Pacificzhong/humanoid_robot/others/Pictures/Untitled.JPG

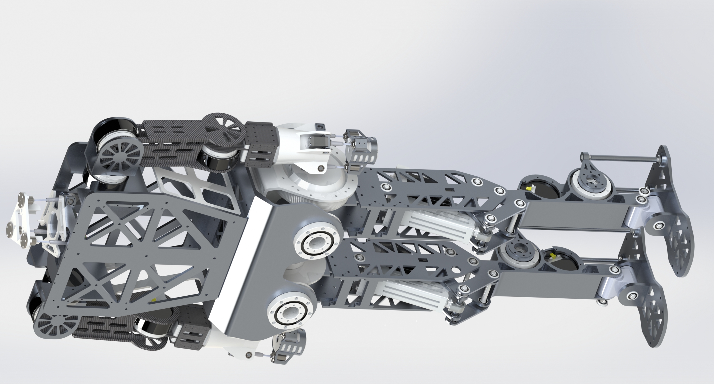
others/Pictures/Untitled.JPG
