Pacificzhong/humanoid_robot/others/Pictures/膝关节.JPG

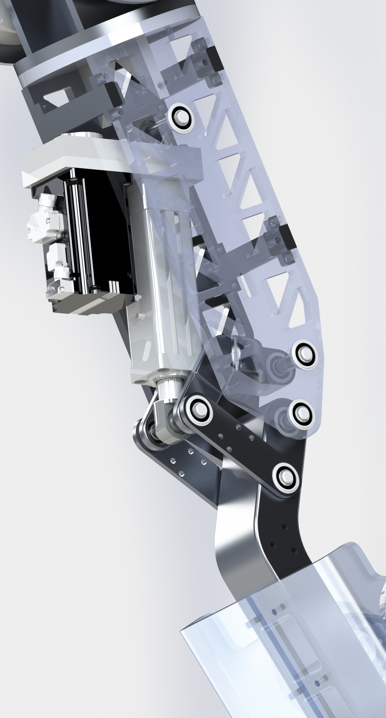
others/Pictures/膝关节.JPG
