Pacificzhong/humanoid_robot/others/Presentation/仲24.4.23人形机器人关键技术.pptx

直线电机驱动人形机器人—结构

- 面向工业制造场景对人形机器人需求，研发具有高稳定性的人形机器人结构，要求机器人具有高负载、高稳态、高效率。

- 核心零部件：行星滚轴丝杠直线电机

人形机器人本体

手臂结构

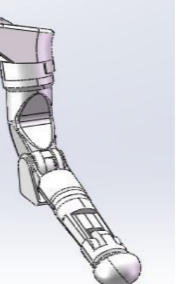
[picture p37: figure]
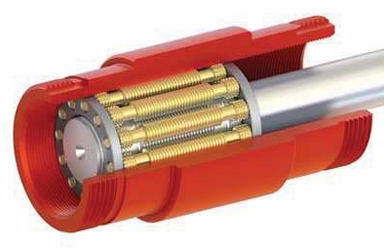
[picture p38: figure]

行星丝杠执行器

1.8kg自重→8000N
推力自重比：>400

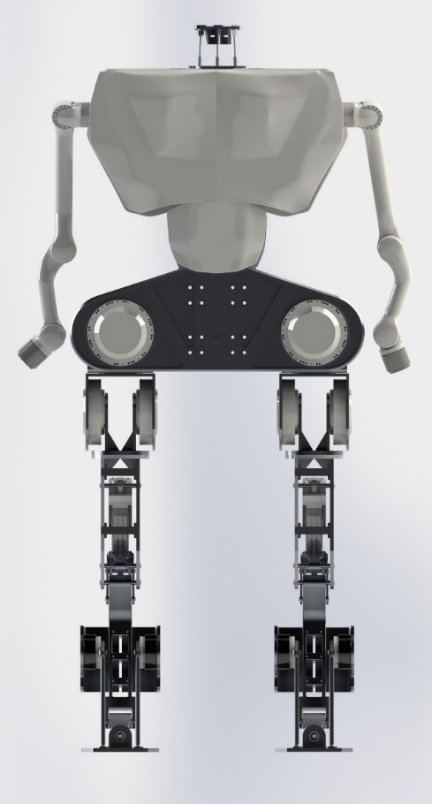
[picture p39: figure]

手腕并联结构

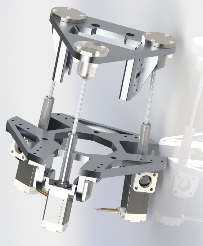
[picture p40: figure]

双足结构

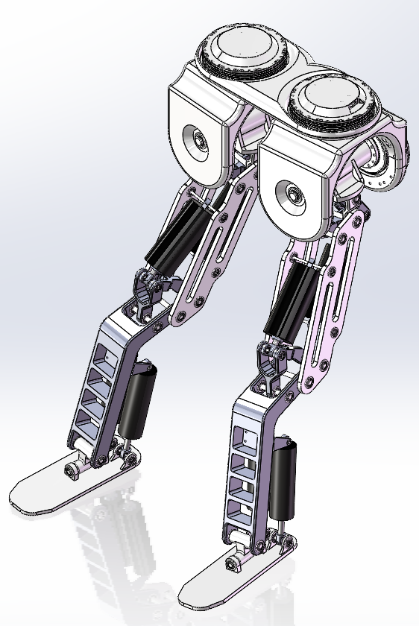
[picture p41: figure]
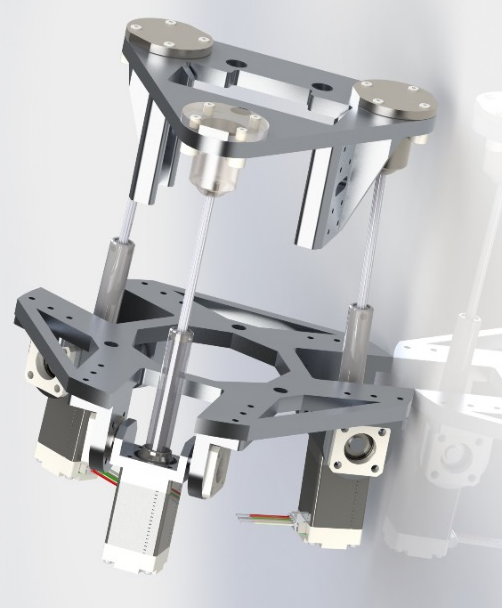
[picture p42: figure]

高推力→站得稳

3PRS结构→灵巧手腕

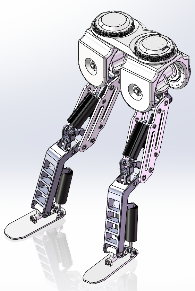
[picture p43: figure]

1

## Slide 2

直线电机驱动人形机器人—结构

- 面向工业制造场景对人形机器人需求，研发具有高稳定性的人形机器人结构，要求机器人具有高负载、高稳态、高效率。

人形机器人本体

手臂结构

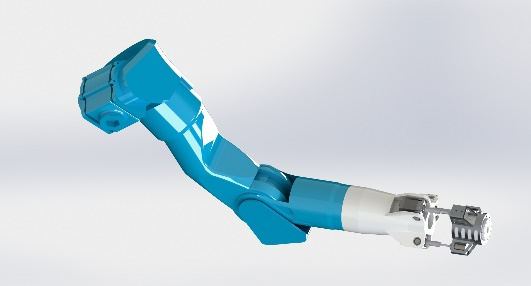
[picture p44: figure]

双足结构

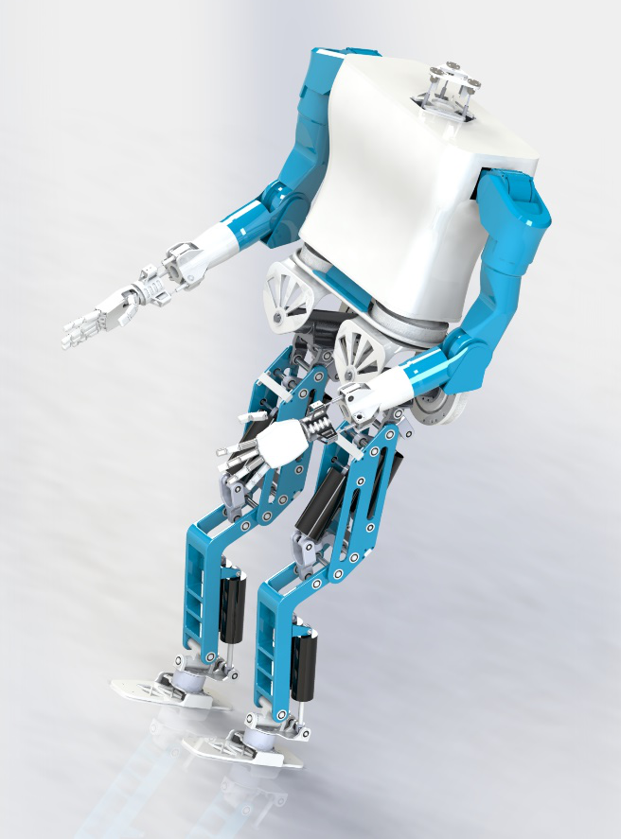
[picture p45: figure]
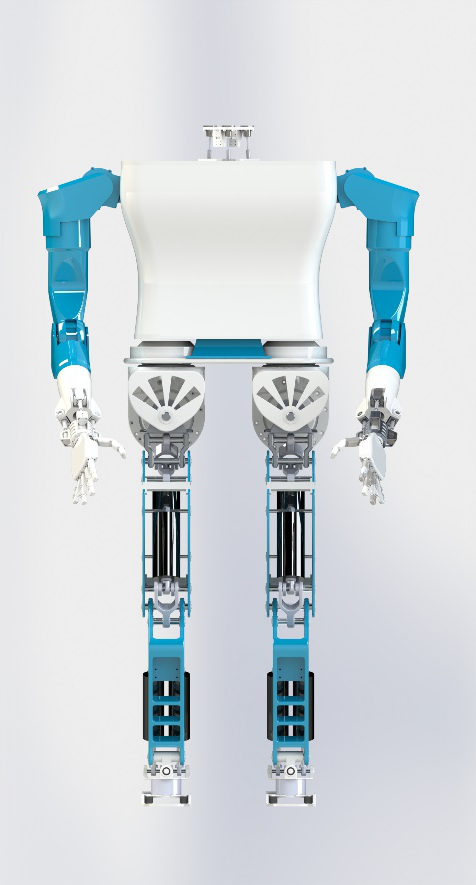
[picture p46: figure]
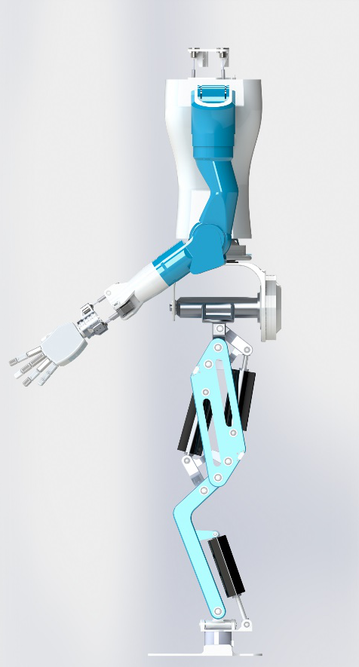
[picture p47: figure]
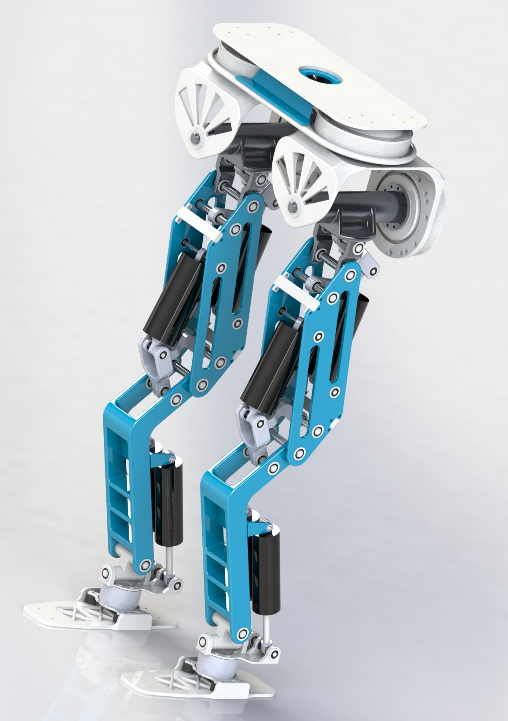
[picture p48: figure]

手腕并联结构

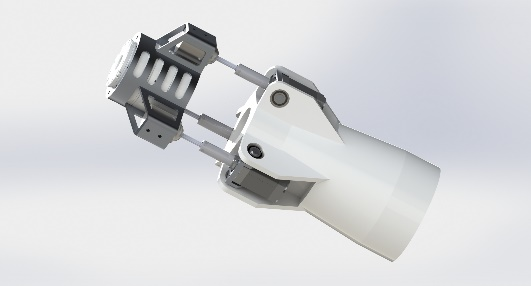
[picture p49: figure]

2

## Slide 3

直线电机驱动人形机器人—结构

- 面向工业制造场景对人形机器人需求，研发具有高稳定性的人形机器人结构，要求机器人具有高负载、高稳态、高效率。

- 核心零部件：行星滚轴丝杠直线电机

1.8kg自重→8000N
推力自重比：>400

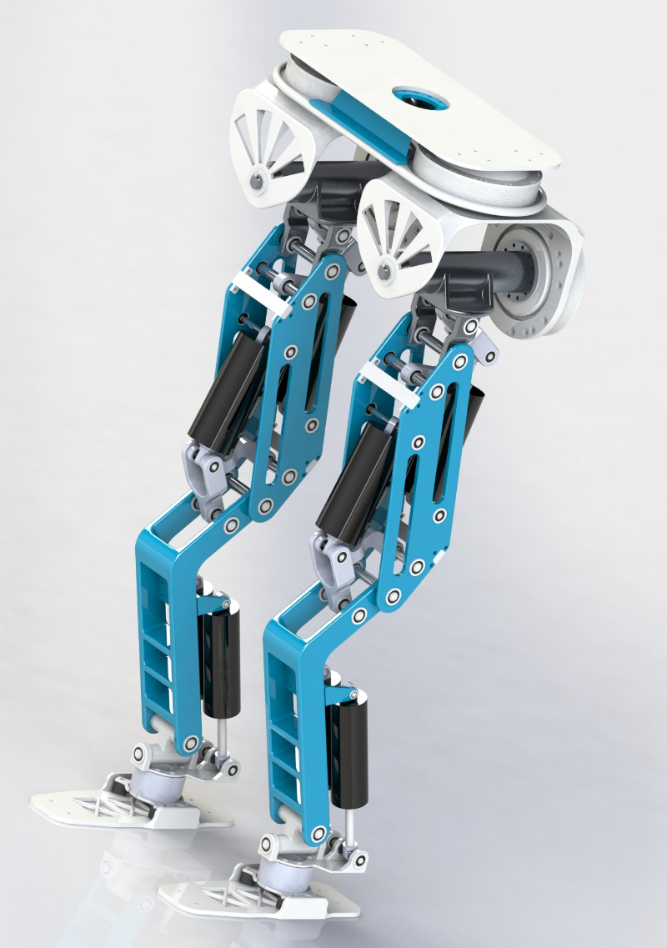
[picture p50: figure]

行星丝杠执行器

高推力→站得稳

3

## Slide 4

直线电机驱动人形机器人—感知

- 面向工业制造场景对人形机器人需求，搭配多维感知体系，助力人形机器人走得稳、抓得稳、导航准

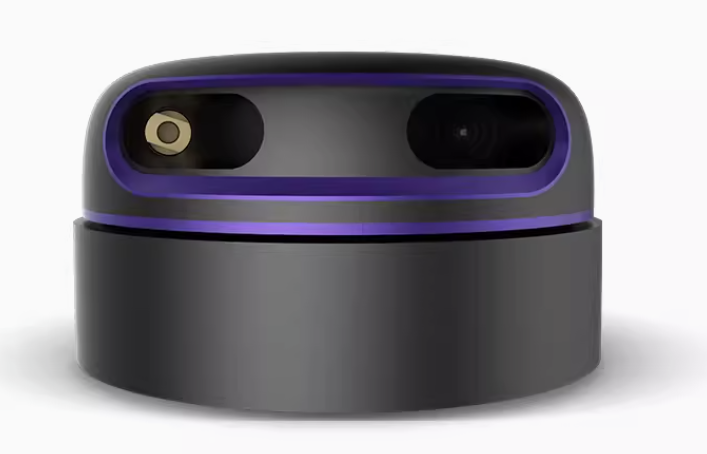
[picture p51: figure]

激光雷达、双目相机（还未完成联调）

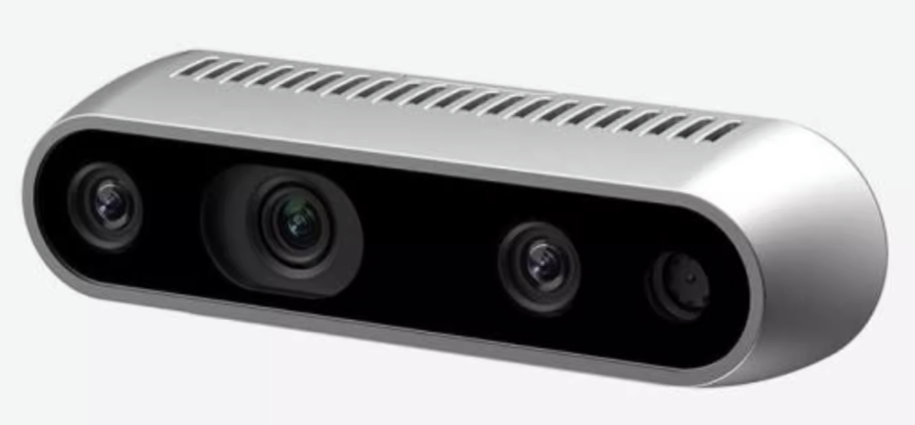
[picture p52: figure]
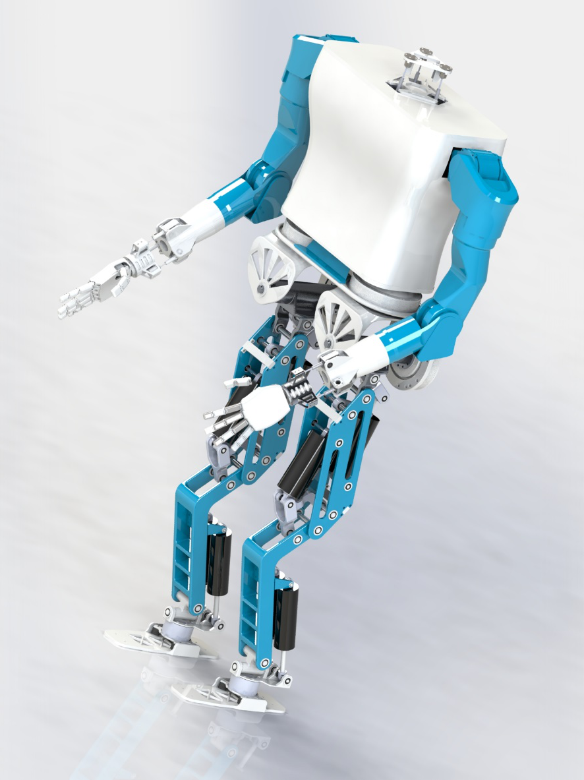
[picture p53: figure]

中央IMU

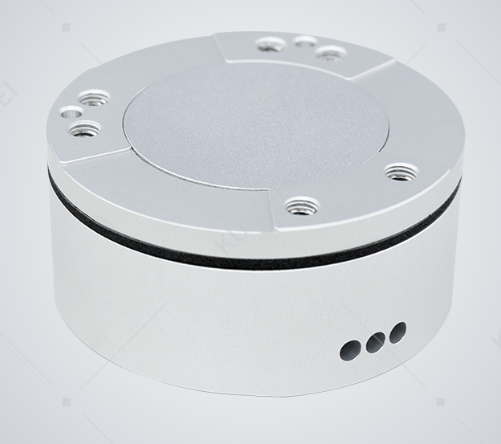
[picture p54: figure]

足底六维力传感器

4
