Pacificzhong/humanoid_robot/others/Pictures/4-六维力传感器.JPG

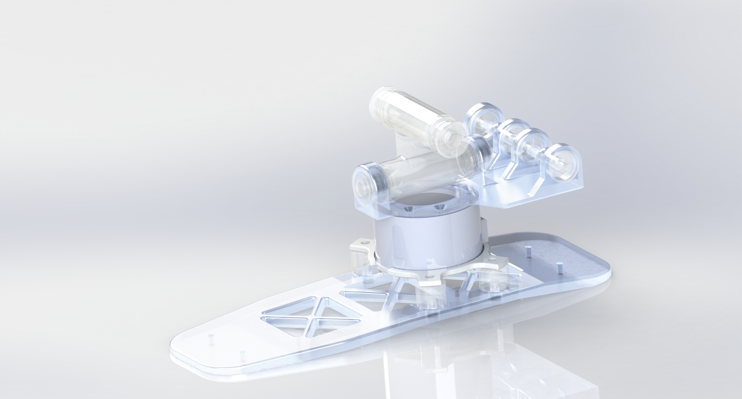
others/Pictures/4-六维力传感器.JPG
