Pacificzhong/humanoid_robot/others/Pictures/4-减震柱.JPG

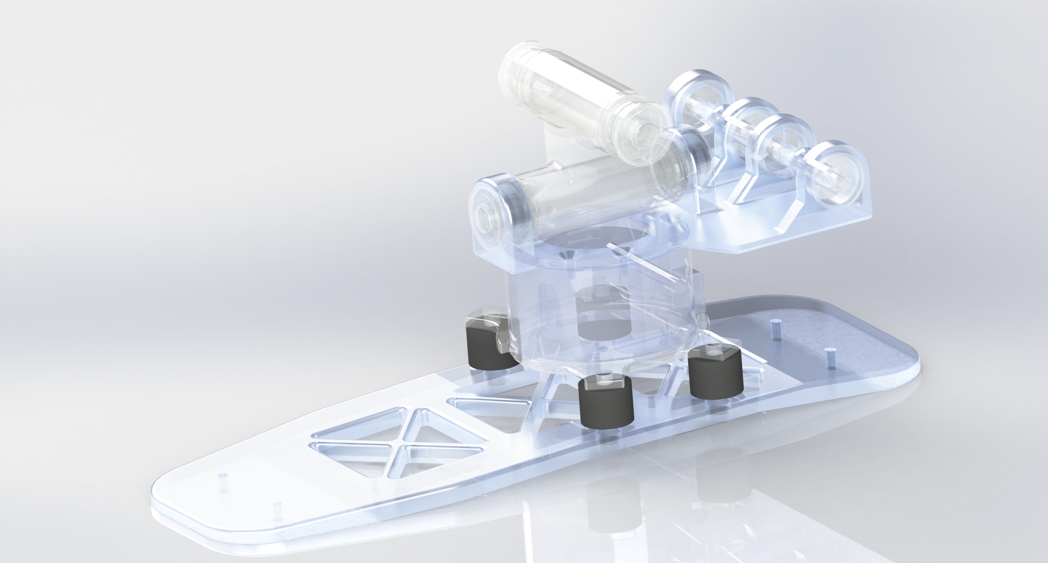
others/Pictures/4-减震柱.JPG
