Pacificzhong/humanoid_robot/others/Pictures/4-脚板.JPG

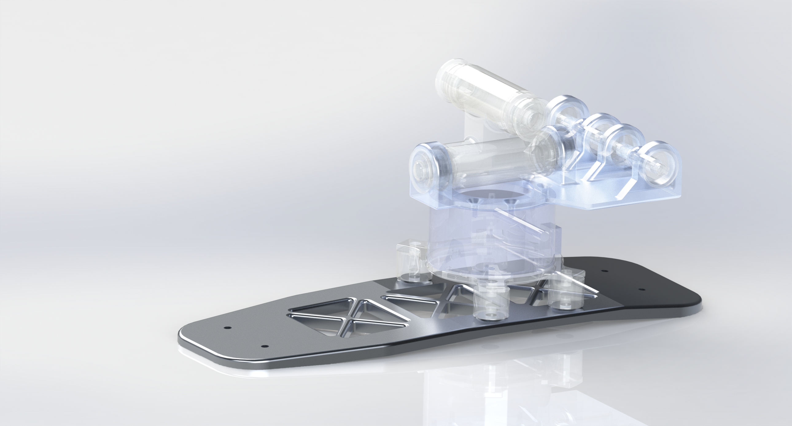
others/Pictures/4-脚板.JPG
