Pacificzhong/humanoid_robot/others/Pictures/4-踝.JPG

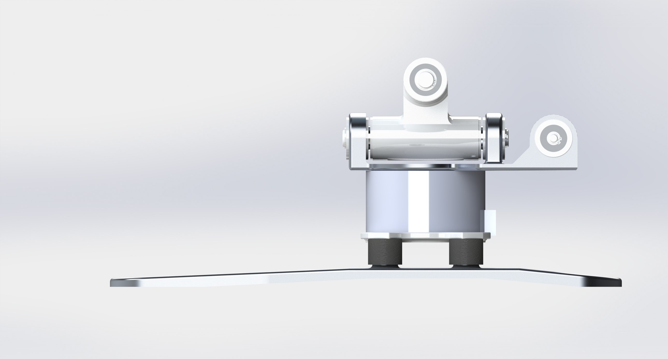
others/Pictures/4-踝.JPG
