Pacificzhong/humanoid_robot/others/Pictures/4-踝关节.JPG

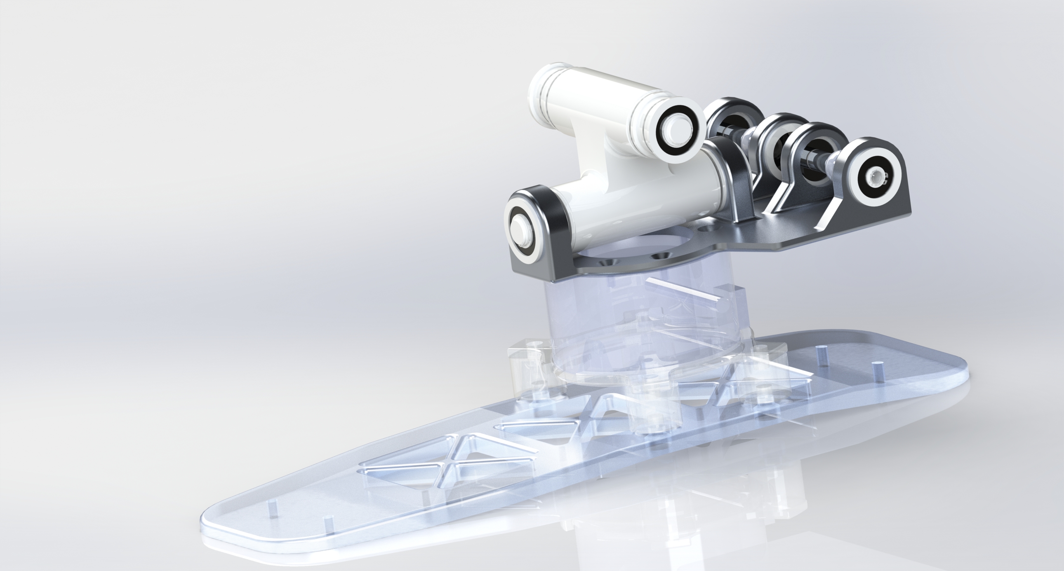
others/Pictures/4-踝关节.JPG
