Pacificzhong/humanoid_robot/others/Pictures/45°踢腿.JPG

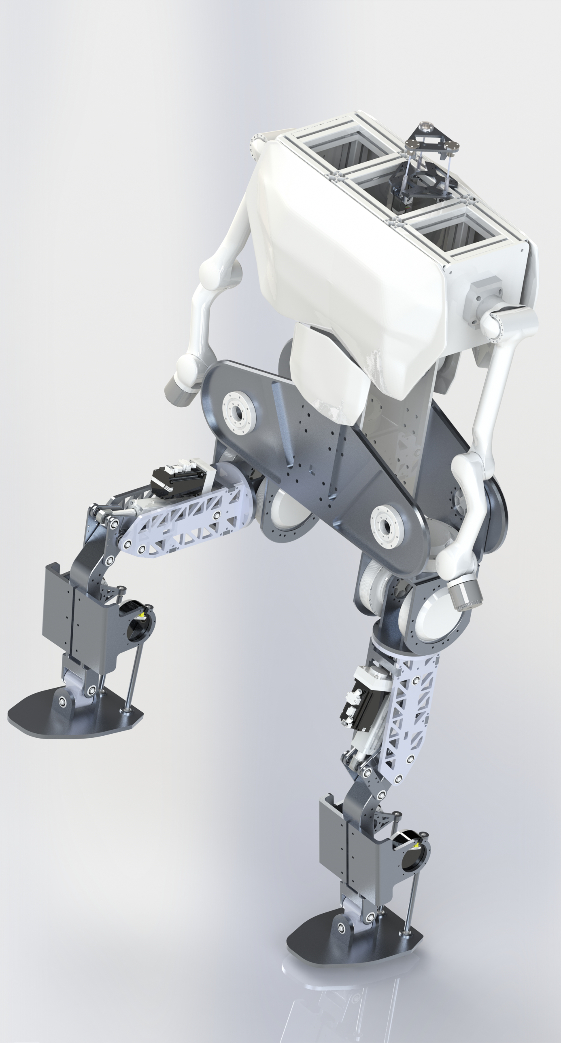
others/Pictures/45°踢腿.JPG
