Pacificzhong/humanoid_robot/others/Pictures/三代机大腿.JPG

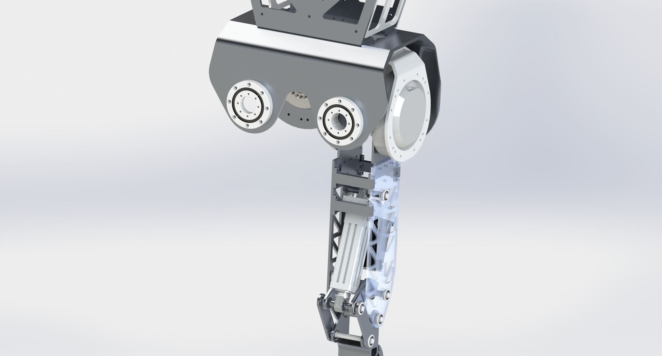
others/Pictures/三代机大腿.JPG
