Pacificzhong/humanoid_robot/others/Pictures/三代机脚踝.JPG

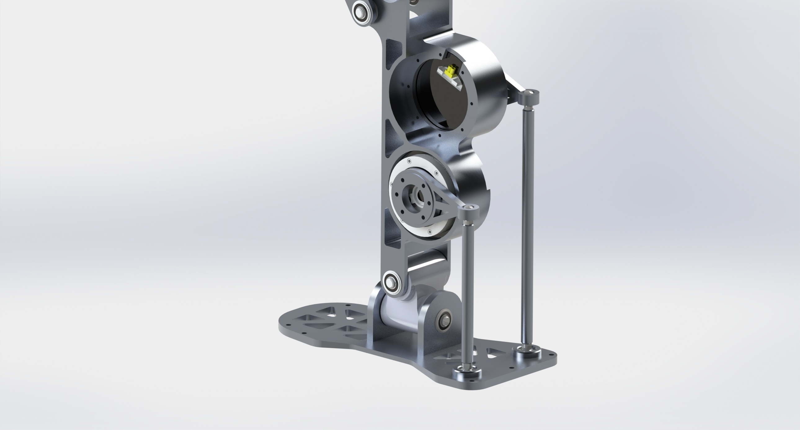
others/Pictures/三代机脚踝.JPG
