Pacificzhong/humanoid_robot/others/Pictures/三代机膝关节.JPG

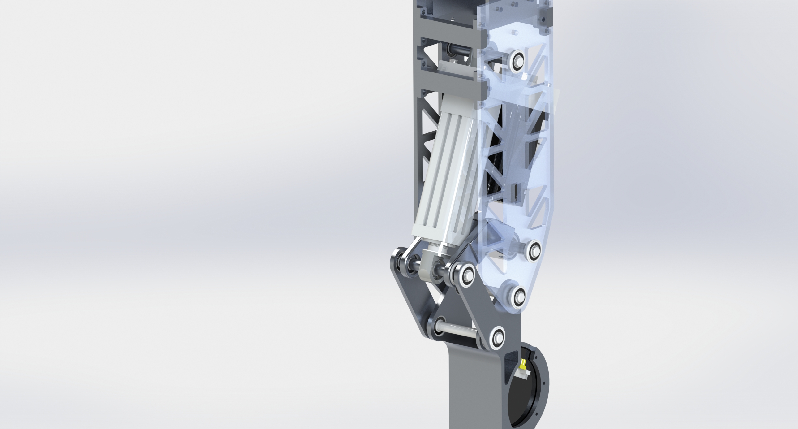
others/Pictures/三代机膝关节.JPG
