Pacificzhong/humanoid_robot/others/Pictures/三代机膝关节正视图-B.JPG

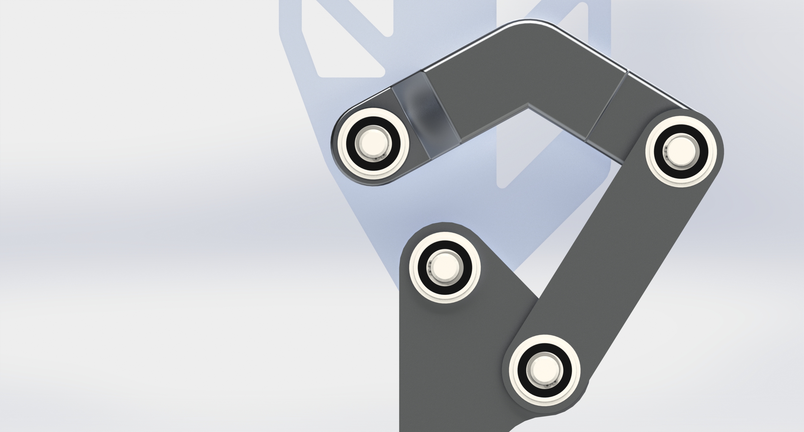
others/Pictures/三代机膝关节正视图-B.JPG
