Pacificzhong/humanoid_robot/others/Pictures/三自由度脖子.JPG

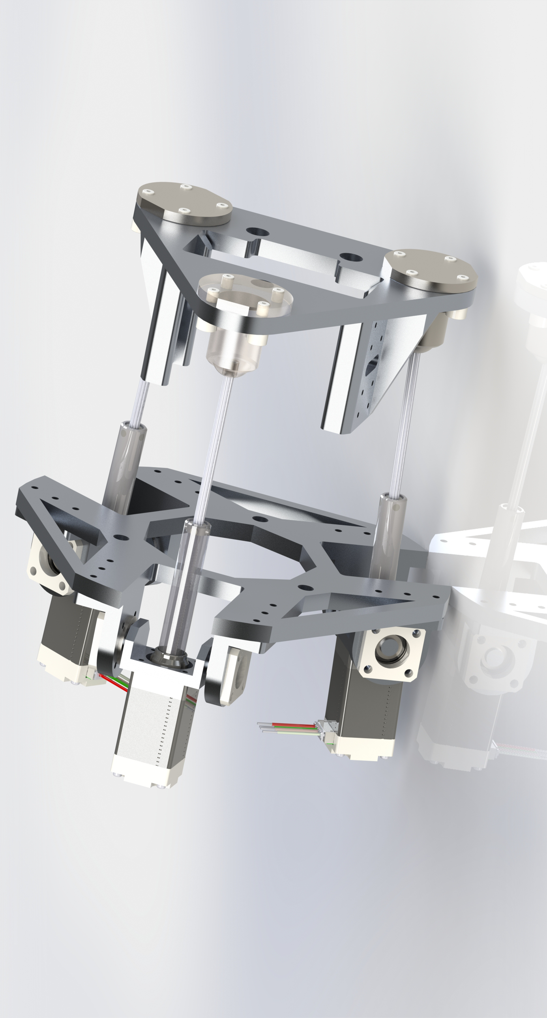
others/Pictures/三自由度脖子.JPG
