Pacificzhong/humanoid_robot/others/Pictures/下肢.JPG

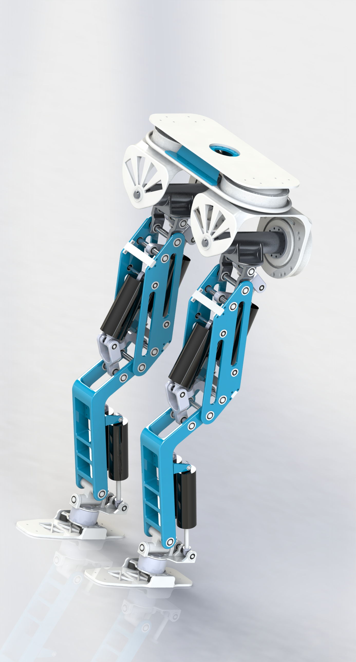
others/Pictures/下肢.JPG
