Pacificzhong/humanoid_robot/others/Pictures/二代机脚踝.JPG

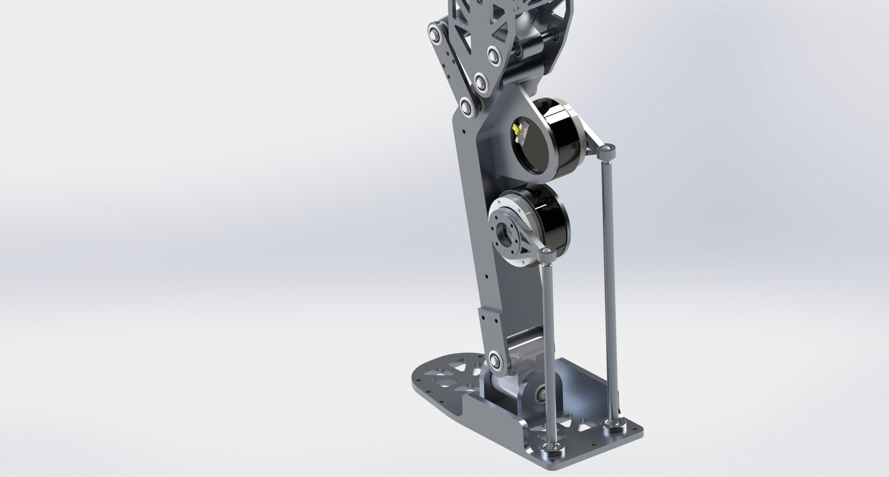
others/Pictures/二代机脚踝.JPG
