Pacificzhong/humanoid_robot/others/Pictures/侧视图.JPG

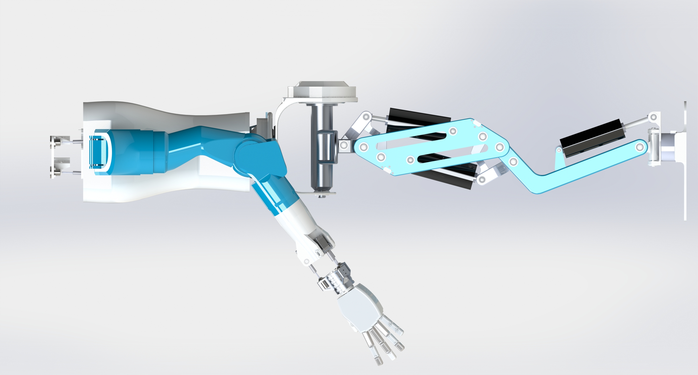
others/Pictures/侧视图.JPG
