Pacificzhong/humanoid_robot/others/Pictures/四代机大腿.JPG

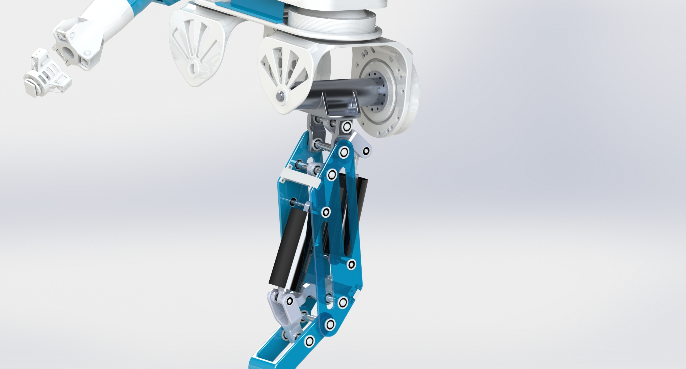
others/Pictures/四代机大腿.JPG
