Pacificzhong/humanoid_robot/others/Pictures/手腕.JPG

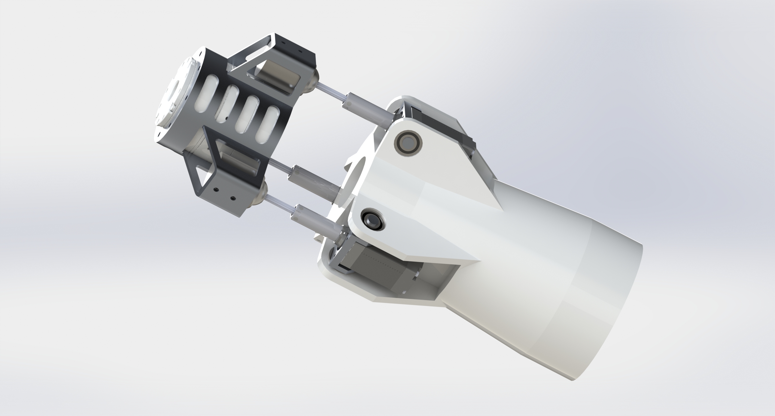
others/Pictures/手腕.JPG
