Pacificzhong/humanoid_robot/others/Pictures/手臂.JPG

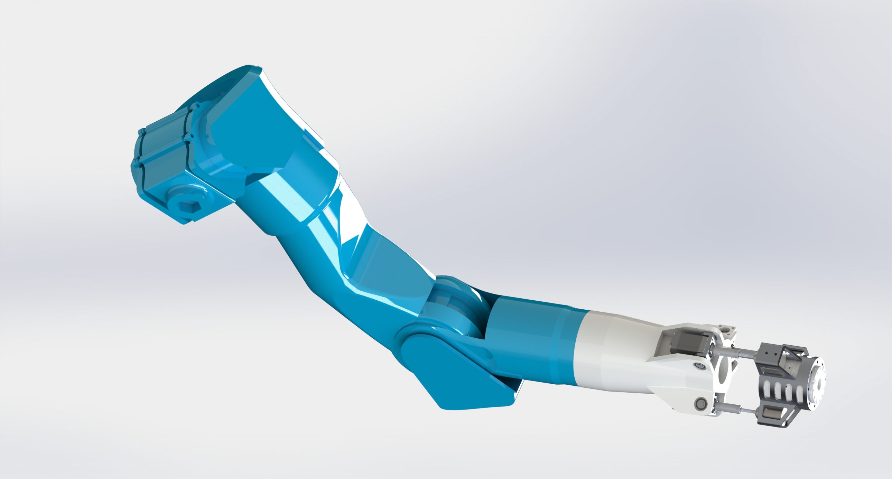
others/Pictures/手臂.JPG
