Pacificzhong/humanoid_robot/others/Pictures/正视图.JPG

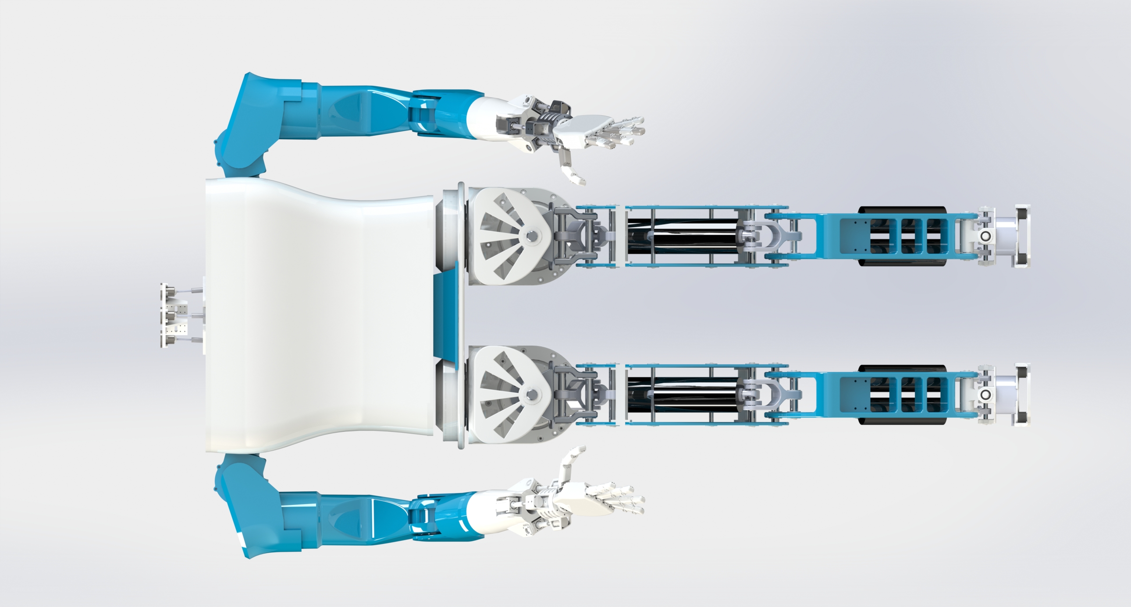
others/Pictures/正视图.JPG
