Pacificzhong/humanoid_robot/others/Pictures/立正侧面.JPG

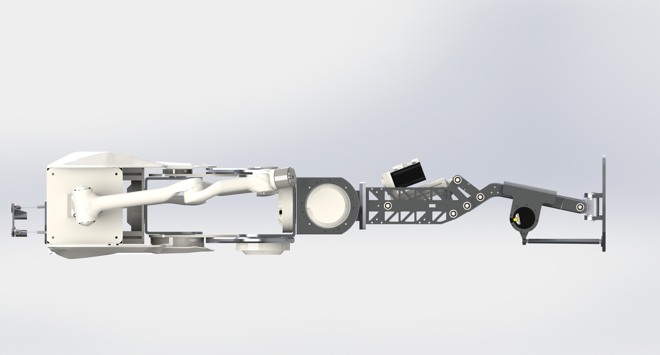
others/Pictures/立正侧面.JPG
