Pacificzhong/humanoid_robot/others/Pictures/立正后面.JPG

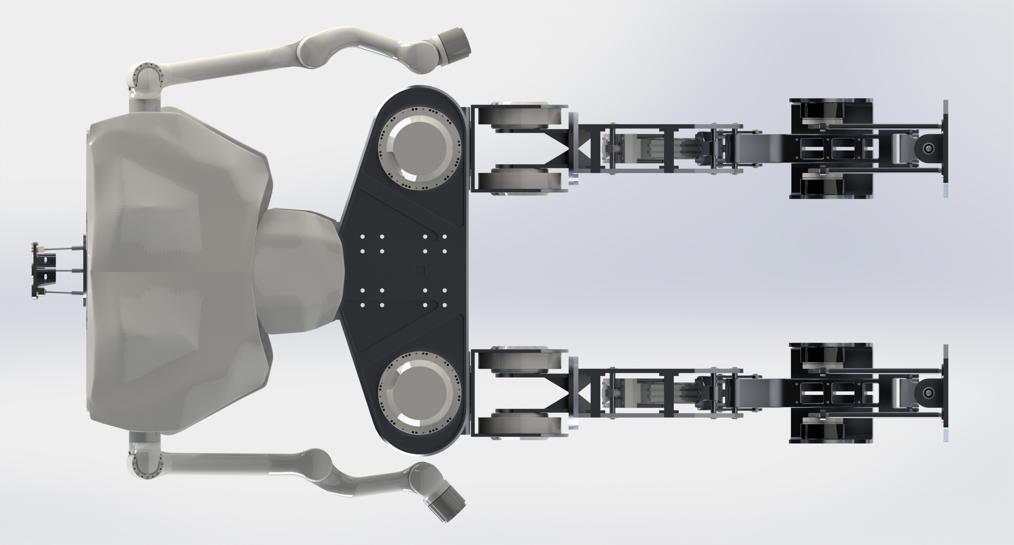
others/Pictures/立正后面.JPG
