Pacificzhong/humanoid_robot/others/Pictures/立正正面.JPG

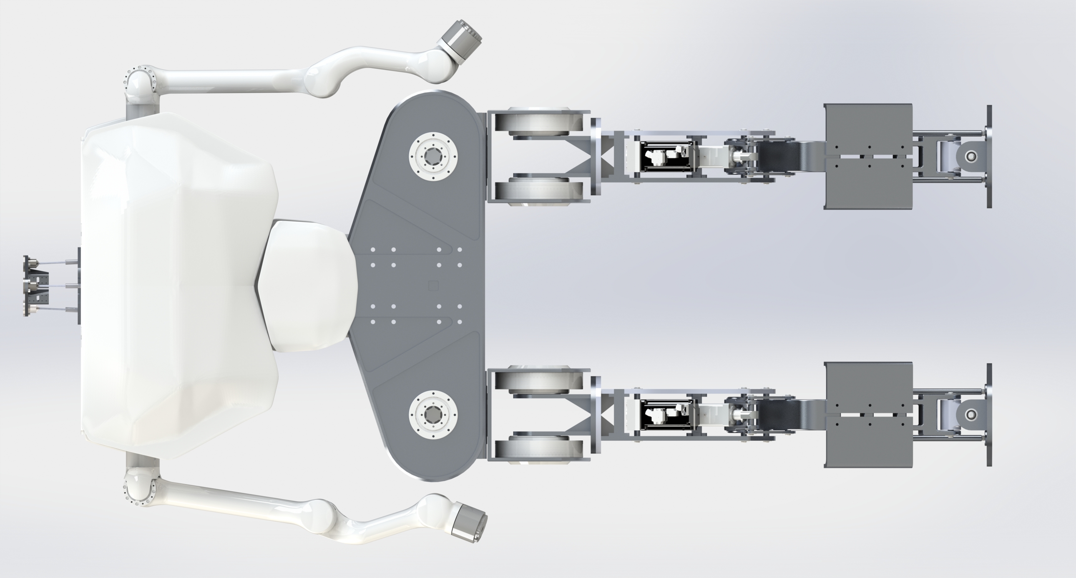
others/Pictures/立正正面.JPG
