Pacificzhong/humanoid_robot/component/人形BOM_1.5代（V2.10）.xlsx

序号 | 名称 | 型号 | 数量 | 购买渠道 | 用途描述 | 备注
非标件
 | 上肢正面骨架 |  | 2 |  |  | 所有直径为x.5的孔为通孔，直径为整数的孔为螺纹孔 手腕关节为3D打印件，胳膊为碳板，这两个零件后期独立加工
 | 脖子Y型安装版-铝合金 |  | 1
 | 打磨系统法兰改2.0 |  | 1 |  | 脖子
 | 云台 |  | 1 |  | 脖子
 | 回转座 |  | 3 |  | 脖子
 | 上臂R1连接板 |  | 2
 | 上臂R2连接板 |  | 2
 | 电缸座 |  | 6
 | 手腕电机座 |  | 2
 | 髋关节侧摆连接板 |  | 1
 | 髋关节前摆连接板 |  | 2
 | 髋关节前摆连接板-B |  | 2
 | 腿髋转接架侧板V2 |  | 2
 | 腿髋转接架侧板V2-B |  | 2
 | 大腿主干_适用于220-80推杆 |  | 4
 | 大腿主干_适用于191-80推杆 |  | 4 |  | 适用于滚柱丝杠
 | 大腿侧板连接V2 |  | 6
 | 膝盖上连杆_107.5V2 |  | 2
 | 膝关节下连杆_90 |  | 4
 | 小腿主干-电机嵌入式 |  | 1
 | 镜像小腿主干-电机嵌入式 |  | 1
 | 小腿电机摇杆A1 |  | 4
 | 踝关节连杆-短 |  | 2
 | 踝关节连杆-长 |  | 2
 | 脚踝十字连接 |  | 2
 | 球铰脚底板 |  | 2
 | 大腿_电机轴 | 其实是同一种轴 | 2
 | 上连杆大腿轴 |  | 2
 | 大腿小腿轴 |  | 2
 | 上下连杆轴 |  | 2
 | 下连杆小腿轴 |  | 2
 | 上踝关节轴 |  | 2
 | 踝关节轴 |  | 2
 | 轴套V2 | d10L34.75大腿板与电机 | 4
 | 轴套 | d10L25.75大腿上连杆 | 4
 | 轴套 | d10L4大小腿 | 8
 | 轴套V2 | d10L22上连杆与推杆 | 4
 | 轴套V2 | d10L6.75上下连杆 | 4
 | 轴套V2 | d10L1.75踝关节 | 4
 | 轴套 | d10L4.75踝关节 | 4
标准件
 | 轴用挡圈 | GB894-10 | 若干
 | 轴用挡圈 | GB894-5 | 若干
 | 孔用挡圈 | GB893-18 | 若干
 | NSK轴承 | 6900NR | 36
 | 回转支撑 | GL_XRU3515UUCC0P5 | 4
 | 关节轴承 | SQD6 | 4
 | M8梯形螺母与配套螺栓 | 螺栓长度以能够顺利装配为准 | 若干
 | M5杯头螺栓与防松螺母 |  | 若干
 | M5杯头螺栓 | M5*18+1~2个垫圈 | 若干 |  | B1输出轴
 | M4杯头螺栓 | M4*20+1~2个垫圈 | 若干 |  | A1输出轴
 | M3杯头螺栓与防松螺母 | M3*14+1~2个垫圈 | 若干 |  | A1主体
