Pacificzhong/humanoid_robot/component/一代机螺栓.xlsx

用途 | 数量 | 直径 | 长度 | 购买数量 | 总价格
小腿电机安装板与小腿 | 12 | M5 | 50 | 50 | 21.5
小腿电机安装板与小腿电机 | 32 | M3 | 12 | 100 | 16
小腿电机-摇杆 | 24 | M4 | 18 | 100（M4*16） | 20
大腿板-大腿连接板 | 36 | M5 | 15 | 100(M5*16) | 20
大腿主干上板-腿髋转接架底座 | 8 | M5 | 20 | 50 | 15.5
大腿主干上板-大腿板 | 8 | M5 | 15 | 上面有
大腿主干上板-腿髋转接架连接板 | 4 | M5 | 70 | 20 | 17.5
腿髋转接架底座-腿髋转接架侧板 | 8 | M5 | 15 | 上面有
腿髋转接架连接板-腿髋转接架侧板 | 4 | M5 | 11 | 100(M5*10) | 18.5
B1电机输出轴连接 | 12*8=96 | M5 | 16 | 100(M5*16） | 20
B1电机安装 | 16*4=64 | M5 | 40 | 100 | 39
B1电机安装 | 16*4=64 | M5 | 45 | 100 | 41
B2电机安装 | 16*4=64 | M5螺母
旋转支撑内环 | 16 | M4 | 35 | 50 | 18.5
旋转支撑外环 | 16 | M4 | 20 | 50 | 15.5
上肢安装 | 16 | M8 | 20 | 20 | 15.5
上肢安装 | 16 | M8螺母
胳膊安装 | 8 | M6 | 16 | 50 | 16.5
胳膊安装 | 8 | M6螺母
