Pacificzhong/humanoid_robot/component/人形BOM_V2.4.xlsx

序号 | 名称 | 型号 | 数量 | 购买渠道 | 用途描述 | 备注
非标件 |  |  |  |  |  | 本表格于3月7日更新，相对V2.11版本，所有新增或修改项目将标注，未标注的为老版本
 | 髋一级连接板 | 非标 | 1 |  |  | 更新
 | 髋一级连接板-B | 非标 | 1
 | 髋二级连接板 | 非标 | 2 |  |  | 更新
 | 髋三级连接板 | 非标 | 2
 | 轴套 | 非标-d5L40.5大腿板与电机 | 4
 | 轴套 | 非标-d10L30大腿上连杆 | 4
 | 轴套 | 非标-d5L5上下连杆 | 4
 | 轴套 | 非标-d5L15.5上连杆与推杆 | 4
 | 轴套 | 非标-d10L15大小腿 | 4
 | 轴套 | 非标-d10L1小腿下连杆 | 4
 | 轴套 | 非标-d10L6踝关节 | 8
 | 腿髋转接架侧板 | 非标 | 4
 | 腿髋转接架连接板V2 | 非标 | 4
 | 腿髋转接架底座v2 | 非标 | 2
 | 大腿主干_上板V2 | 非标 | 2
 | 大腿主干_右侧板V2 | 非标 | 2 |  |  | 更新
 | 大腿主干_左侧板V2 | 非标 | 2 |  |  | 更新
 | 大腿侧板连接V2 | 非标 | 6
 | 大腿主干_连接块 | 非标 | 4
 | 大腿电机轴 | 非标 | 2
 | 膝盖上连杆 | 非标 | 2 |  |  | 更新
 | 膝盖下连杆 | 非标 | 2 |  |  | 更新
 | 上连杆大腿轴 | 非标 | 2
 | 上下连杆轴 | 非标 | 2
 | 大腿小腿轴 | 非标 | 2
 | 下连杆小腿轴 | 非标 | 2
 | 小腿主干 | 非标 | 2
 | 脚踝十字连接 | 非标 | 2
 | 踝关节轴 | 非标 | 4
 | 球铰脚底板 | 非标 | 2
 | 小腿左侧电机安装版A1 | 非标 | 2
 | 小腿右侧电机安装版A1 | 非标 | 2
 | 小腿电机摇杆A1 | 非标 | 4 |  |  | 卡簧槽能否加工
 | 踝关节连杆 | 非标 | 4 |  |  | 攻螺纹孔，能把球铰杆完全旋进就可以
 | 横梁滑块链接块 | 非标 | 2
 | 踝关节直立固定棒 | 非标 | 2
 | 踝关节直立固定棒_盖 | 非标 | 4
 | Z1机械臂安装版 | 非标 | 2 |  |  | 更新
 | 腰部旋转电机连接板 | 非标 | 1 |  |  | 更新
 | 腰部侧摆旋转支撑连接板 | 非标 | 1 |  |  | 更新
 | 腰部侧摆电机连接板 | 非标 | 1 |  |  | 更新
 | 上肢底板 | 非标 | 1 |  |  | 更新
标准件
 | 轴用挡圈 | GB894-10 | 若干
 | 轴用挡圈 | GB894-5 | 若干
 | 孔用挡圈 | GB893-18 | 若干
 | NSK轴承 | 635 | 12 |  |  | 不需要了直线电机固定端*4；上下连杆连接*8
 | NSK轴承 | 6900NR | 34 |  |  | 大腿板*12；上连杆*8；下连杆*8；小腿上端*8；小腿下端*4；脚踝十字连接*8；脚底板*4；
 | 回转支撑 | GL_XRU3515UUCC0P5 | 3
 | 关节轴承 | SQD6 | 4
 | 型材 | 6060 | 见2.11（原）图纸
 | 角码 | 6060 | 8
 | 型材 | 4040 | 见图纸 |  |  | 更新
 | M8梯形螺母与配套螺栓 | 螺栓长度以能够顺利装配为准 | 若干 |  |  | 连接：横梁滑块连接块；髋关节一级连接板；髋关节一级连接板_B；
 | M5杯头螺栓与防松螺母 |  | 若干
 | M5杯头螺栓 | M5*18+1~2个垫圈 | 若干 |  | B1输出轴 | 模型存在误差，安装电机时，注意不要损伤电机
 | M4杯头螺栓 | M4*20+1~2个垫圈 | 若干 |  | A1输出轴 | 模型存在误差，安装电机时，注意不要损伤电机
 | M3杯头螺栓与防松螺母 | M3*14+1~2个垫圈 | 若干 |  | A1主体 | 模型存在误差，安装电机时，注意不要损伤电机
