Pacificzhong/humanoid_robot/component/进口丝杠执行器报价.xlsx

道臣（天津）自动化设备有限公司
DOSON (Tianjin) Automation Equipment Co., Ltd.
收件方/To： | 华中科技大学 |  | 发件方/Form： | 道臣（天津）自动化设备有限公司
收件人/ATTN： |  |  | 发件人/Sender： | 王秋实
电话/Tel： |  |  | 电话/Tel： | 18611115759
传真/Fax： |  |  | 传真/Fax： | 010-65467868
邮箱/E-mail： |  |  | 邮箱/E-mail： | 18611115759@163.com
手机/Mobile： |  |  | 手机/Mobile： | 18611115759
报价时间：2024-1-22 报价编号：DS20240122WQS01
文件主题Subject： www.gsa-rollvis.com
报价单Quotation
产品名称 | 品牌 | 规格型号 |  | 精度 | 数量 | 单价 含税 (CNY元) | 合计 含税 (CNY元)
行星滚柱丝杠一体电动缸（反转类） | jwmc | SEA801-188 |  | G5 | 1 | 21480 | 21480
 | jwmc | SEA801-189 |  | G5 | 1 | 19000 | 19000
 | 优仕特 | 10.5*2 |  | G5 | 2 | 12000 | 24000
 | jwmc | SEA801-188 |  | G5 | 5 | 19200
 | jwmc | SEA801-189 |  | G5 | 5 | 17800
 | 优仕特 | 10.5*2 |  | G5 | 10 | 8000
 |  | 交货期：12周++运输和通关2周，合计14周
 |  |  |  |  |  |  | 货期12-14周
 |  | 台湾制造 原装进口
 |  |  |  |  |  | 总计： | 64480
备注：1，质保期：12个月
2，付款方式：30%预付，60%发货前付清,10%验收。
3，包括运费，税费，等一切费用。
