Pacificzhong/humanoid_robot/3D_models/Proto/装配.SLDASM

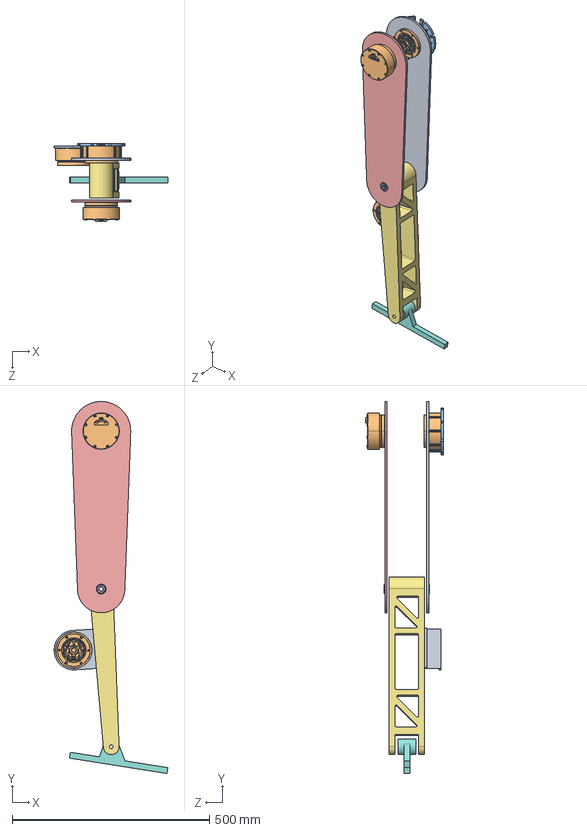
[picture p113: CAD file, 2024-03-29]
3D_models/Proto/装配.SLDASM
288.1 x 942.0 x 198.0 mm
大腿外侧板
A1电机 x 3
A1电机盖板
铜柱M3-31 x 7
大腿内侧板
轴承_NSK6900NR x 2
小腿主干
脚
小腿A1电机安装
