Pacificzhong/humanoid_robot/3D_models/V3.0.8_4.24/脚踝.SLDASM

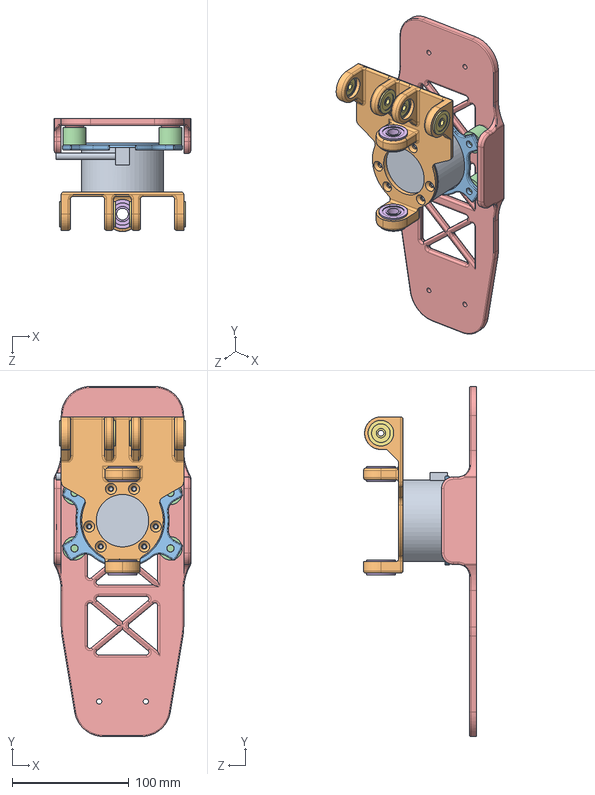
[picture p114: CAD file, 2024-05-09]
3D_models/V3.0.8_4.24/脚踝.SLDASM
117.0 x 300.0 x 97.0 mm
六轴力_力矩传感器
脚踝上支承板
脚踝中支承板
橡胶减震柱2015DE06 x 4
脚掌
法兰轴承10_22_6 x 4
法兰轴承5-19-6 x 4
