Pacificzhong/humanoid_robot/3D_models/V3.0.8_4.24/脚踝推杆.SLDASM

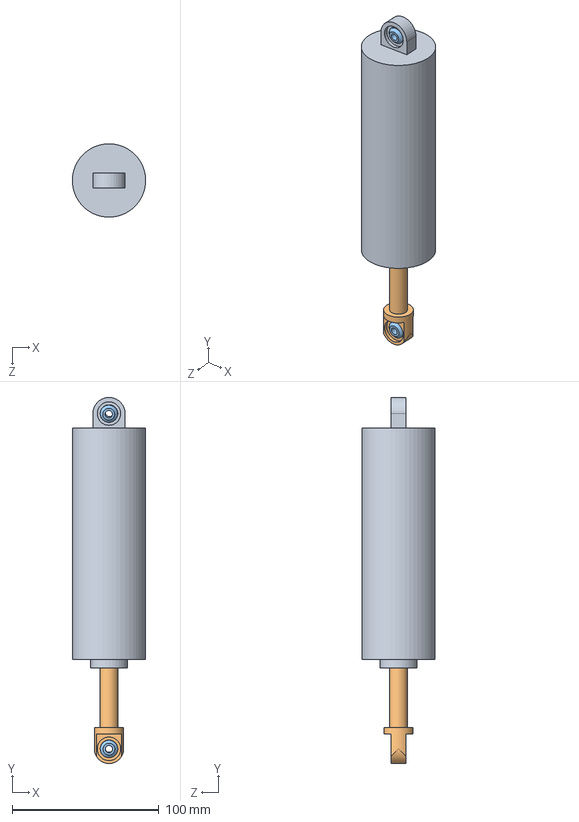
[picture p115: CAD file, 2024-05-09]
3D_models/V3.0.8_4.24/脚踝推杆.SLDASM
50.0 x 249.4 x 50.0 mm
脚踝推杆本体
脚踝推杆伸缩杆
脚踝推杆球头 x 2
