Pacificzhong/humanoid_robot/vreplearning/装配体1.SLDASM

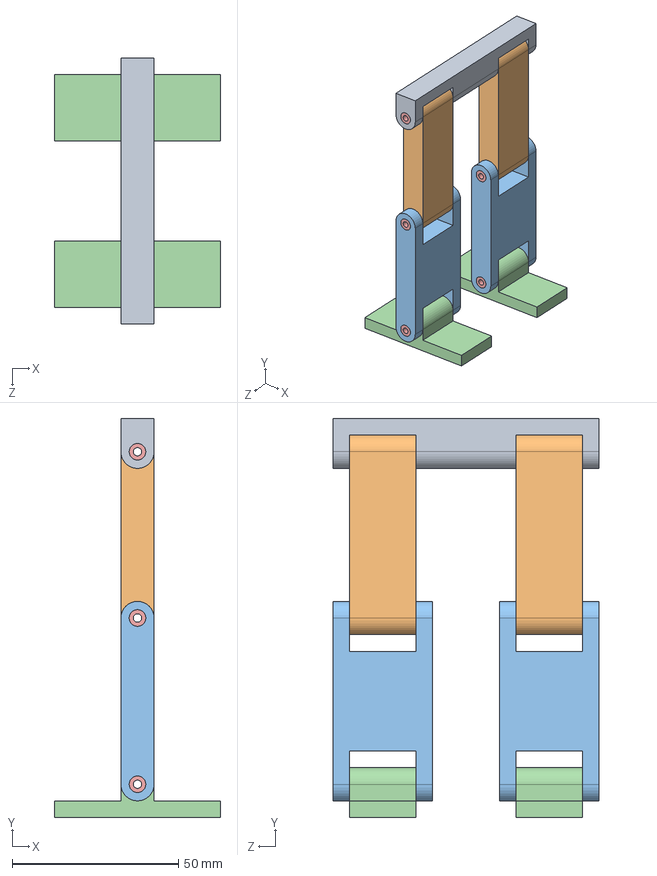
[picture p116: CAD file, 2024-04-14]
vreplearning/装配体1.SLDASM
50.0 x 120.0 x 80.0 mm
髋
大腿 x 2
小腿 x 2
feet x 2
轴承 x 24
