Pacificzhong/humanoid_robot/3D_models/V3.0.8_4.24/膝髋推杆.SLDASM

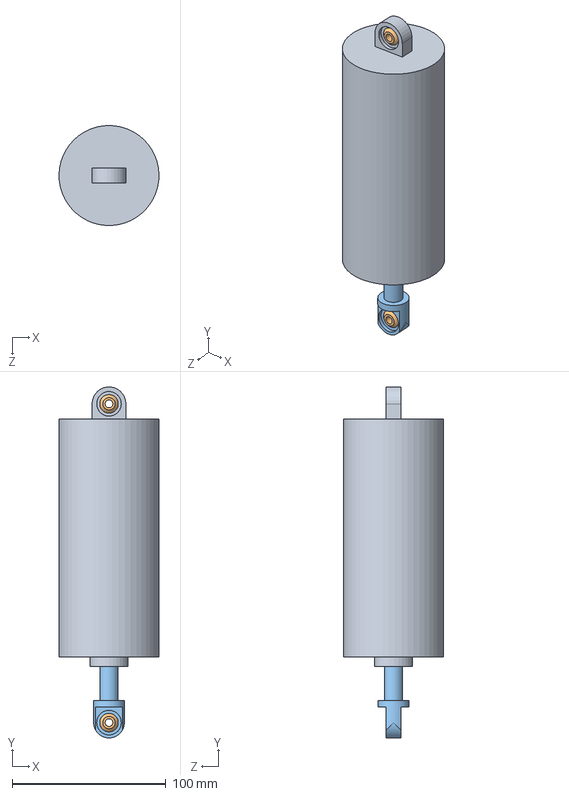
[picture p117: CAD file, 2024-05-09]
3D_models/V3.0.8_4.24/膝髋推杆.SLDASM
65.0 x 228.1 x 65.0 mm
膝髋推杆本体
脚踝推杆球头 x 2
脚踝推杆伸缩杆
