Pacificzhong/humanoid_robot/3D_models/V2.8_24.4.29-carbon/B1电机模型.SLDPRT

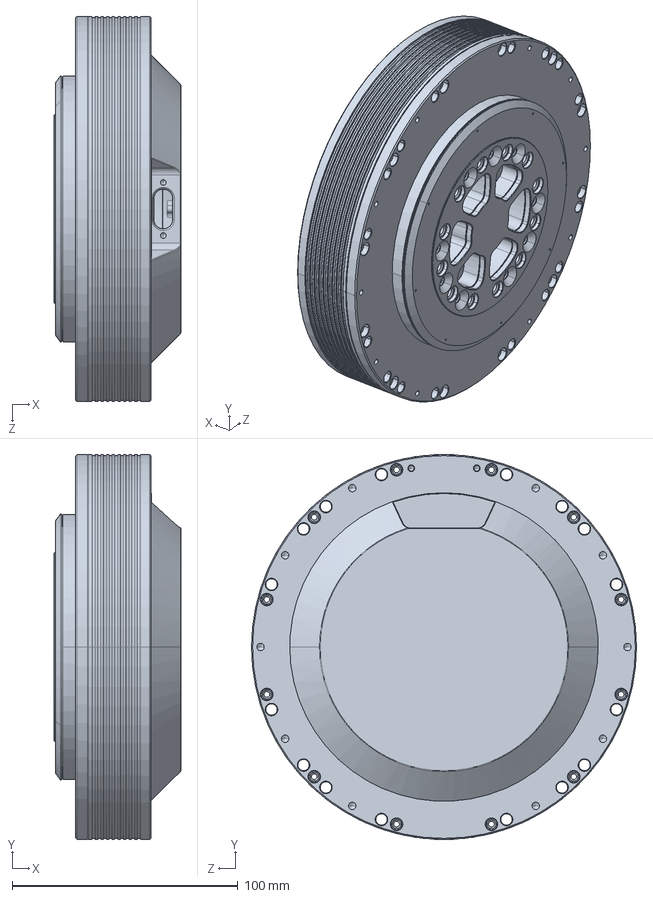
[picture p118: CAD file, 2024-04-30]
3D_models/V2.8_24.4.29-carbon/B1电机模型.SLDPRT
56.1 x 170.5 x 170.5 mm
