Pacificzhong/humanoid_robot/3D_models/V2.8_24.4.29-carbon/crus/小腿主干_外12.SLDPRT

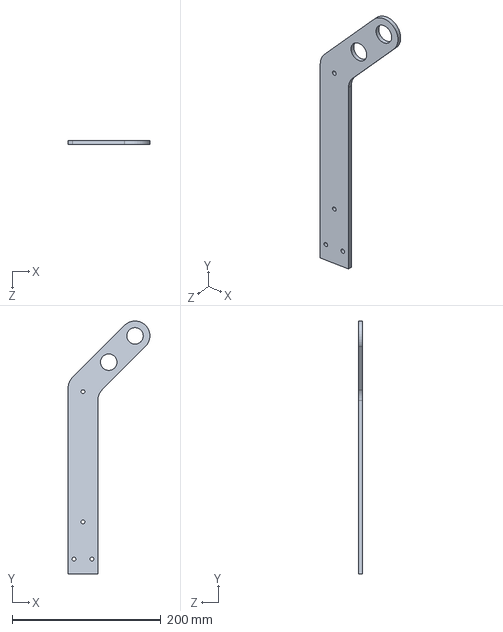
[picture p119: CAD file, 2024-04-29]
3D_models/V2.8_24.4.29-carbon/crus/小腿主干_外12.SLDPRT
110.0 x 340.0 x 5.00 mm
