Pacificzhong/humanoid_robot/3D_models/V2.8_24.4.29-carbon/Shell/人形机器人stl/胸.STL

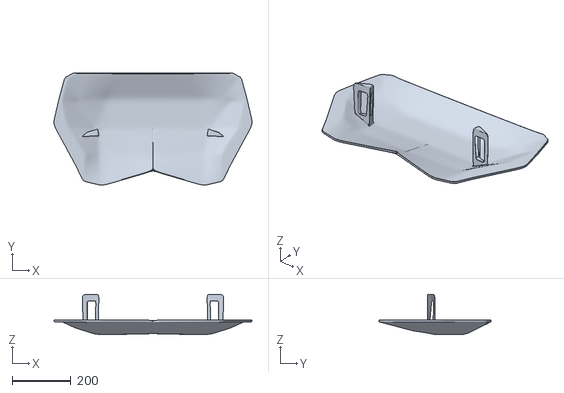
[picture p120: CAD file, 2024-04-14]
3D_models/V2.8_24.4.29-carbon/Shell/人形机器人stl/胸.STL
673.6 x 381.6 x 136.5
