Pacificzhong/humanoid_robot/component/参考执行器与第一版人形机器人模型/A-81189rev.A SEA801-189v2踝关节腕关节线性执行器.STEP

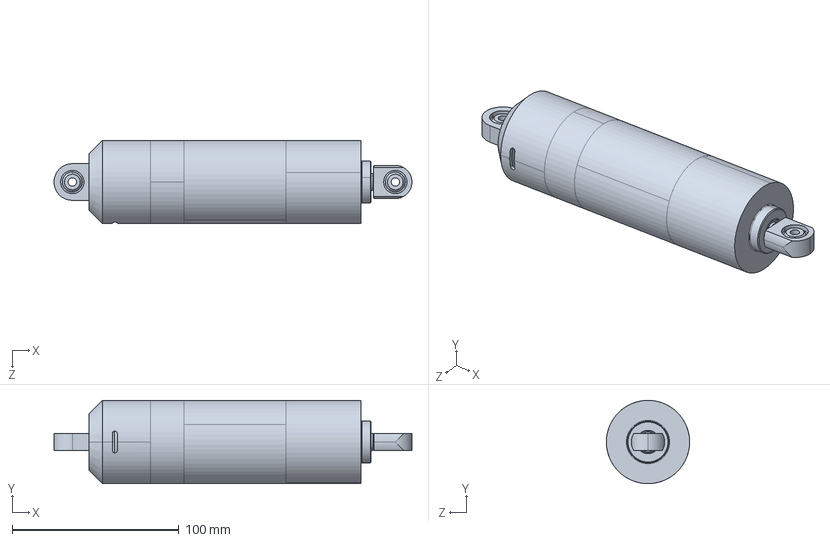
[picture p121: CAD file, 2024-05-05]
component/参考执行器与第一版人形机器人模型/A-81189rev.A SEA801-189v2踝关节腕关节线性执行器.STEP
214.9 x 50.0 x 50.0 mm
