Pacificzhong/humanoid_robot/vreplearning/大腿.SLDPRT

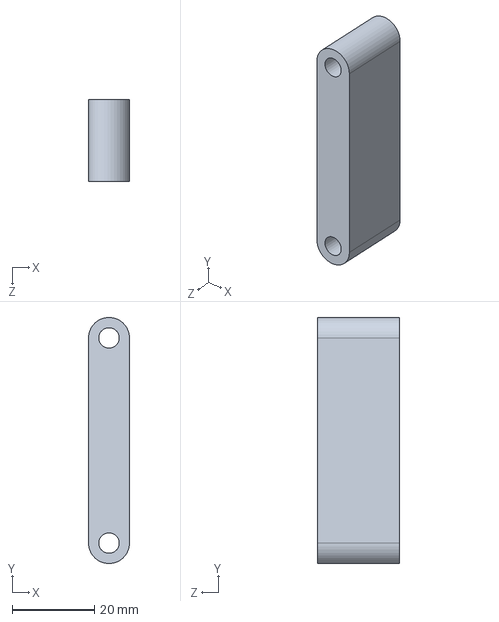
[picture p122: CAD file, 2024-04-14]
vreplearning/大腿.SLDPRT
10.0 x 60.0 x 20.0 mm
