Pacificzhong/humanoid_robot/3D_models/Proto/脚.SLDPRT

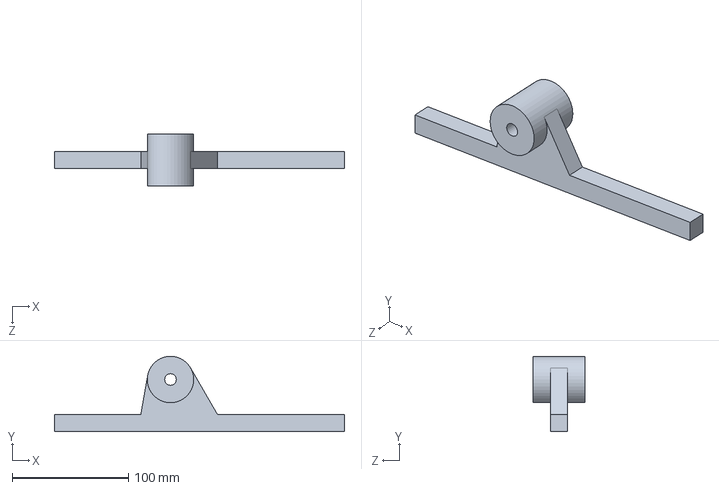
[picture p123: CAD file, 2024-03-29]
3D_models/Proto/脚.SLDPRT
250.0 x 65.0 x 45.0 mm
