Pacificzhong/humanoid_robot/3D_models/V2.8_24.4.29-carbon/Shell/人形机器人stl/腹.STL

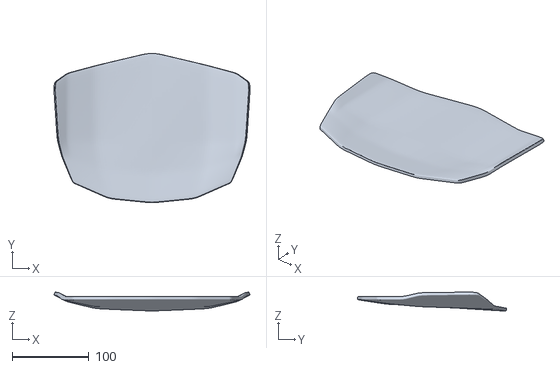
[picture p124: CAD file, 2024-04-14]
3D_models/V2.8_24.4.29-carbon/Shell/人形机器人stl/腹.STL
255.0 x 194.1 x 24.4
