Pacificzhong/humanoid_robot/3D_models/V2.8_24.4.29-carbon/髋一级连接板_B.SLDPRT

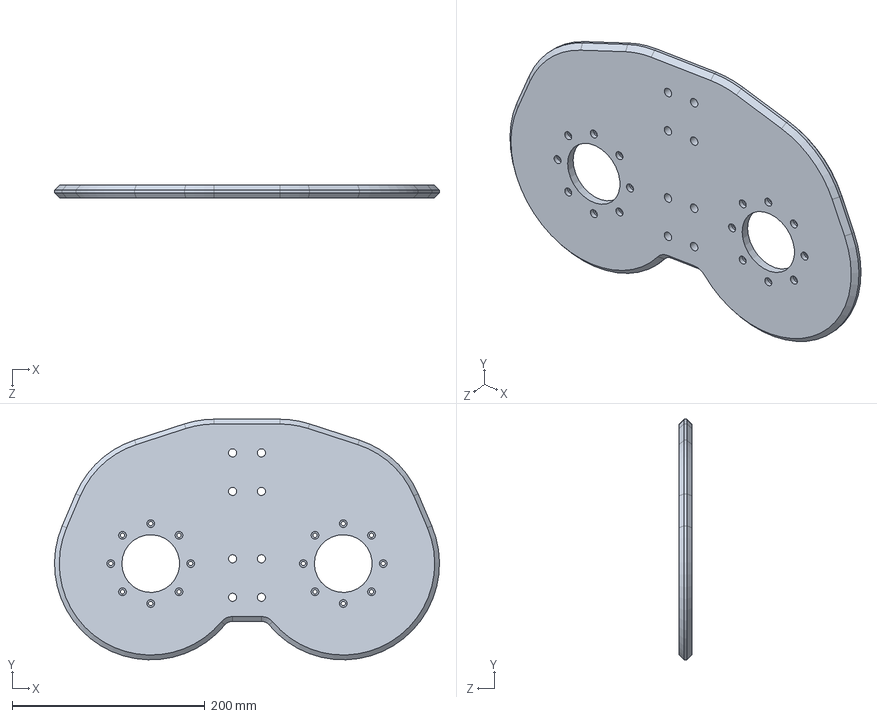
[picture p125: CAD file, 2024-04-30]
3D_models/V2.8_24.4.29-carbon/髋一级连接板_B.SLDPRT
400.0 x 250.0 x 13.0 mm
