Pacificzhong/humanoid_robot/component/参考执行器与第一版人形机器人模型/A-79822rev.I SEA801-188v2膝关节髋关节线性执行器.STEP

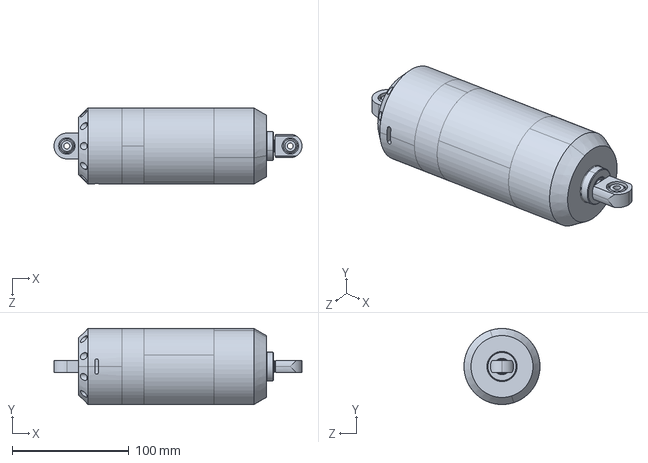
[picture p126: CAD file, 2024-05-05]
component/参考执行器与第一版人形机器人模型/A-79822rev.I SEA801-188v2膝关节髋关节线性执行器.STEP
212.0 x 65.0 x 65.0 mm
