Pacificzhong/humanoid_robot/3D_models/Proto/大腿外侧板.SLDPRT

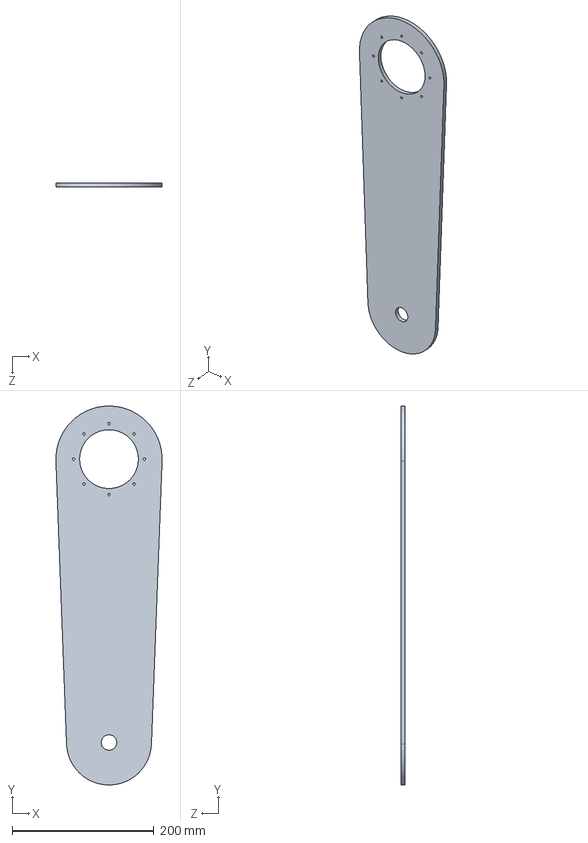
[picture p127: CAD file, 2024-03-29]
3D_models/Proto/大腿外侧板.SLDPRT
149.9 x 535.0 x 6.00 mm
