Pacificzhong/humanoid_robot/3D_models/V2.8_24.4.29-carbon/Shell/人形机器人stl/背（下半部）.STL

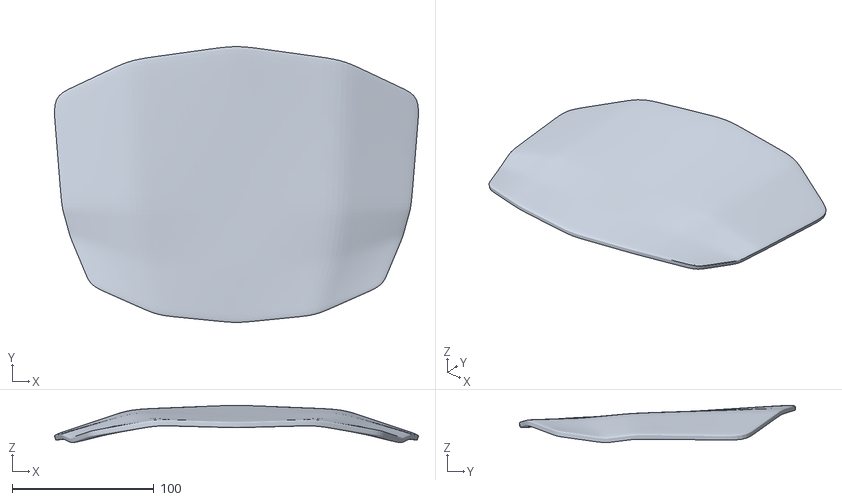
[picture p128: CAD file, 2024-04-14]
3D_models/V2.8_24.4.29-carbon/Shell/人形机器人stl/背（下半部）.STL
257.1 x 194.8 x 26.3
