Pacificzhong/humanoid_robot/3D_models/V2.8_24.4.29-carbon/髋一级连接板.SLDPRT

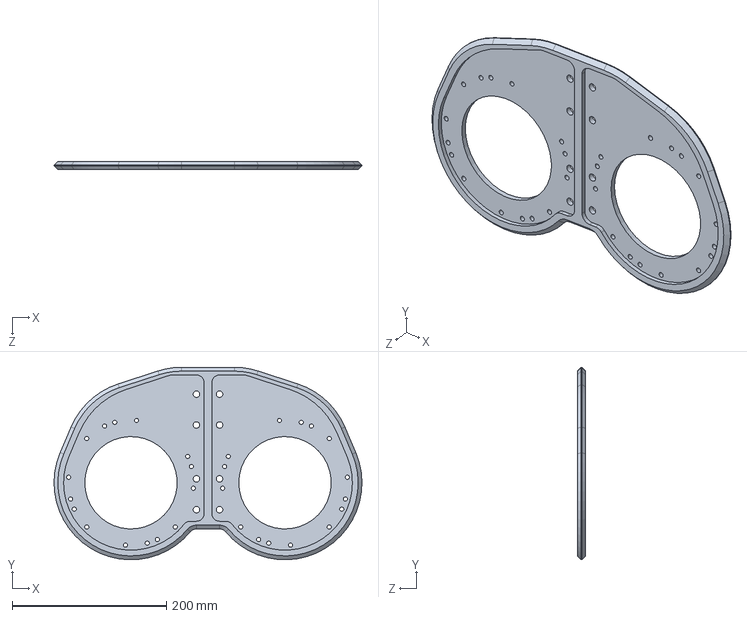
[picture p129: CAD file, 2024-04-30]
3D_models/V2.8_24.4.29-carbon/髋一级连接板.SLDPRT
400.0 x 250.0 x 11.0 mm
