Pacificzhong/humanoid_robot/vreplearning/轴承.SLDPRT

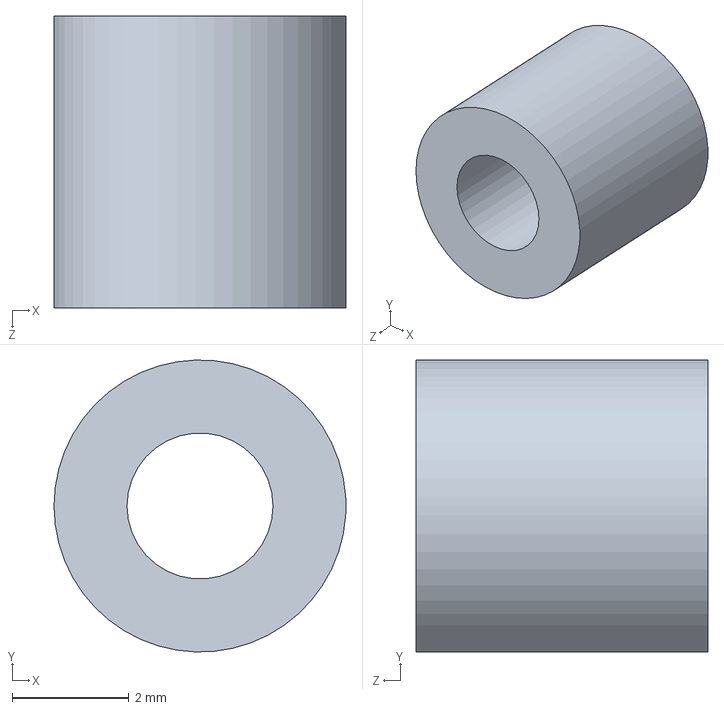
[picture p130: CAD file, 2024-04-14]
vreplearning/轴承.SLDPRT
5.00 x 5.00 x 5.00 mm
