Pacificzhong/humanoid_robot/3D_models/V2.8_24.4.29-carbon/大腿主干.SLDPRT

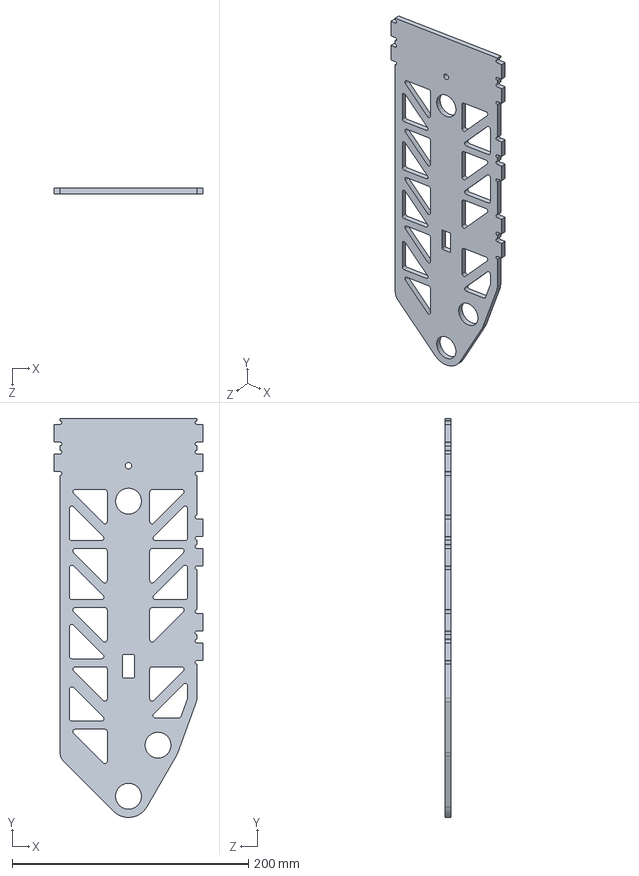
[picture p131: CAD file, 2024-04-29]
3D_models/V2.8_24.4.29-carbon/大腿主干.SLDPRT
126.0 x 338.0 x 5.00 mm
