Pacificzhong/humanoid_robot/3D_models/V3.0.8_4.24/脚掌.SLDPRT

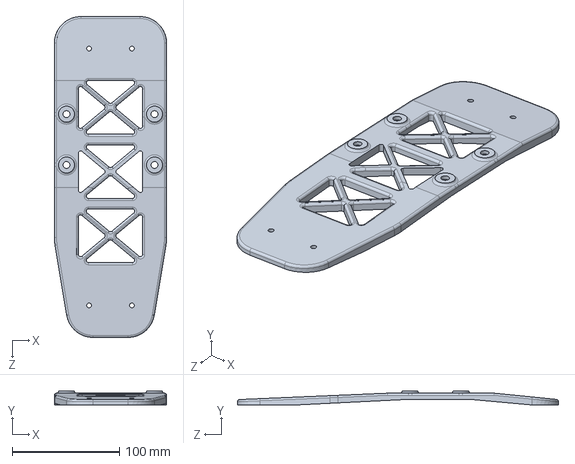
[picture p132: CAD file, 2024-05-09]
3D_models/V3.0.8_4.24/脚掌.SLDPRT
105.0 x 13.0 x 300.0 mm
