Pacificzhong/humanoid_robot/vreplearning/髋.SLDPRT

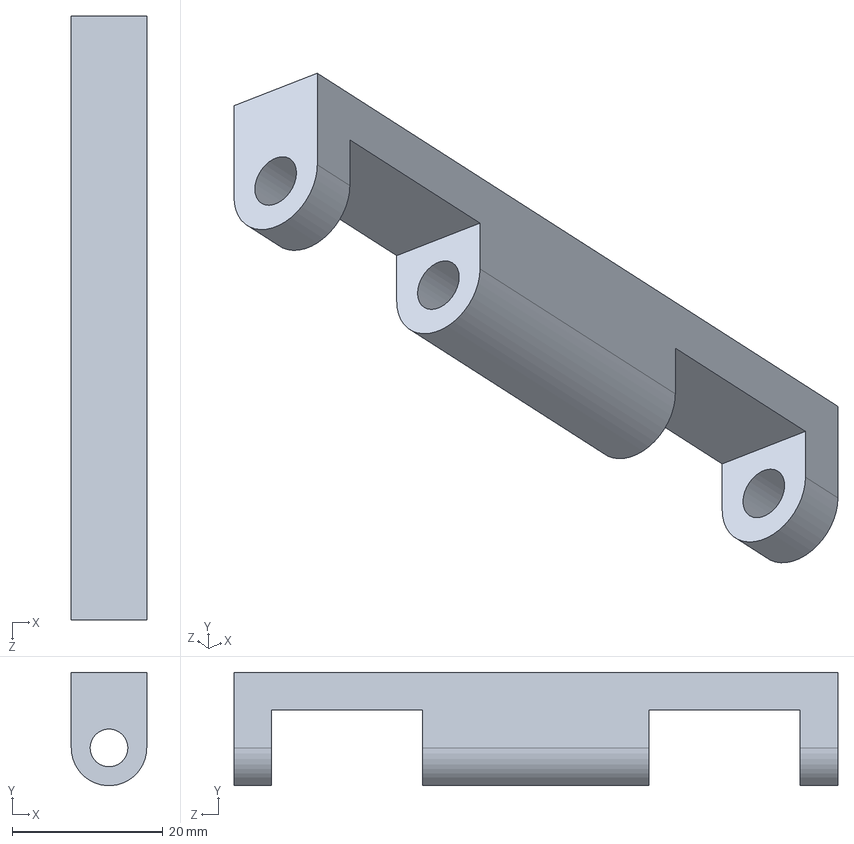
[picture p133: CAD file, 2024-04-14]
vreplearning/髋.SLDPRT
10.0 x 15.0 x 80.0 mm
