Pacificzhong/humanoid_robot/3D_models/4040型材-2.0厚.SLDPRT

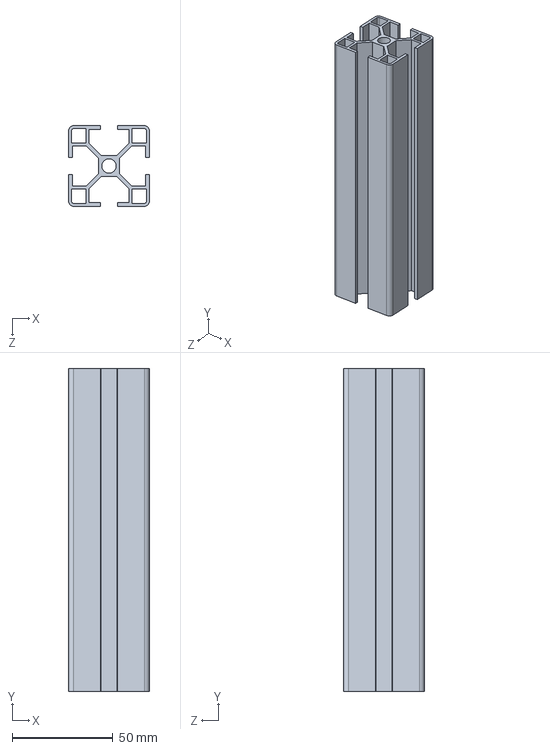
[picture p134: CAD file, 2024-03-07]
3D_models/4040型材-2.0厚.SLDPRT
40.0 x 160.0 x 40.0 mm
