Pacificzhong/humanoid_robot/3D_models/Proto/A1电机.SLDPRT

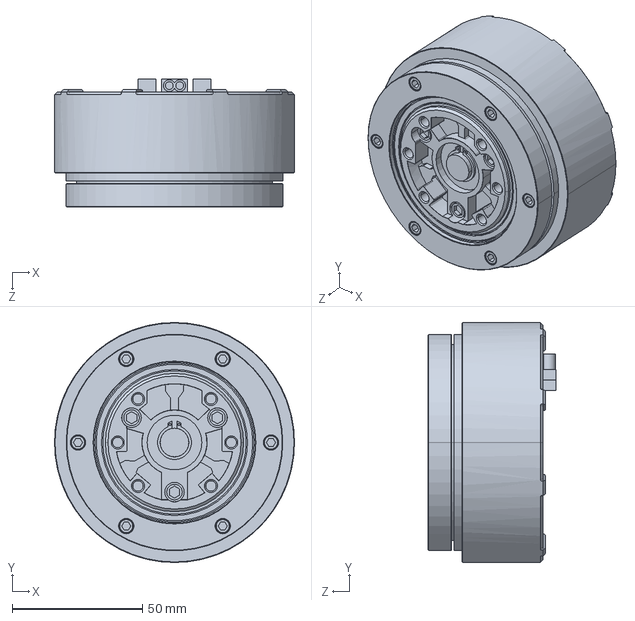
[picture p135: CAD file, 2024-03-29]
3D_models/Proto/A1电机.SLDPRT
92.0 x 92.0 x 49.0 mm
