Pacificzhong/humanoid_robot/3D_models/V2.8_24.4.29-carbon/crus/小腿主干_外1.SLDPRT

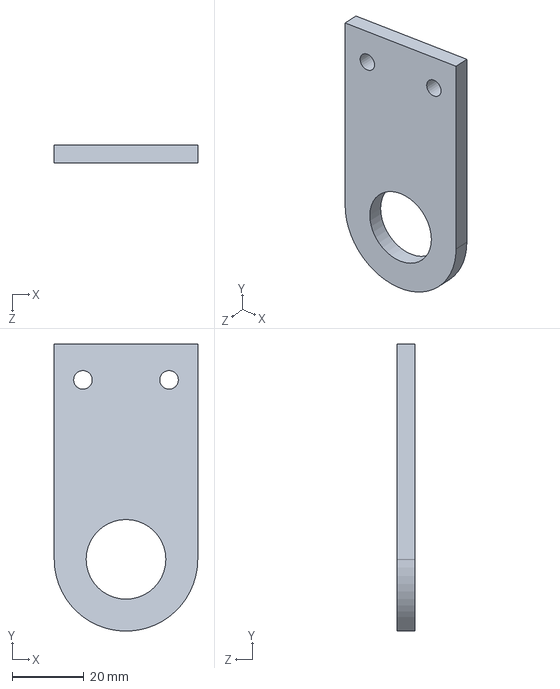
[picture p136: CAD file, 2024-04-29]
3D_models/V2.8_24.4.29-carbon/crus/小腿主干_外1.SLDPRT
40.0 x 80.0 x 5.00 mm
