Pacificzhong/humanoid_robot/3D_models/V2.8_24.4.29-carbon/腿髋转接架侧板V2.SLDPRT

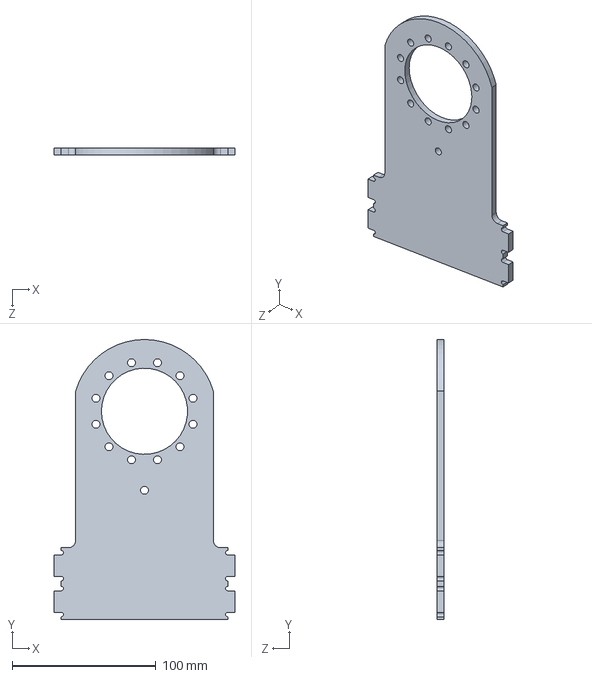
[picture p137: CAD file, 2024-04-29]
3D_models/V2.8_24.4.29-carbon/腿髋转接架侧板V2.SLDPRT
126.0 x 195.1 x 5.00 mm
