Pacificzhong/humanoid_robot/vreplearning/feet.SLDPRT

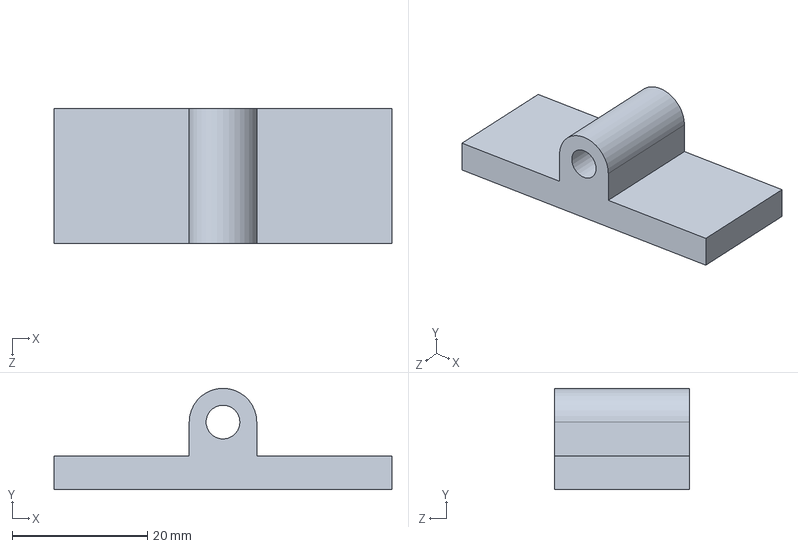
[picture p138: CAD file, 2024-04-14]
vreplearning/feet.SLDPRT
50.0 x 15.0 x 20.0 mm
