Pacificzhong/humanoid_robot/3D_models/6060角码.SLDPRT

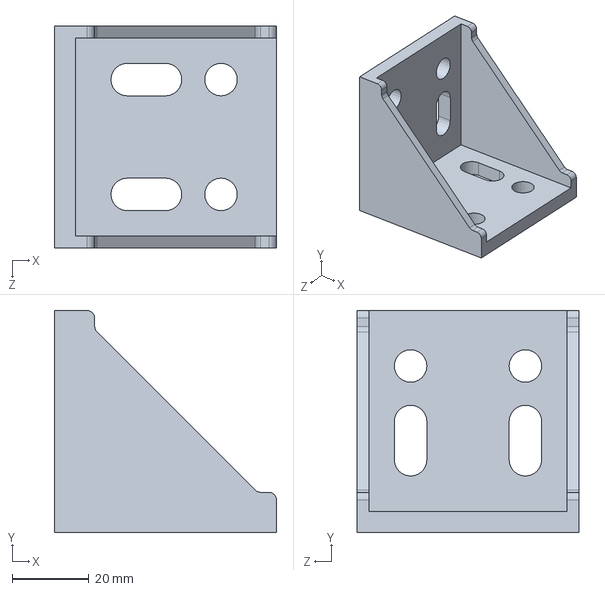
[picture p139: CAD file, 2024-03-06]
3D_models/6060角码.SLDPRT
58.0 x 58.0 x 58.0 mm
