Pacificzhong/humanoid_robot/3D_models/Proto/小腿主干.SLDPRT

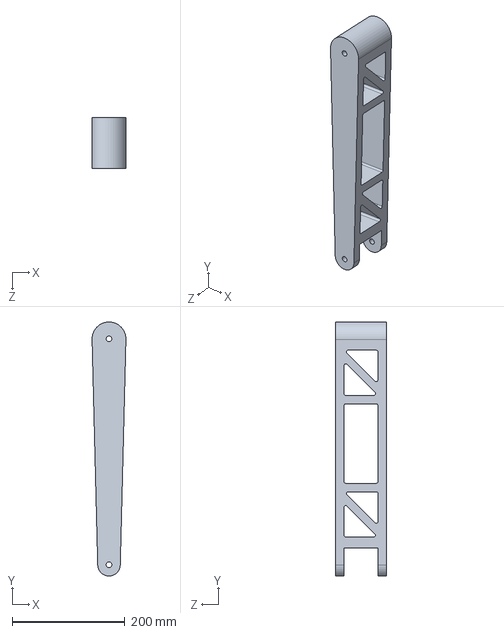
[picture p140: CAD file, 2024-03-29]
3D_models/Proto/小腿主干.SLDPRT
60.0 x 449.8 x 90.0 mm
