Pacificzhong/humanoid_robot/3D_models/V2.8_24.4.29-carbon/球铰脚底板.SLDPRT

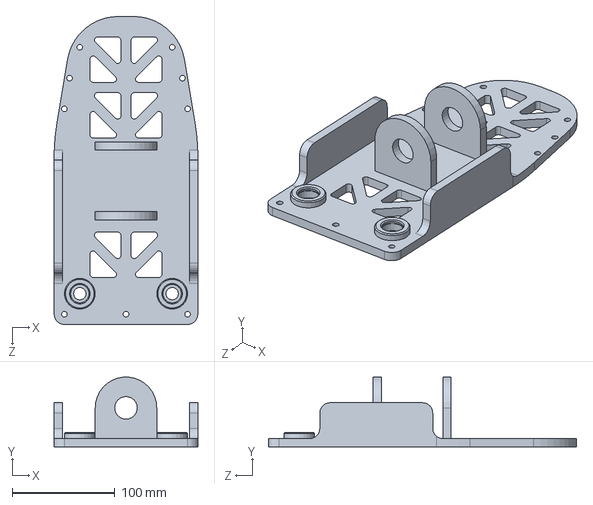
[picture p141: CAD file, 2024-04-29]
3D_models/V2.8_24.4.29-carbon/球铰脚底板.SLDPRT
140.0 x 67.9 x 300.0 mm
