Pacificzhong/humanoid_robot/vreplearning/小腿.SLDPRT

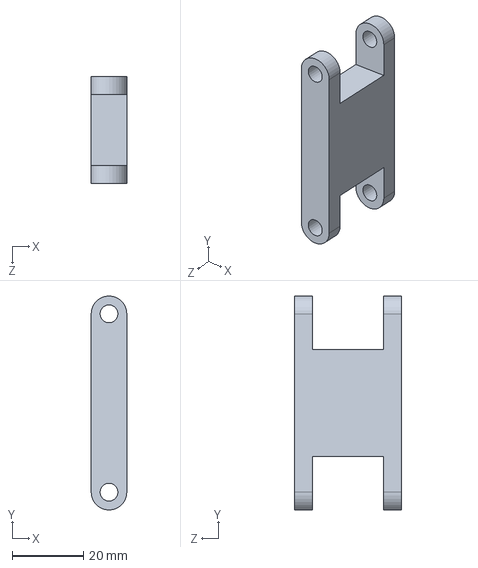
[picture p142: CAD file, 2024-04-14]
vreplearning/小腿.SLDPRT
10.0 x 60.0 x 30.0 mm
