Pacificzhong/humanoid_robot/3D_models/6060型材-1.3厚.SLDPRT

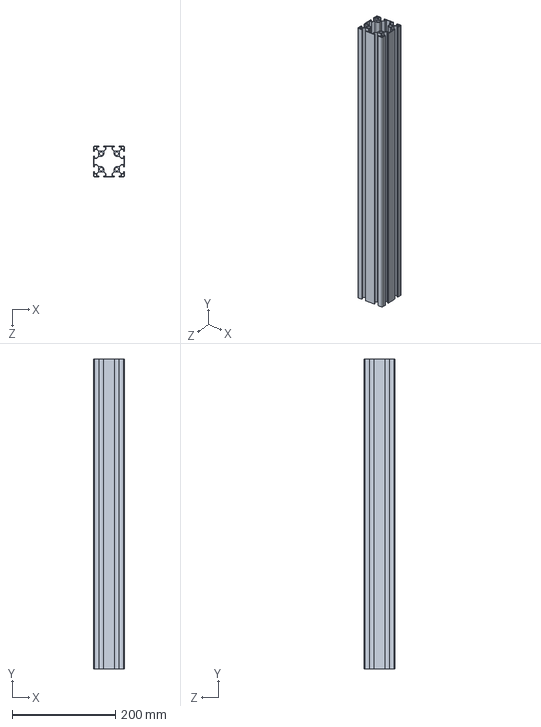
[picture p143: CAD file, 2024-03-06]
3D_models/6060型材-1.3厚.SLDPRT
60.0 x 600.0 x 60.0 mm
