Pacificzhong/humanoid_robot/3D_models/Proto/小腿A1电机安装.SLDPRT

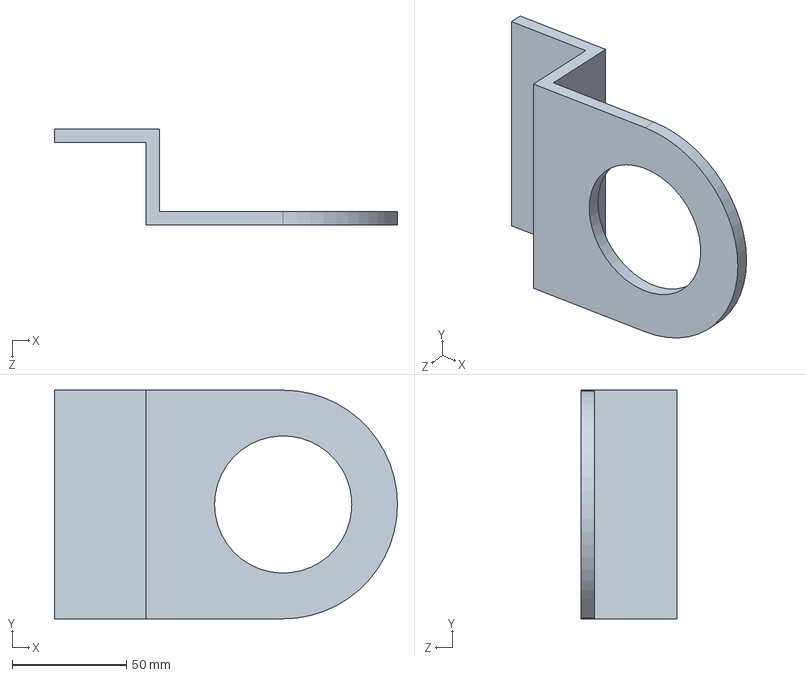
[picture p144: CAD file, 2024-03-29]
3D_models/Proto/小腿A1电机安装.SLDPRT
150.0 x 100.0 x 42.0 mm
