Pacificzhong/humanoid_robot/3D_models/V2.8_24.4.29-carbon/轴套.SLDPRT

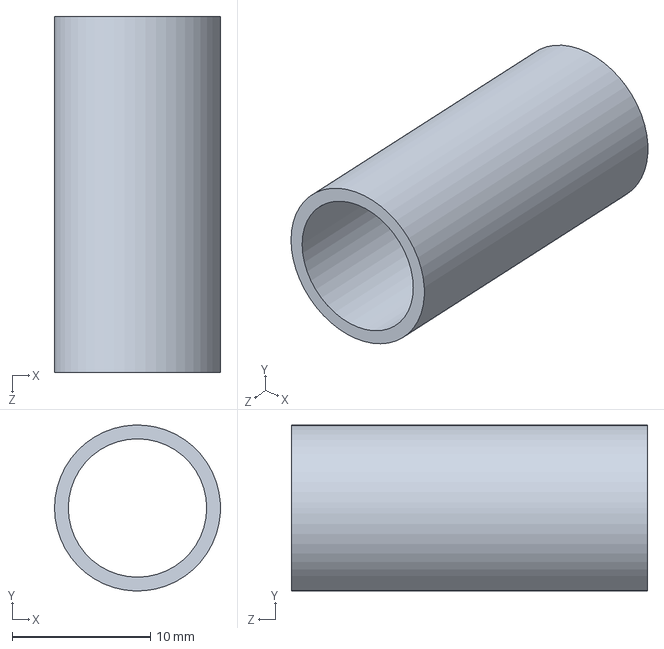
[picture p145: CAD file, 2024-04-29]
3D_models/V2.8_24.4.29-carbon/轴套.SLDPRT
12.0 x 12.0 x 25.8 mm
