Pacificzhong/humanoid_robot/3D_models/GS8080D型材.SLDPRT

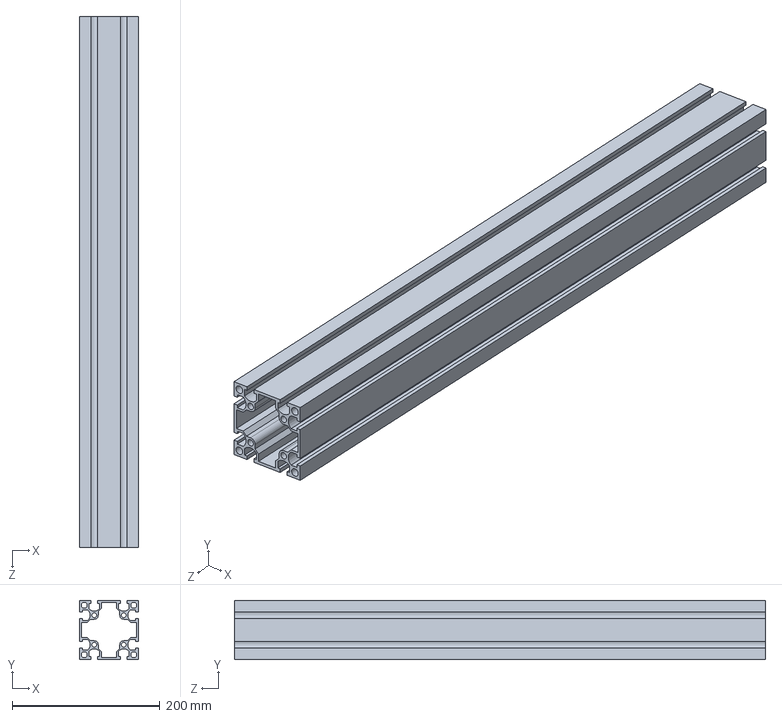
[picture p146: CAD file, 2024-02-28]
3D_models/GS8080D型材.SLDPRT
80.0 x 80.0 x 720.0 mm
