Pacificzhong/humanoid_robot/3D_models/Proto/A1电机盖板.SLDPRT

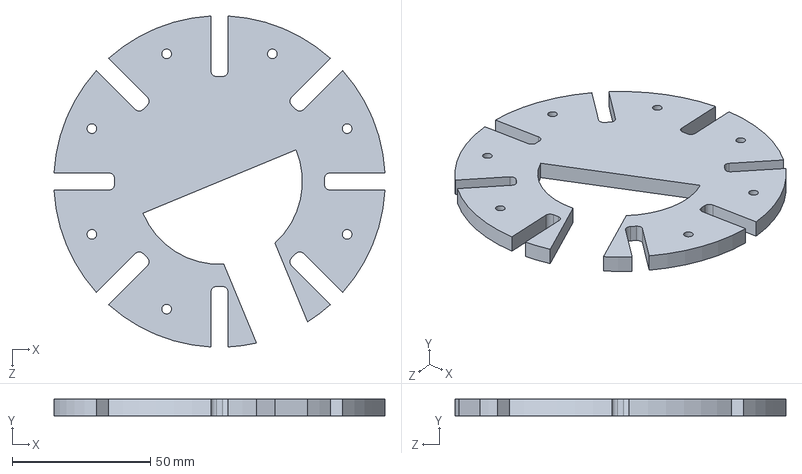
[picture p147: CAD file, 2024-03-27]
3D_models/Proto/A1电机盖板.SLDPRT
119.8 x 6.00 x 119.8 mm
