Pacificzhong/humanoid_robot/3D_models/V2.8_24.4.29-carbon/crus/小腿主干_外7-6-上支架.SLDPRT

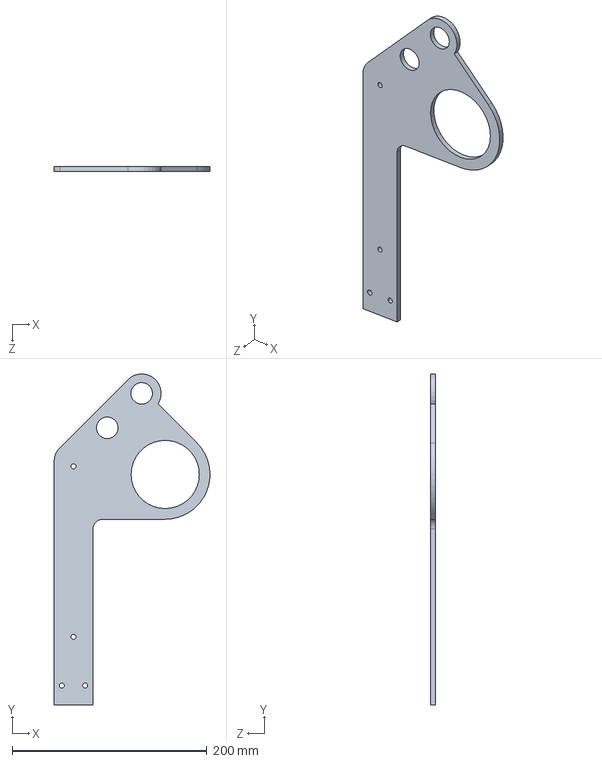
[picture p148: CAD file, 2024-04-29]
3D_models/V2.8_24.4.29-carbon/crus/小腿主干_外7-6-上支架.SLDPRT
160.1 x 339.9 x 5.00 mm
