Pacificzhong/humanoid_robot/3D_models/V2.8_24.4.29-carbon/膝关节下连杆_90.SLDPRT

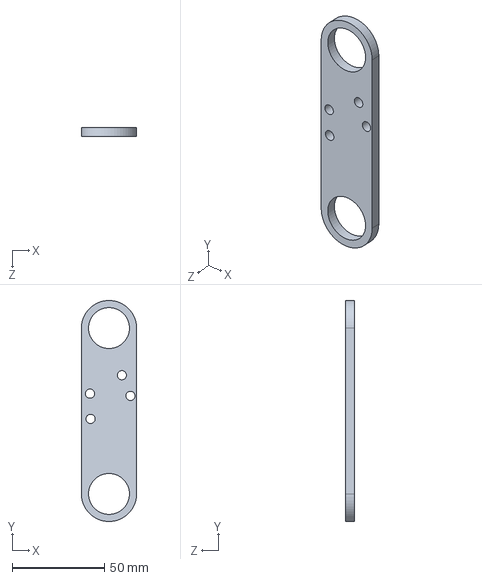
[picture p149: CAD file, 2024-04-29]
3D_models/V2.8_24.4.29-carbon/膝关节下连杆_90.SLDPRT
30.0 x 119.9 x 5.00 mm
