Pacificzhong/humanoid_robot/3D_models/Proto/铜柱M3-31.SLDPRT

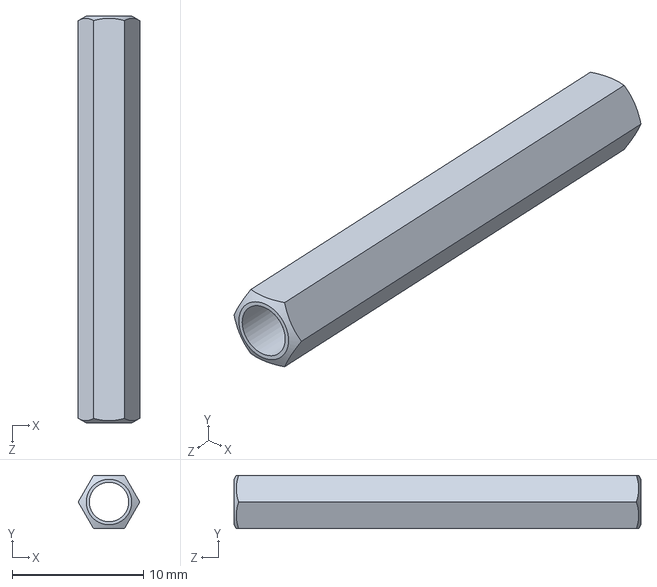
[picture p150: CAD file, 2024-03-27]
3D_models/Proto/铜柱M3-31.SLDPRT
4.70 x 4.07 x 31.0 mm
