Pacificzhong/humanoid_robot/3D_models/V2.8_24.4.29-carbon/crus/小腿主干_外8-9-下支架.SLDPRT

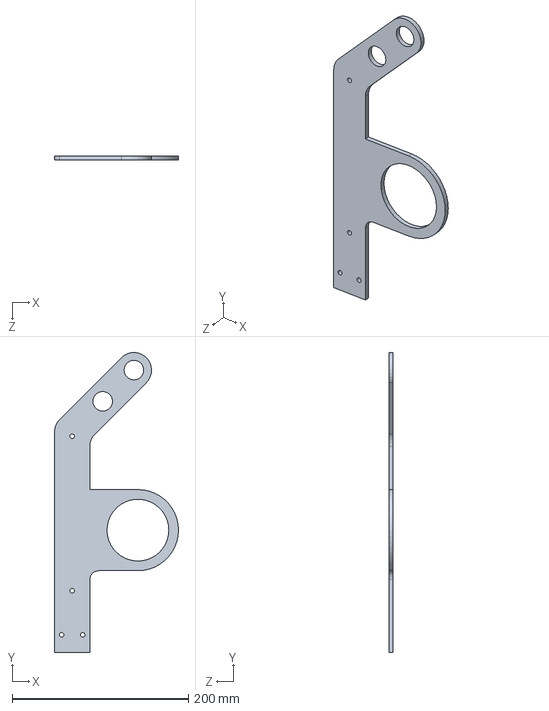
[picture p151: CAD file, 2024-04-29]
3D_models/V2.8_24.4.29-carbon/crus/小腿主干_外8-9-下支架.SLDPRT
140.5 x 340.0 x 5.00 mm
