Pacificzhong/humanoid_robot/3D_models/V2.8_24.4.29-carbon/小腿主干.SLDPRT

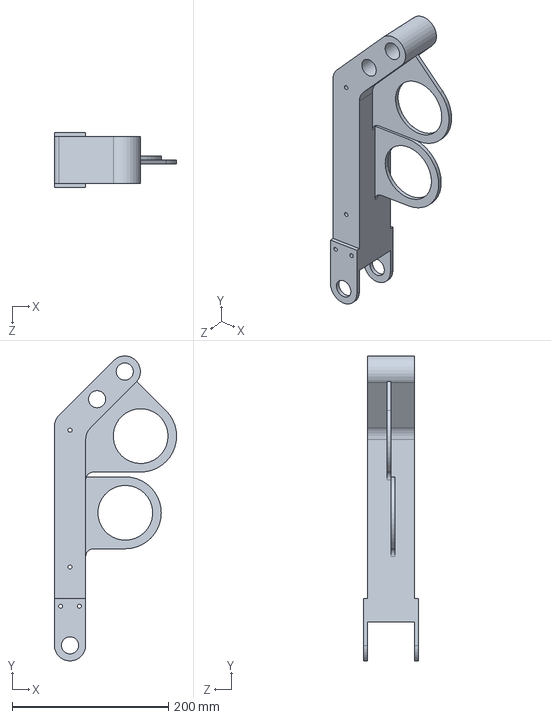
[picture p152: CAD file, 2024-04-29]
3D_models/V2.8_24.4.29-carbon/小腿主干.SLDPRT
156.3 x 389.9 x 70.0 mm
