Pacificzhong/humanoid_robot/3D_models/踝关节腕关节线性执行器A-81138 SEA801-189.STEP

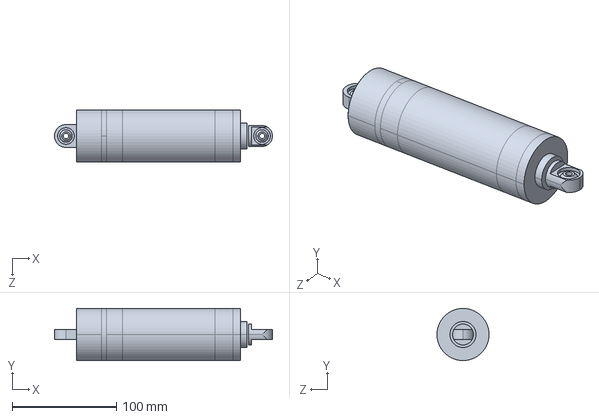
[picture p154: CAD file, 2024-01-18]
3D_models/踝关节腕关节线性执行器A-81138 SEA801-189.STEP
209.0 x 50.0 x 50.0 mm
