Pacificzhong/humanoid_robot/3D_models/V2.8_24.4.29-carbon/大腿榫卯-单板.SLDPRT

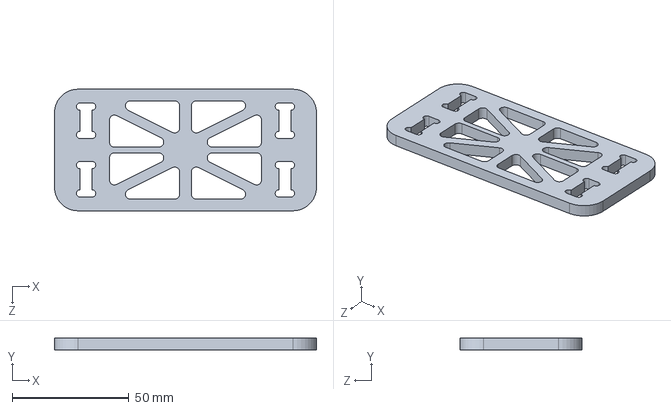
[picture p155: CAD file, 2024-04-29]
3D_models/V2.8_24.4.29-carbon/大腿榫卯-单板.SLDPRT
112.0 x 5.00 x 52.0 mm
