Pacificzhong/humanoid_robot/3D_models/膝关节髋关节线性执行器A-79822 SEA801-188.STEP

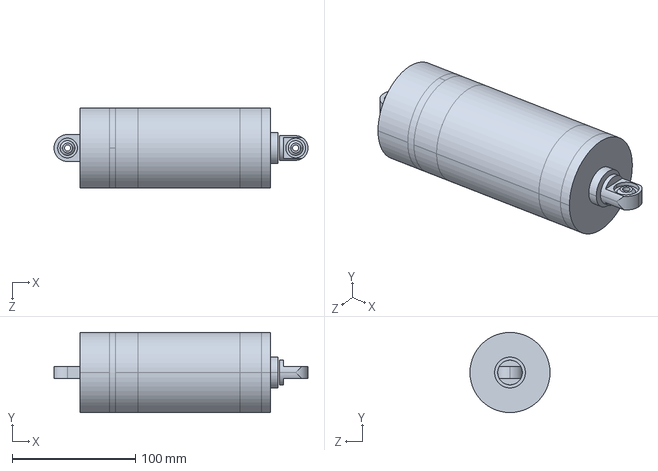
[picture p156: CAD file, 2024-01-18]
3D_models/膝关节髋关节线性执行器A-79822 SEA801-188.STEP
206.0 x 65.0 x 65.0 mm
