Pacificzhong/humanoid_robot/3D_models/V2.8_24.4.29-carbon/踝关节连杆-长.SLDPRT

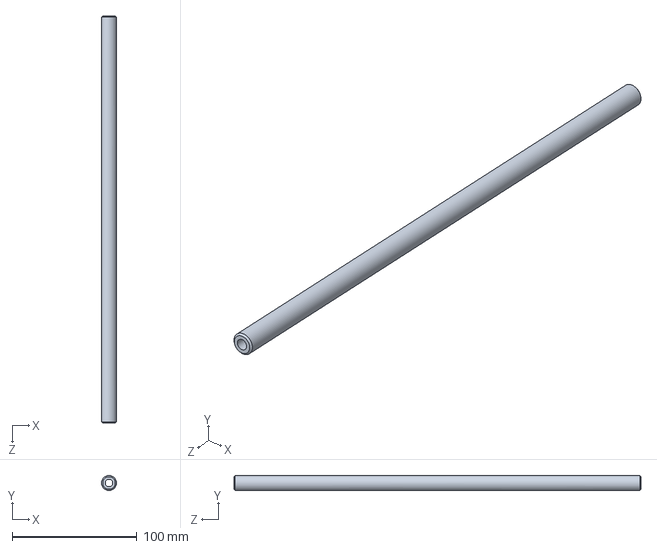
[picture p157: CAD file, 2024-04-29]
3D_models/V2.8_24.4.29-carbon/踝关节连杆-长.SLDPRT
12.0 x 12.0 x 326.0 mm
