Pacificzhong/humanoid_robot/3D_models/V2.8_24.4.29-carbon/大腿主干_右侧板V2.SLDPRT

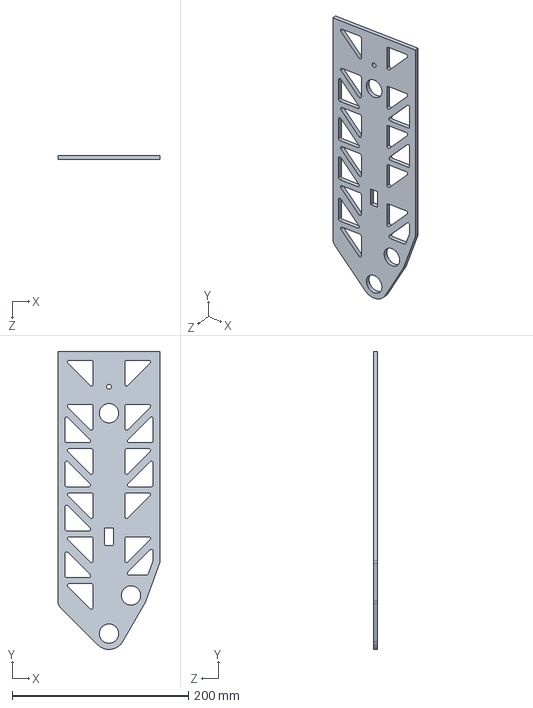
[picture p158: CAD file, 2024-04-29]
3D_models/V2.8_24.4.29-carbon/大腿主干_右侧板V2.SLDPRT
116.0 x 338.0 x 5.00 mm
