Pacificzhong/humanoid_robot/3D_models/V2.8_24.4.29-carbon/小腿电机摇杆A1.SLDPRT

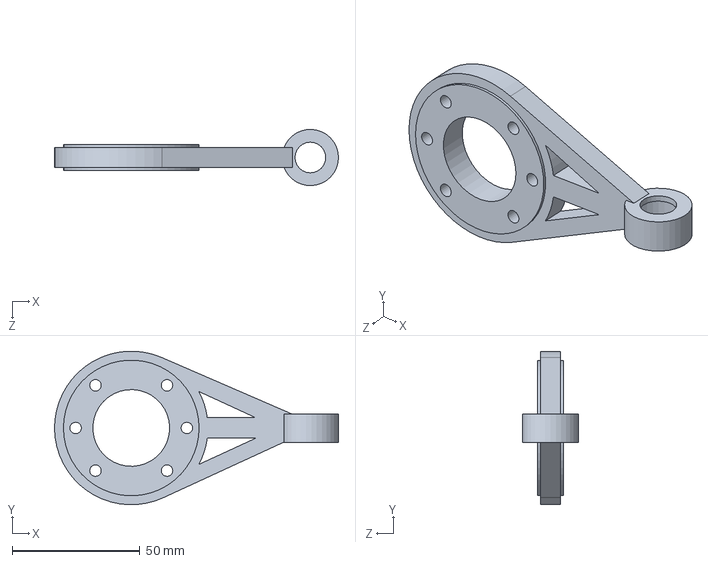
[picture p159: CAD file, 2024-04-29]
3D_models/V2.8_24.4.29-carbon/小腿电机摇杆A1.SLDPRT
111.0 x 59.9 x 22.0 mm
