Pacificzhong/humanoid_robot/3D_models/V2.8_24.4.29-carbon/矮版上肢前板.SLDPRT

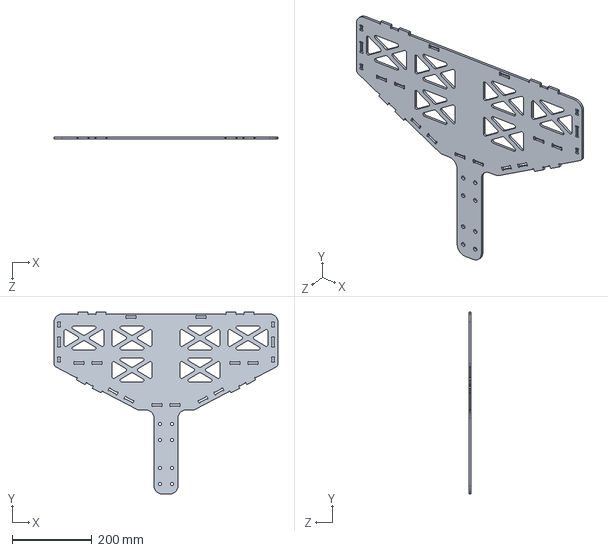
[picture p160: CAD file, 2024-04-20]
3D_models/V2.8_24.4.29-carbon/矮版上肢前板.SLDPRT
560.0 x 455.0 x 5.00 mm
