Pacificzhong/humanoid_robot/3D_models/V2.8_24.4.29-carbon/Z1机械臂安装板.SLDPRT

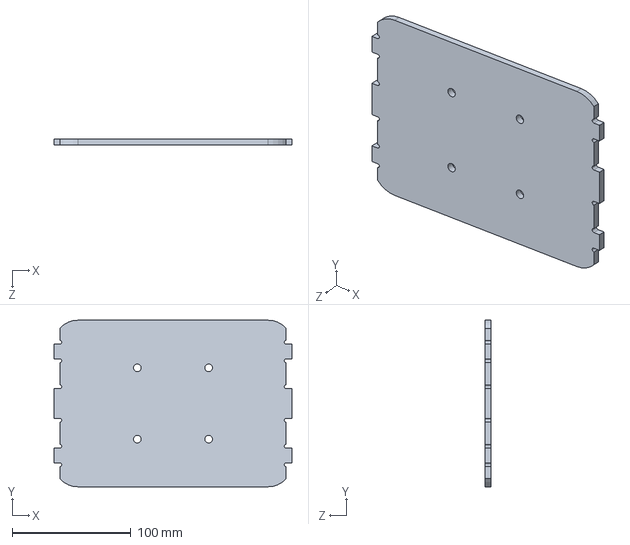
[picture p161: CAD file, 2024-04-20]
3D_models/V2.8_24.4.29-carbon/Z1机械臂安装板.SLDPRT
200.0 x 140.0 x 5.00 mm
