Pacificzhong/humanoid_robot/3D_models/V2.8_24.4.29-carbon/上肢连接板A.SLDPRT

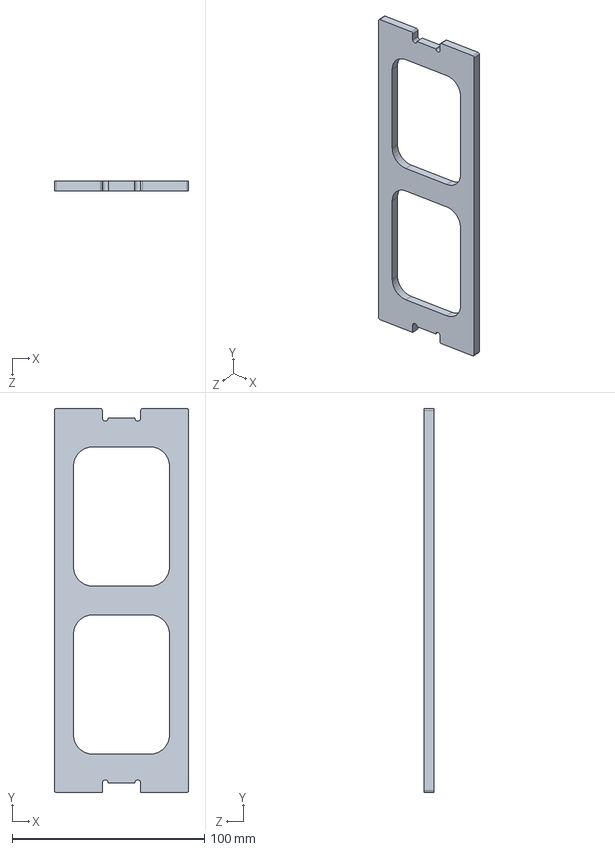
[picture p162: CAD file, 2024-04-20]
3D_models/V2.8_24.4.29-carbon/上肢连接板A.SLDPRT
70.0 x 200.0 x 5.00 mm
