Pacificzhong/humanoid_robot/3D_models/V2.8_24.4.29-carbon/脖子Y型安装板.SLDPRT

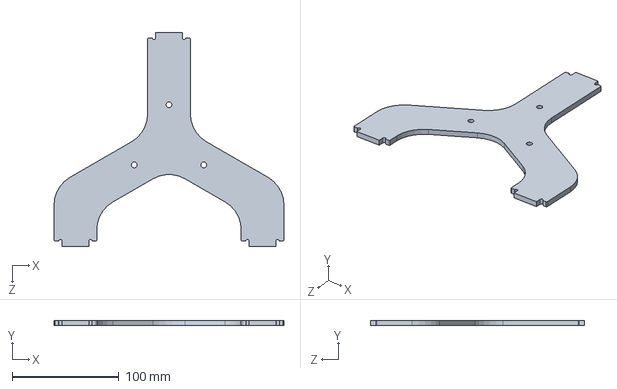
[picture p163: CAD file, 2024-04-20]
3D_models/V2.8_24.4.29-carbon/脖子Y型安装板.SLDPRT
215.0 x 5.00 x 200.0 mm
