Pacificzhong/humanoid_robot/3D_models/V2.8_24.4.29-carbon/上肢连接板C.SLDPRT

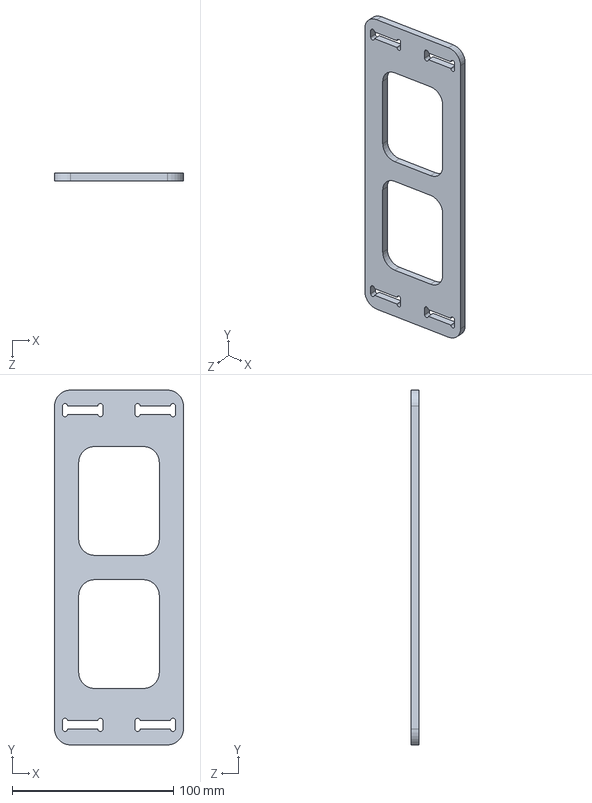
[picture p164: CAD file, 2024-04-20]
3D_models/V2.8_24.4.29-carbon/上肢连接板C.SLDPRT
80.0 x 220.0 x 5.00 mm
