Pacificzhong/humanoid_robot/3D_models/V2.8_24.4.29-carbon/上肢连接板B.SLDPRT

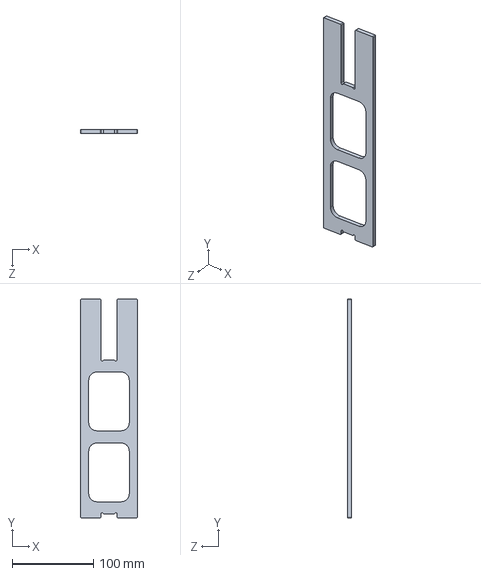
[picture p165: CAD file, 2024-04-19]
3D_models/V2.8_24.4.29-carbon/上肢连接板B.SLDPRT
70.0 x 270.0 x 5.00 mm
