Pacificzhong/humanoid_robot/3D_models/V2.8_24.4.29-carbon/镜向小腿左侧电机安装板A1.SLDPRT

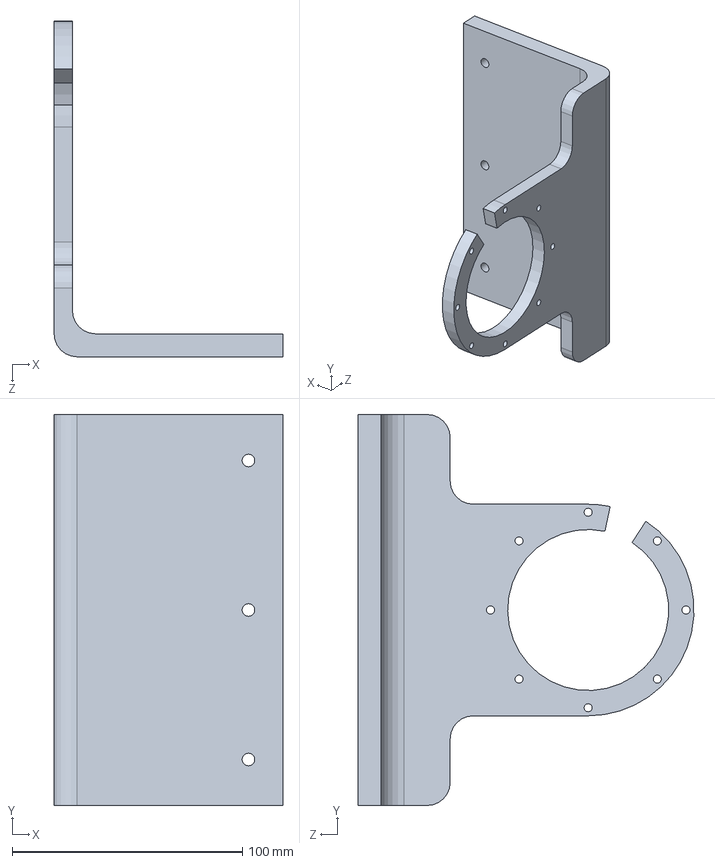
[picture p166: CAD file, 2024-04-14]
3D_models/V2.8_24.4.29-carbon/镜向小腿左侧电机安装板A1.SLDPRT
99.5 x 170.0 x 145.9 mm
