Pacificzhong/humanoid_robot/3D_models/V2.8_24.4.29-carbon/腰部侧摆电机连接板.SLDPRT

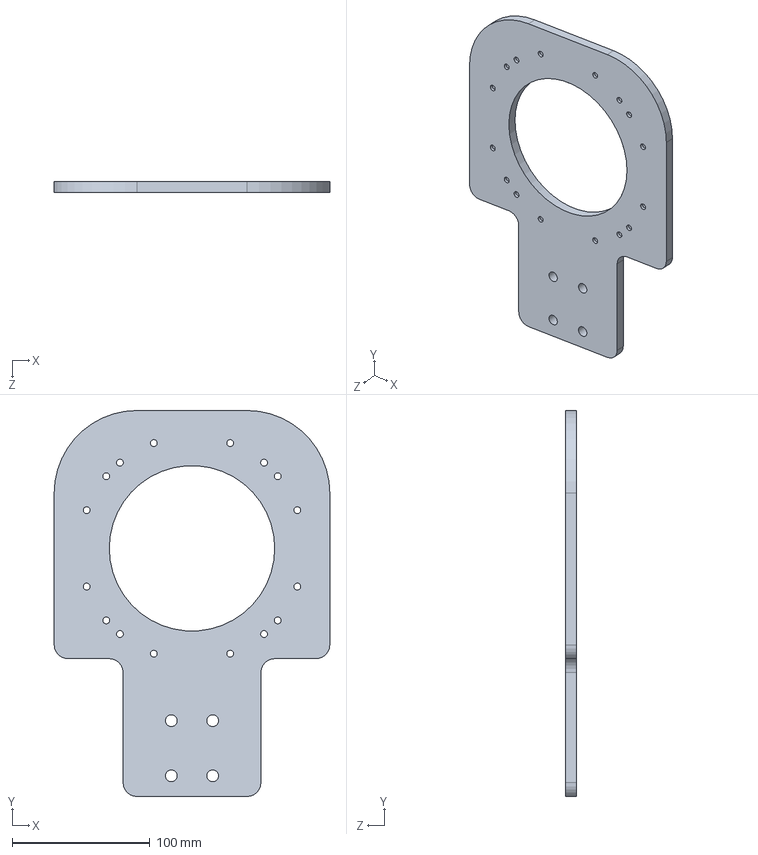
[picture p167: CAD file, 2024-04-14]
3D_models/V2.8_24.4.29-carbon/腰部侧摆电机连接板.SLDPRT
200.0 x 280.0 x 8.00 mm
