Pacificzhong/humanoid_robot/3D_models/V2.8_24.4.29-carbon/髋二级连接板_旋转.SLDPRT

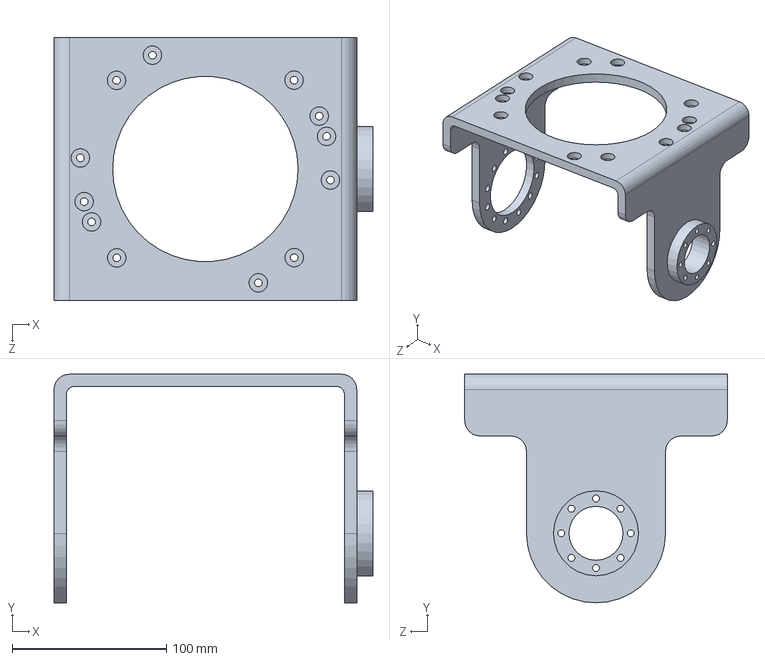
[picture p168: CAD file, 2024-04-14]
3D_models/V2.8_24.4.29-carbon/髋二级连接板_旋转.SLDPRT
206.5 x 148.0 x 170.0 mm
