Pacificzhong/humanoid_robot/3D_models/V2.8_24.4.29-carbon/腰部侧摆旋转支撑连接板.SLDPRT

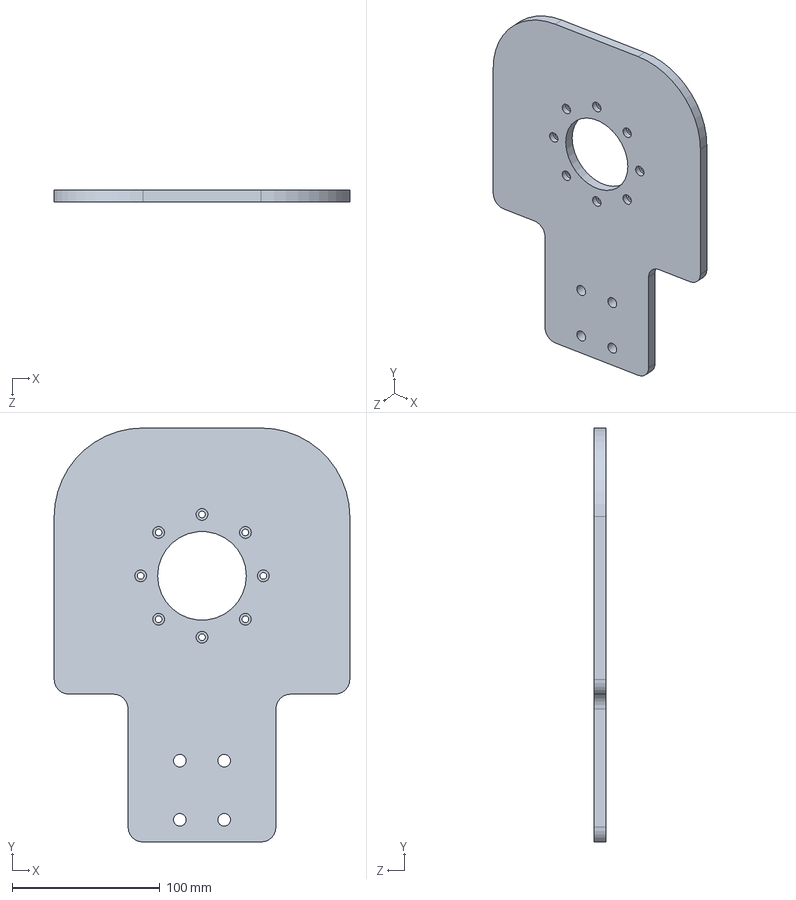
[picture p169: CAD file, 2024-04-14]
3D_models/V2.8_24.4.29-carbon/腰部侧摆旋转支撑连接板.SLDPRT
200.0 x 280.0 x 8.00 mm
