Pacificzhong/humanoid_robot/3D_models/V2.8_24.4.29-carbon/Z1-底座.SLDPRT

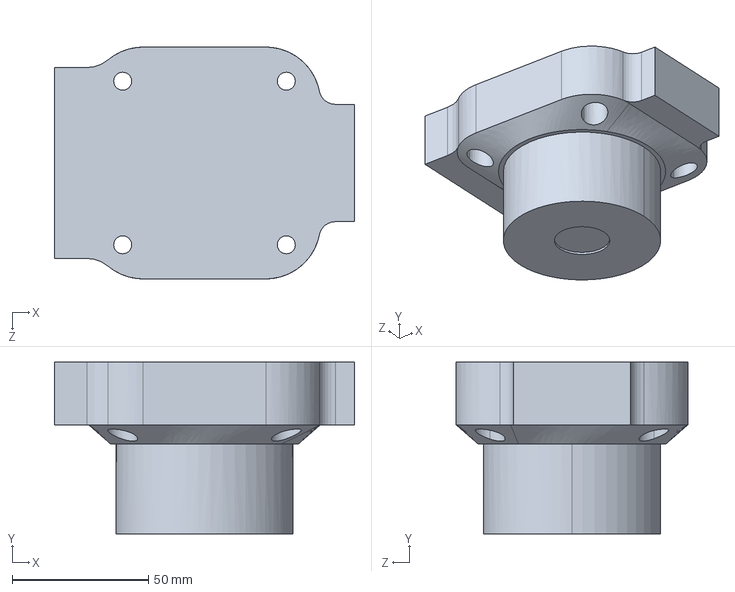
[picture p170: CAD file, 2024-03-24]
3D_models/V2.8_24.4.29-carbon/Z1-底座.SLDPRT
110.0 x 63.0 x 85.0 mm
