Pacificzhong/humanoid_robot/3D_models/V2.8_24.4.29-carbon/Z1-末端.SLDPRT

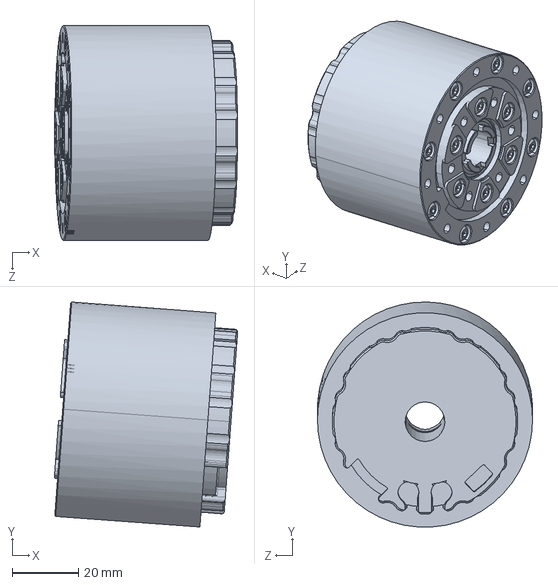
[picture p171: CAD file, 2024-03-24]
3D_models/V2.8_24.4.29-carbon/Z1-末端.SLDPRT
55.5 x 68.0 x 65.0 mm
