Pacificzhong/humanoid_robot/3D_models/V2.8_24.4.29-carbon/上肢底板.SLDPRT

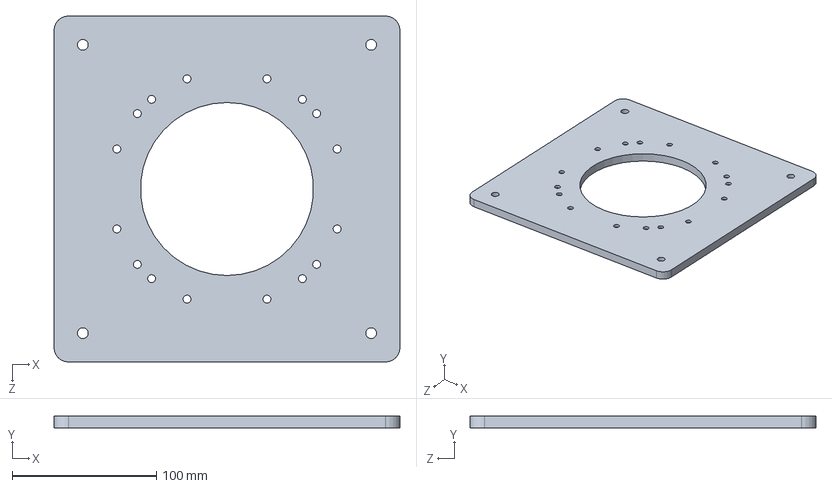
[picture p172: CAD file, 2024-03-07]
3D_models/V2.8_24.4.29-carbon/上肢底板.SLDPRT
240.0 x 8.00 x 240.0 mm
