Pacificzhong/humanoid_robot/3D_models/V2.8_24.4.29-carbon/腰部旋转电机连接板.SLDPRT

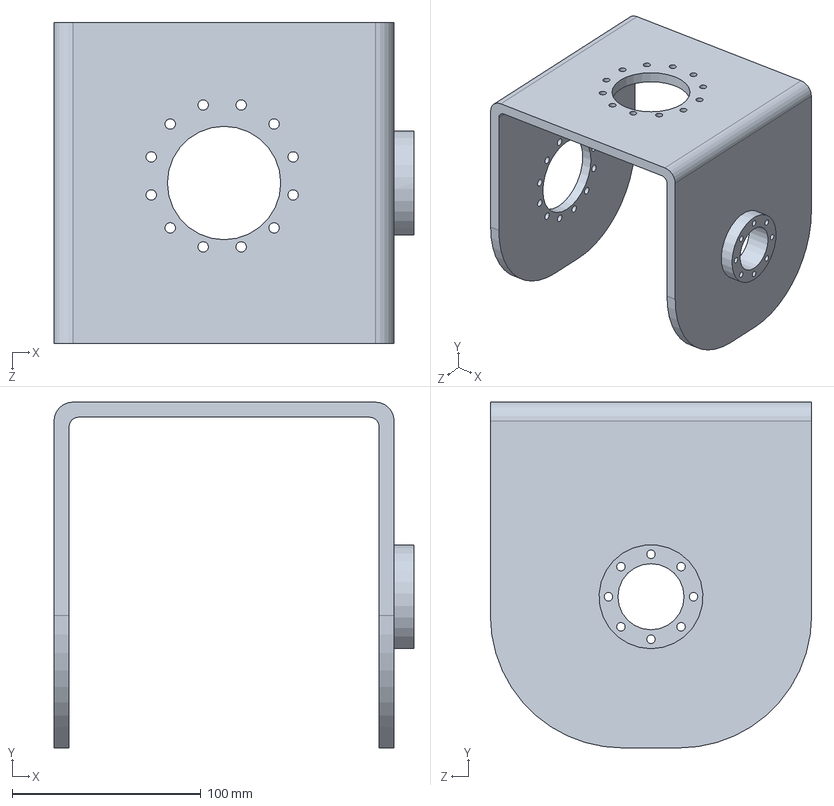
[picture p173: CAD file, 2024-03-07]
3D_models/V2.8_24.4.29-carbon/腰部旋转电机连接板.SLDPRT
190.5 x 183.0 x 170.0 mm
