Pacificzhong/humanoid_robot/3D_models/V2.8_24.4.29-carbon/踝关节执行器A-81934rev.B.SLDPRT

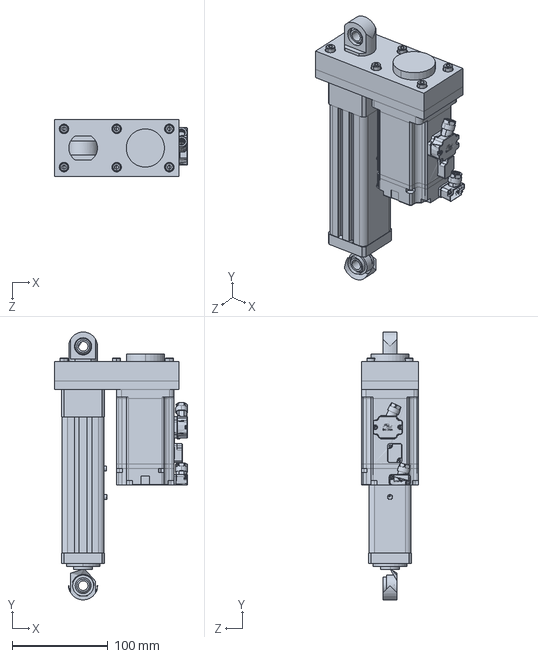
[picture p174: CAD file, 2024-03-07]
3D_models/V2.8_24.4.29-carbon/踝关节执行器A-81934rev.B.SLDPRT
139.1 x 280.0 x 60.0 mm
