Pacificzhong/humanoid_robot/3D_models/V2.8_24.4.29-carbon/型材-HGH35HA滑块连接.SLDPRT

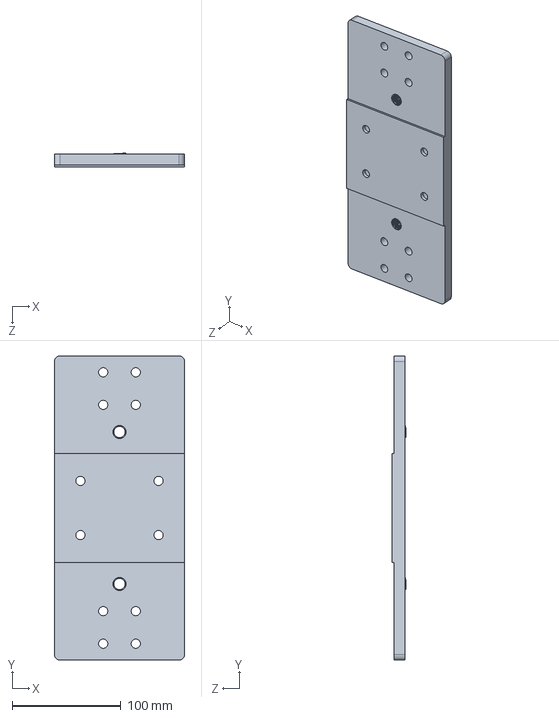
[picture p175: CAD file, 2024-03-06]
3D_models/V2.8_24.4.29-carbon/型材-HGH35HA滑块连接.SLDPRT
120.0 x 280.0 x 13.3 mm
