Pacificzhong/humanoid_robot/3D_models/V2.8_24.4.29-carbon/外框架侧板.SLDPRT

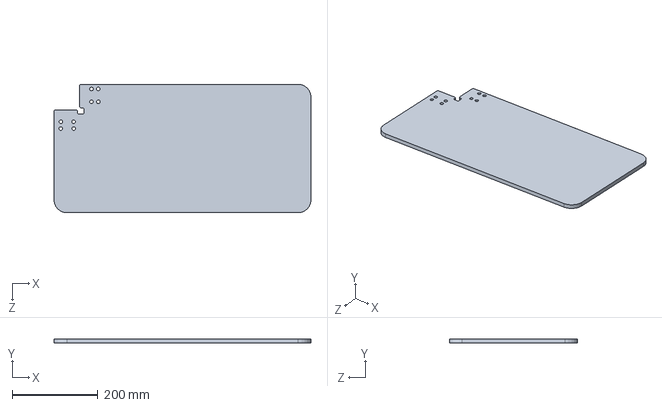
[picture p176: CAD file, 2024-03-06]
3D_models/V2.8_24.4.29-carbon/外框架侧板.SLDPRT
600.0 x 10.0 x 300.0 mm
