Pacificzhong/humanoid_robot/3D_models/V2.8_24.4.29-carbon/线轨HGH35HA.SLDPRT

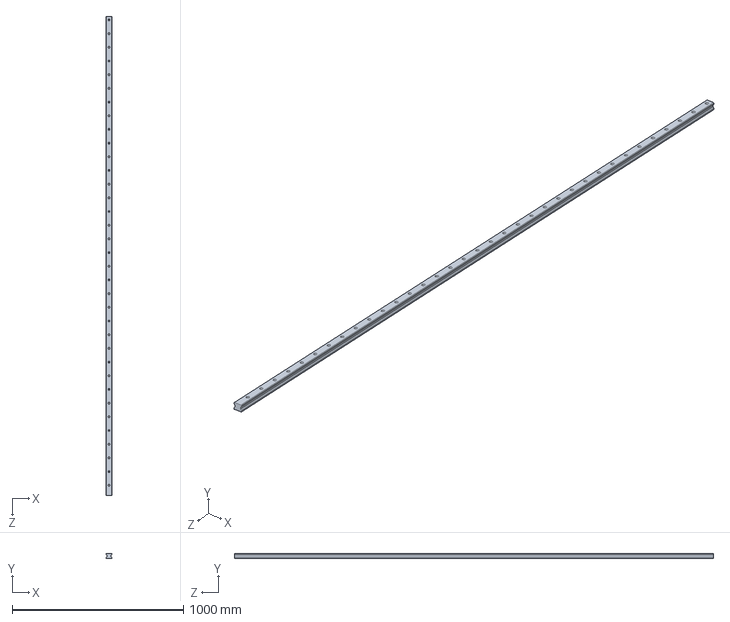
[picture p177: CAD file, 2024-03-06]
3D_models/V2.8_24.4.29-carbon/线轨HGH35HA.SLDPRT
34.0 x 29.0 x 2800.0 mm
