Pacificzhong/humanoid_robot/3D_models/V2.8_24.4.29-carbon/腿髋转接架底座V2.SLDPRT

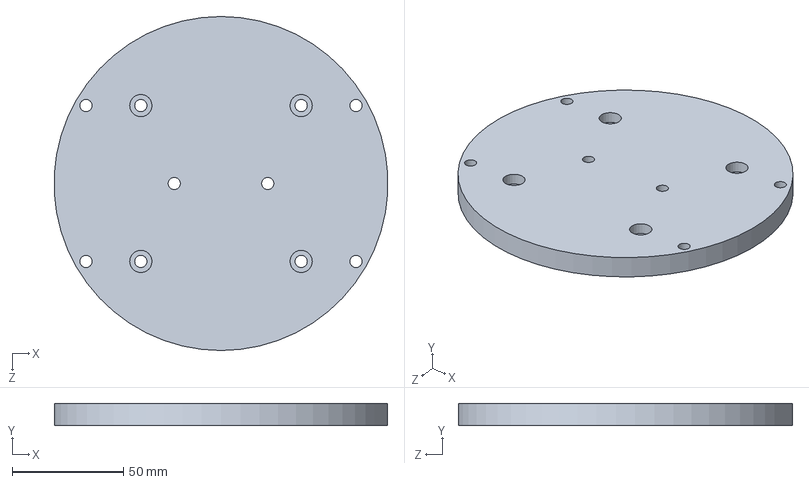
[picture p178: CAD file, 2024-03-04]
3D_models/V2.8_24.4.29-carbon/腿髋转接架底座V2.SLDPRT
149.7 x 10.0 x 150.0 mm
