Pacificzhong/humanoid_robot/3D_models/V2.8_24.4.29-carbon/膝关节直立固定棒.SLDPRT

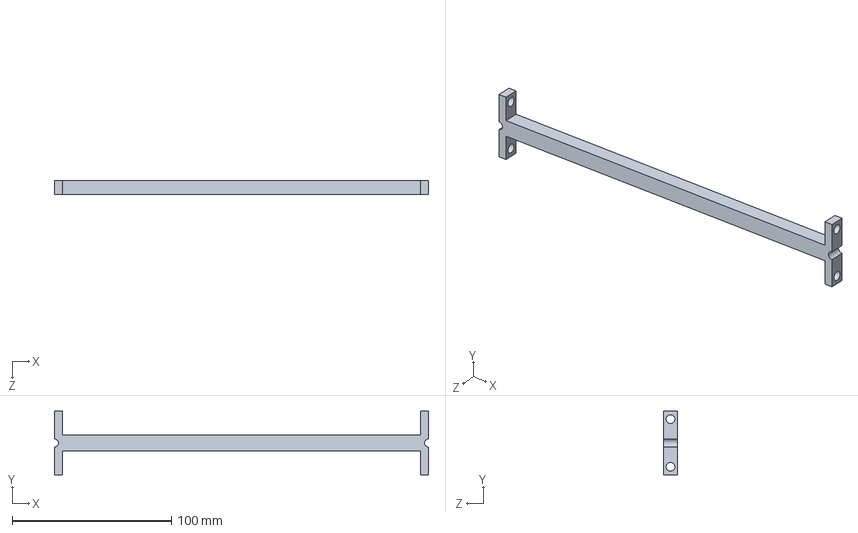
[picture p179: CAD file, 2024-03-04]
3D_models/V2.8_24.4.29-carbon/膝关节直立固定棒.SLDPRT
235.0 x 40.0 x 9.00 mm
