Pacificzhong/humanoid_robot/3D_models/V2.8_24.4.29-carbon/Z1-4号连杆.SLDPRT

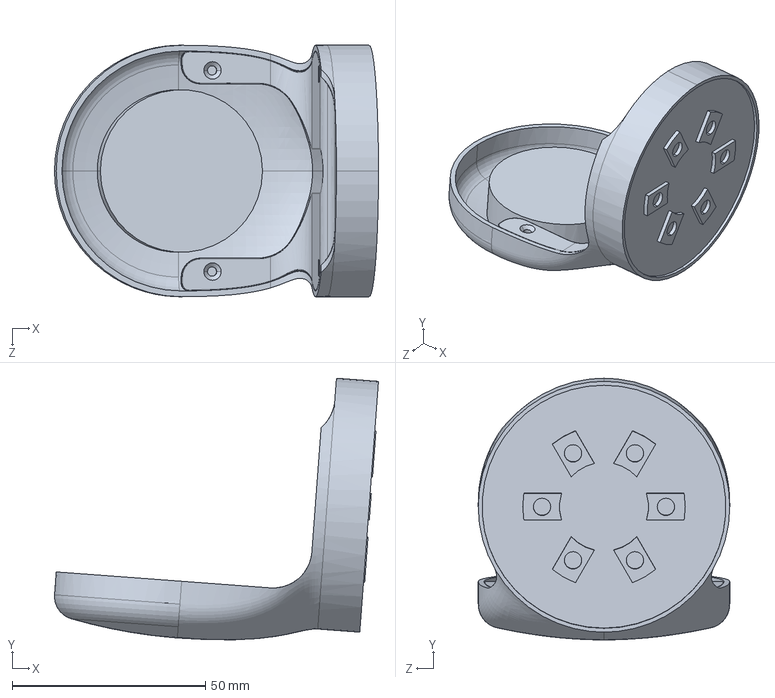
[picture p180: CAD file, 2024-03-04]
3D_models/V2.8_24.4.29-carbon/Z1-4号连杆.SLDPRT
83.7 x 67.6 x 65.0 mm
