Pacificzhong/humanoid_robot/3D_models/V2.8_24.4.29-carbon/膝关节直立固定棒_盖.SLDPRT

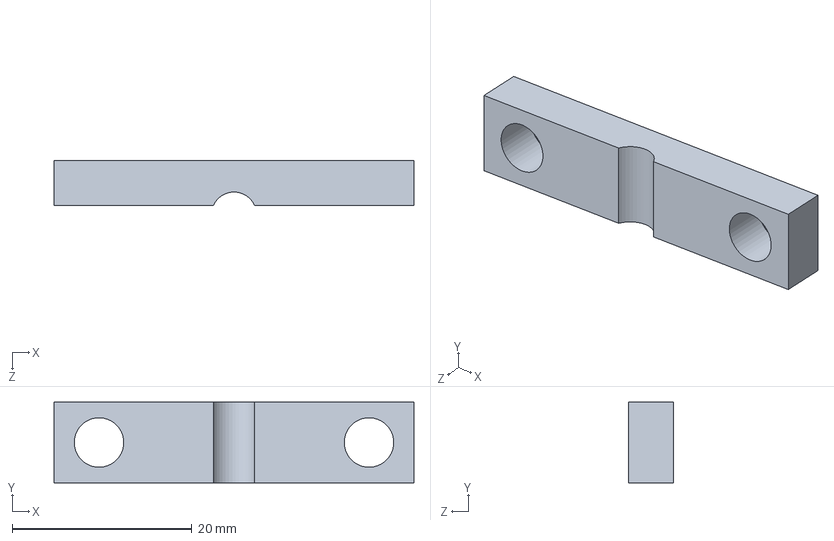
[picture p181: CAD file, 2024-03-04]
3D_models/V2.8_24.4.29-carbon/膝关节直立固定棒_盖.SLDPRT
40.0 x 9.00 x 5.00 mm
