Pacificzhong/humanoid_robot/3D_models/V2.8_24.4.29-carbon/腿髋转接架连接板V2.SLDPRT

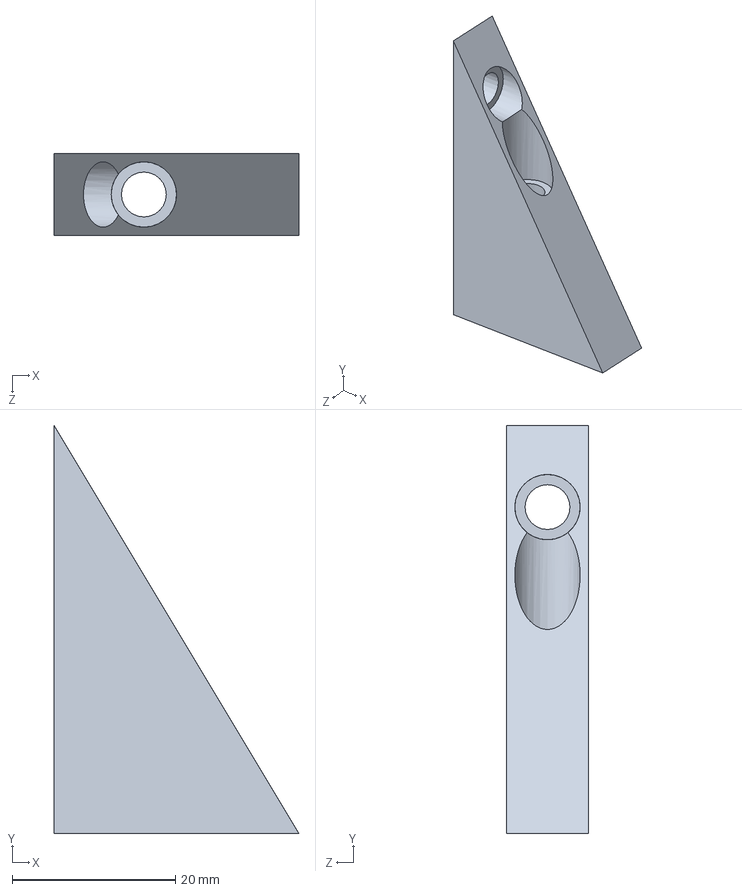
[picture p182: CAD file, 2024-03-04]
3D_models/V2.8_24.4.29-carbon/腿髋转接架连接板V2.SLDPRT
30.0 x 50.0 x 10.0 mm
