Pacificzhong/humanoid_robot/3D_models/V2.8_24.4.29-carbon/大腿侧板连接V2.SLDPRT

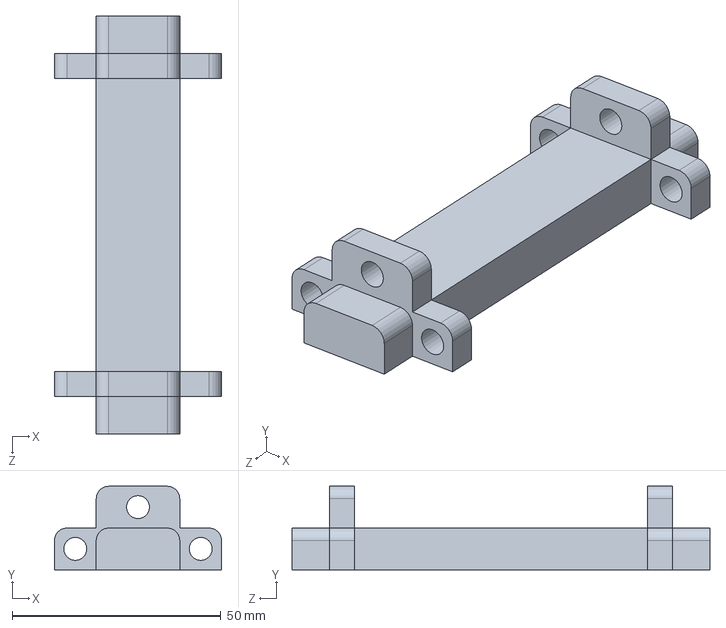
[picture p183: CAD file, 2024-03-04]
3D_models/V2.8_24.4.29-carbon/大腿侧板连接V2.SLDPRT
40.0 x 20.0 x 100.0 mm
