Pacificzhong/humanoid_robot/3D_models/V2.8_24.4.29-carbon/Z1-转台.SLDPRT

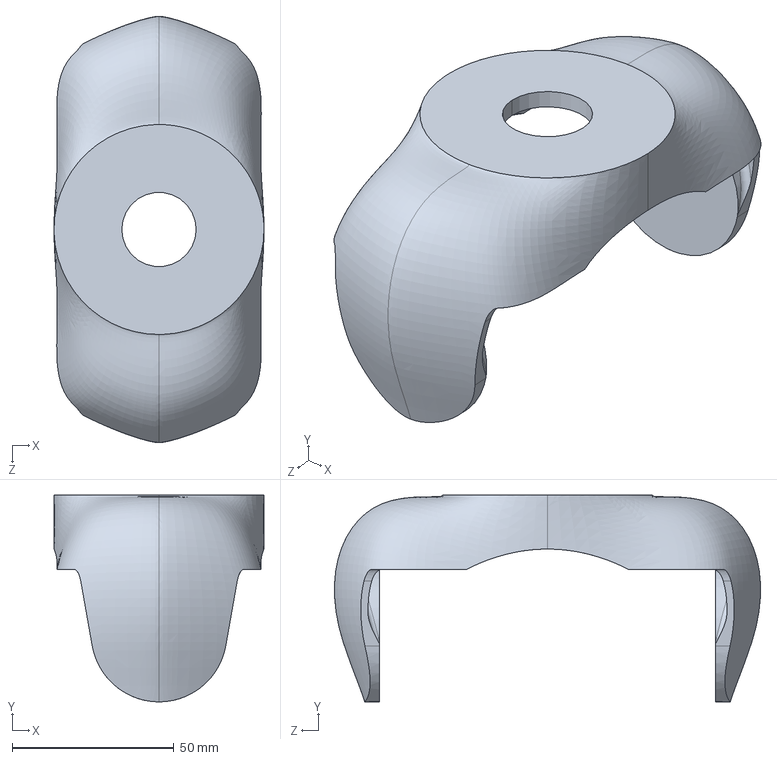
[picture p184: CAD file, 2024-03-03]
3D_models/V2.8_24.4.29-carbon/Z1-转台.SLDPRT
65.0 x 64.0 x 131.9 mm
