Pacificzhong/humanoid_robot/3D_models/V2.8_24.4.29-carbon/Z1-底座+转台.SLDPRT

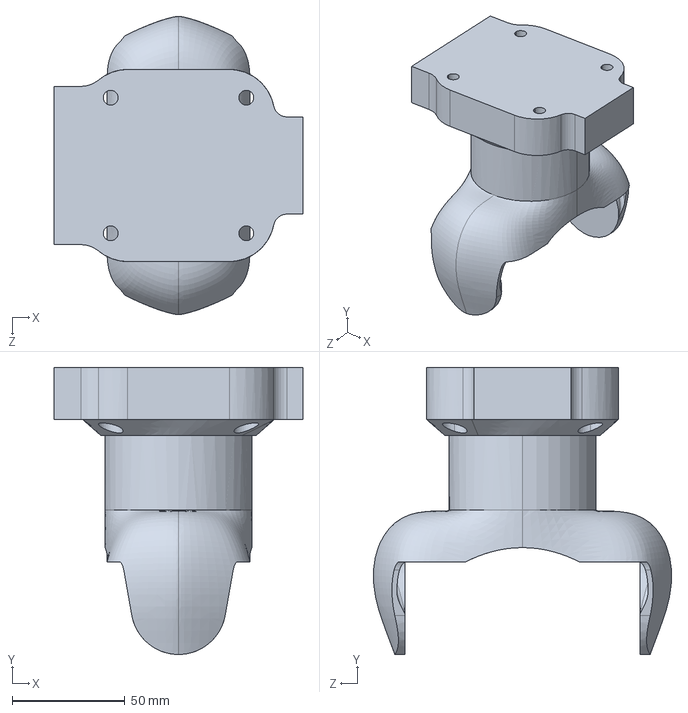
[picture p185: CAD file, 2024-03-01]
3D_models/V2.8_24.4.29-carbon/Z1-底座+转台.SLDPRT
110.0 x 127.0 x 131.9 mm
