Pacificzhong/humanoid_robot/3D_models/V2.8_24.4.29-carbon/线轨HGH30HA.SLDPRT

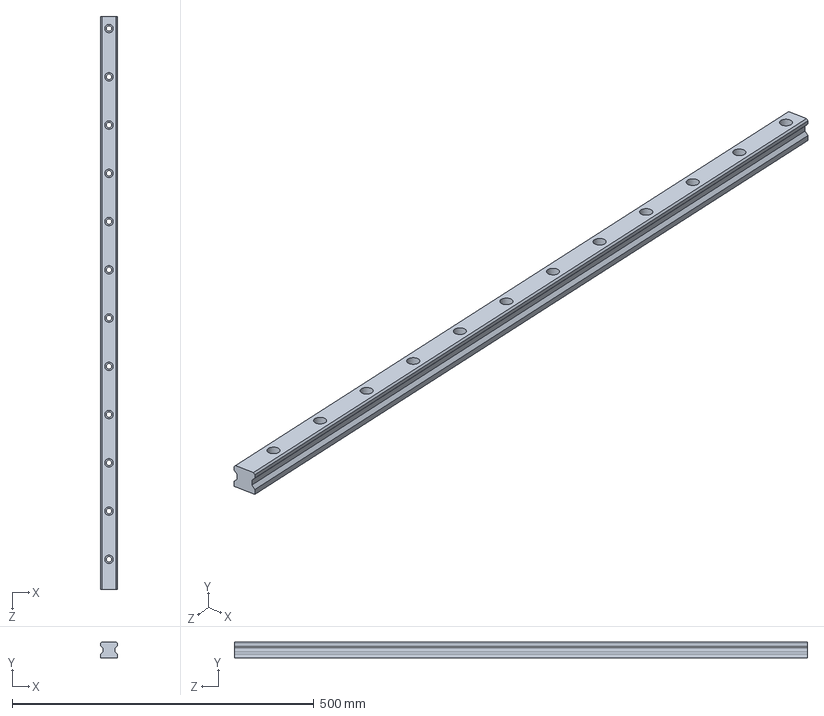
[picture p186: CAD file, 2024-02-28]
3D_models/V2.8_24.4.29-carbon/线轨HGH30HA.SLDPRT
28.0 x 26.0 x 950.0 mm
