Pacificzhong/humanoid_robot/3D_models/V2.8_24.4.29-carbon/髋三级连接板_前摆V2.SLDPRT

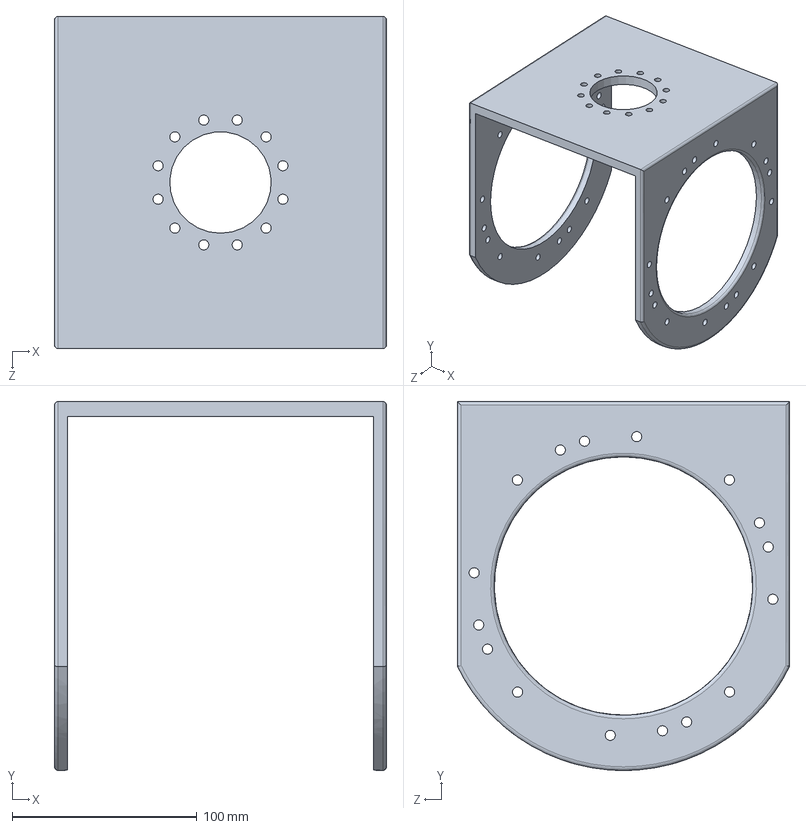
[picture p187: CAD file, 2024-02-28]
3D_models/V2.8_24.4.29-carbon/髋三级连接板_前摆V2.SLDPRT
180.0 x 200.0 x 180.0 mm
