Pacificzhong/humanoid_robot/3D_models/V2.8_24.4.29-carbon/膝关节SEA801-188主体.SLDPRT

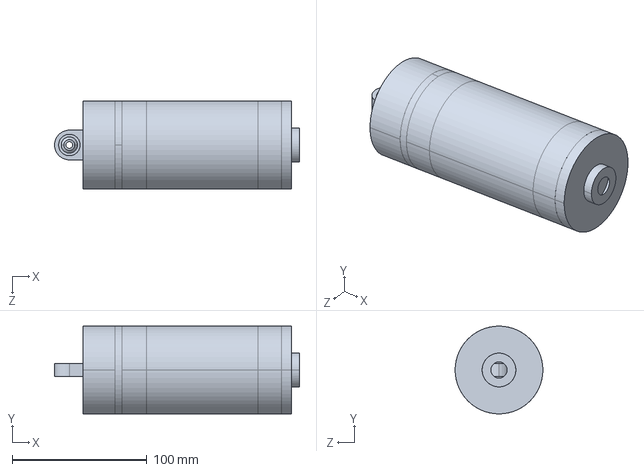
[picture p188: CAD file, 2024-02-25]
3D_models/V2.8_24.4.29-carbon/膝关节SEA801-188主体.SLDPRT
181.5 x 65.0 x 65.0 mm
