Pacificzhong/humanoid_robot/3D_models/V2.8_24.4.29-carbon/膝关节SEA801-188移动端.SLDPRT

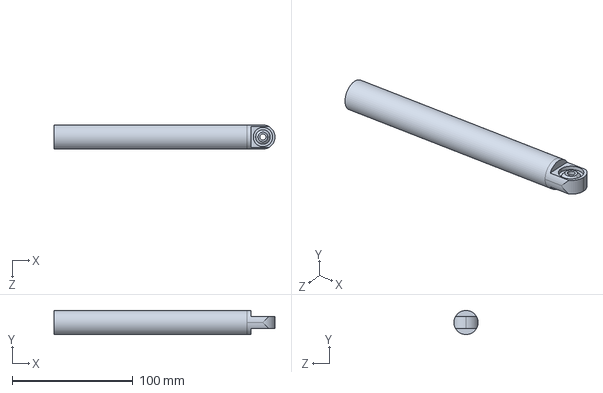
[picture p189: CAD file, 2024-02-25]
3D_models/V2.8_24.4.29-carbon/膝关节SEA801-188移动端.SLDPRT
183.0 x 20.0 x 20.0 mm
