Pacificzhong/humanoid_robot/3D_models/V2.8_24.4.29-carbon/轴用挡圈GB894-5.SLDPRT

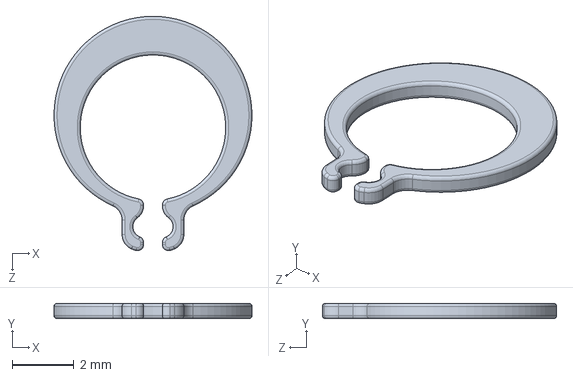
[picture p190: CAD file, 2024-02-25]
3D_models/V2.8_24.4.29-carbon/轴用挡圈GB894-5.SLDPRT
6.40 x 0.5 x 7.57 mm
