Pacificzhong/humanoid_robot/3D_models/V2.8_24.4.29-carbon/小腿左侧定脚踝安装板.SLDPRT

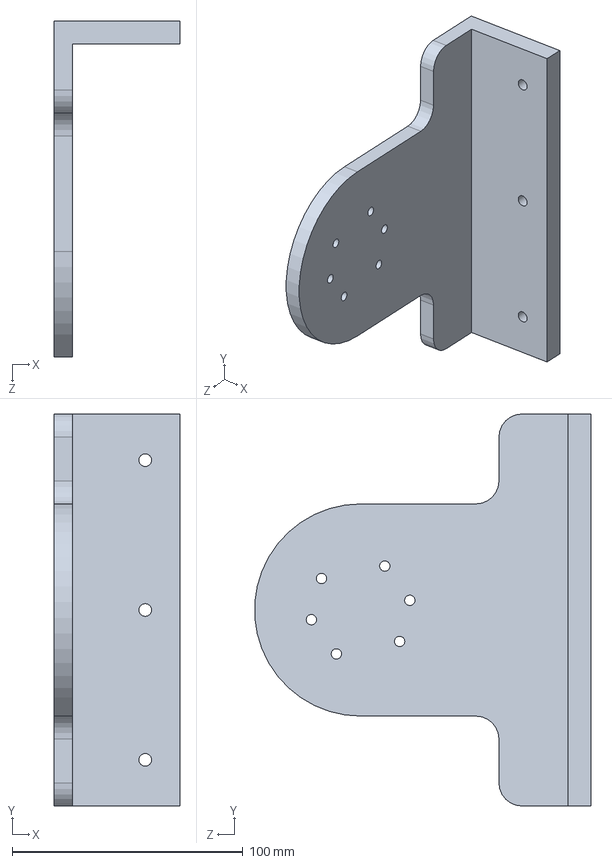
[picture p191: CAD file, 2024-02-25]
3D_models/V2.8_24.4.29-carbon/小腿左侧定脚踝安装板.SLDPRT
54.5 x 170.0 x 145.9 mm
