Pacificzhong/humanoid_robot/3D_models/V2.8_24.4.29-carbon/大腿主干_连接块.SLDPRT

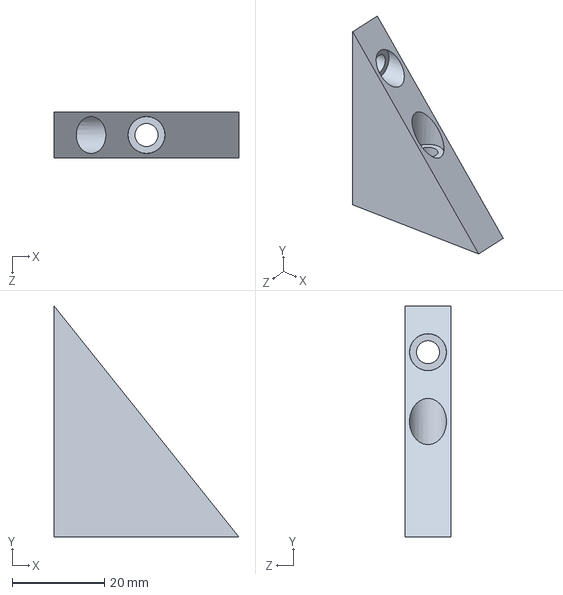
[picture p192: CAD file, 2024-02-22]
3D_models/V2.8_24.4.29-carbon/大腿主干_连接块.SLDPRT
40.0 x 50.0 x 10.0 mm
