Pacificzhong/humanoid_robot/(list of files, cad)

Other CAD files:
3D_models/V2.9及之后-膝关节四连杆布局.SLDASM
3D_models/V2.8及之前-膝关节四连杆布局.SLDASM
3D_models/V2.8_24.4.29-carbon/crus/小腿主干_外11.SLDPRT
3D_models/V2.8_24.4.29-carbon/crus/小腿主干_外10.SLDPRT
3D_models/Proto/大腿内侧板.SLDPRT
3D_models/V2.8_24.4.29-carbon/crus/小腿主干_外4.SLDPRT
3D_models/V2.8_24.4.29-carbon/crus/小腿主干_外5.SLDPRT
3D_models/V2.8_24.4.29-carbon/crus/小腿主干_外14.SLDPRT
3D_models/A1电机模型彭冲.STEP
3D_models/V2.8_24.4.29-carbon/crus/小腿主干_外2.SLDPRT
3D_models/V2.8_24.4.29-carbon/crus/小腿主干_外9-8.SLDPRT
3D_models/V2.8_24.4.29-carbon/crus/小腿主干_外6-7.SLDPRT
3D_models/V2.8_24.4.29-carbon/大腿榫卯-双板.SLDPRT
3D_models/V2.8_24.4.29-carbon/crus/小腿主干_外3.SLDPRT
3D_models/V2.8_24.4.29-carbon/crus/小腿主干_外13.SLDPRT
3D_models/V2.8_24.4.29-carbon/矮版上肢后板.SLDPRT
3D_models/V2.8_24.4.29-carbon/小腿左侧电机安装板A1.SLDPRT
3D_models/V2.8_24.4.29-carbon/A1电机.SLDPRT
3D_models/V2.8_24.4.29-carbon/镜向小腿左侧定脚踝安装板.SLDPRT
3D_models/V2.8_24.4.29-carbon/大腿主干_上板V2.SLDPRT
3D_models/V2.10_24.5.6/镜向小腿主干-电机嵌入式.SLDPRT
3D_models/V2.9_24.4.30/A1电机.SLDPRT
3D_models/V2.9_24.4.30/crus/小腿主干_外10.SLDPRT
3D_models/V2.9_24.4.30/crus/小腿主干_外11.SLDPRT
3D_models/V2.9_24.4.30/crus/小腿主干_外13.SLDPRT
3D_models/V2.9_24.4.30/crus/小腿主干_外14.SLDPRT
3D_models/V2.9_24.4.30/crus/小腿主干_外2.SLDPRT
3D_models/V2.9_24.4.30/crus/小腿主干_外3.SLDPRT
3D_models/V2.9_24.4.30/crus/小腿主干_外4.SLDPRT
3D_models/V2.9_24.4.30/crus/小腿主干_外5.SLDPRT
3D_models/V2.9_24.4.30/crus/小腿主干_外6-7.SLDPRT
3D_models/V2.9_24.4.30/crus/小腿主干_外9-8.SLDPRT
3D_models/V2.9_24.4.30/上肢侧板连接角码-3D打印.SLDPRT
3D_models/V2.9_24.4.30/上肢正面骨架.SLDPRT
3D_models/V2.9_24.4.30/上臂R1连接板.SLDPRT
3D_models/V2.9_24.4.30/上臂R2连接板.SLDPRT
3D_models/V2.9_24.4.30/上臂大臂连杆.SLDPRT
3D_models/V2.9_24.4.30/上臂小臂连杆.SLDPRT
3D_models/V2.9_24.4.30/大腿主干-适用于191-80推杆.SLDPRT
3D_models/V2.9_24.4.30/大腿主干_上板V2.SLDPRT
3D_models/V2.9_24.4.30/大腿榫卯-双板.SLDPRT
3D_models/V2.9_24.4.30/小腿主干.SLDPRT
3D_models/V2.9_24.4.30/小腿左侧电机安装板A1.SLDPRT
3D_models/V2.9_24.4.30/镜向小腿主干-电机嵌入式.SLDPRT
3D_models/V2.9_24.4.30/镜向小腿主干.SLDPRT
3D_models/V2.9_24.4.30/镜向小腿左侧定脚踝安装板.SLDPRT
3D_models/V2.9_24.4.30/髋一级连接板.SLDPRT
3D_models/V2.9_24.4.30/髋一级连接板V2.SLDPRT
3D_models/V2.9_24.4.30/髋一级连接板_B.SLDPRT
3D_models/V2.9_24.4.30/髋二级连接板_旋转.SLDPRT
3D_models/V2.9_24.4.30/髋关节侧摆连接板.SLDPRT
vreplearning/feet.STL
