Pacificzhong/humanoid_robot/component/参考执行器与第一版人形机器人模型/A-79822rev.H 外形图 SEA801-188.PDF

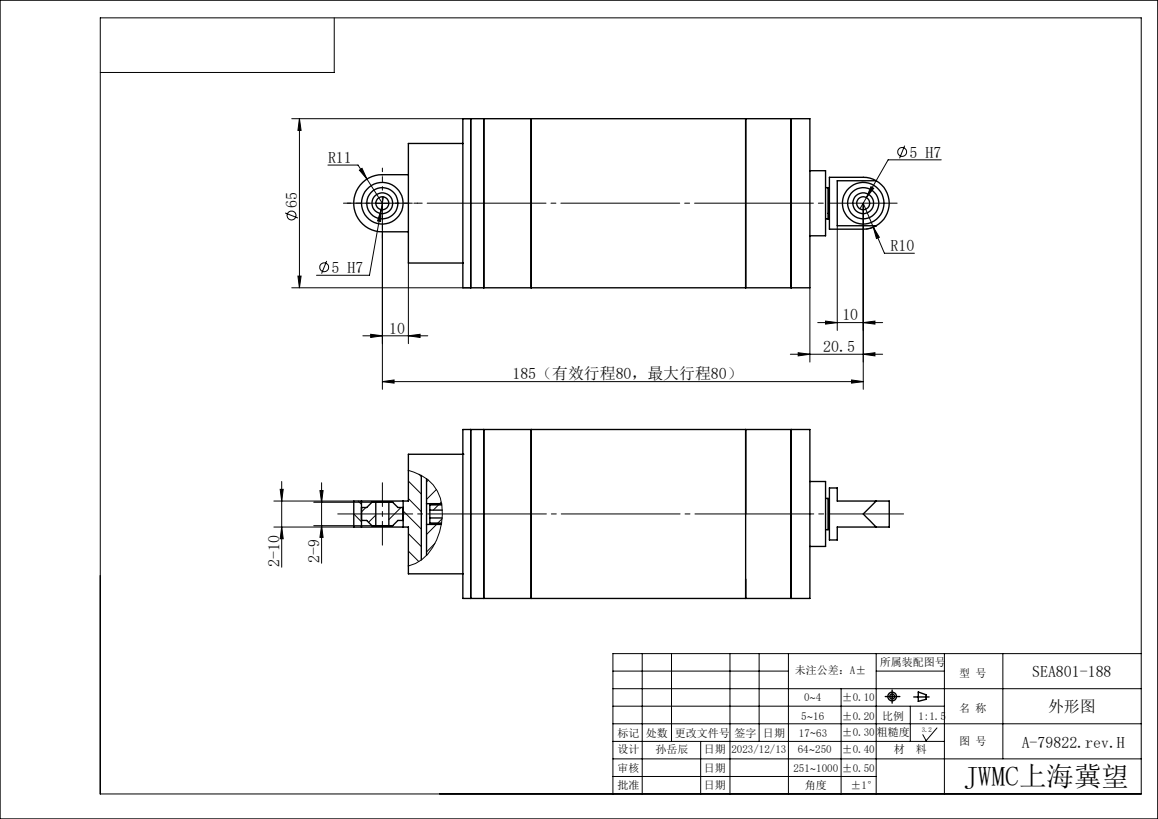
[picture p193: page 1]
2023/12/13 孙岳辰; A-79822.rev.H

标记 处数 更改文件号 签字
