Pacificzhong/humanoid_robot/component/参考执行器与第一版人形机器人模型/A-81138 外形图 SEA801-189.pdf

R10

## 5 H7

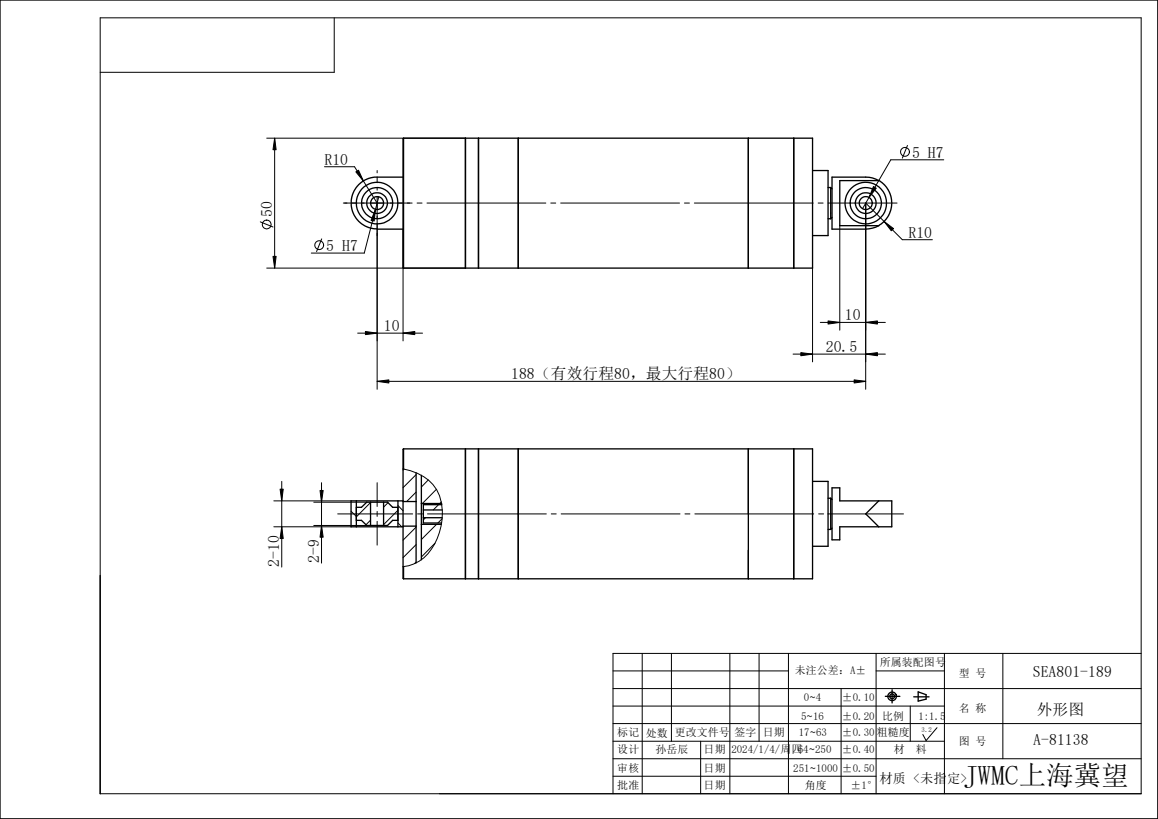
[picture p194: page 1]
188（有效行程80，最大行程80）; 未注公差：A±; 所属装配图号; SEA801-189

0~4 | ±0.10 | | | | 名 称 | 外形图
5~16 | ±0.20 | 比例 | 1:1.5

标记 | 处数 | 更改文件号 | 签字 | 日期 | 17~63 | ±0.30 | 粗糙度 | 3.2 | 图 号
设计 | 孙岳辰 | | | 64~250 | ±0.40 | 材 料
审核 | | 日期 | | 1000 | ±0.50 | 材质 <未指定>JWMC上海冀望 ²⁵¹~
批准 | | 日期 | | 角度 | ±1°
