Pacificzhong/humanoid_robot/others/人形机器人运动仿真与分析4.17笔记版.pdf

# 人形机器人运动学分析

# 一、下肢运动分析

## 1. 机器人运动学正解：


1 | 1
2 | 1 | 1 | 2 | 1 | 1
5 | 4 | 4 | 5 | 4 | 4
0, | 0
cos , | sin
cos , | sin
x | y
x | x | l | q y | y | l | q
x | x | l | q y | y | l | q
= | =
= | + | = | +
= | + | = | +

机器人重心位置：

( | )
( | )
1 1 | 2 3 | 3 5
1 | 2 | 3
1 1 | 2 3 | 3 5
1 | 2 | 3

1
,

1

m

m

x | m x | m x | m x
m | m | m
y | m y | m y | m y
m | m | m
= | + | +
+ | +
= | + | +
+ | +

## 机器人平衡位置判断：

x | x | x m
Î −Δ +Δ [ | , | ]

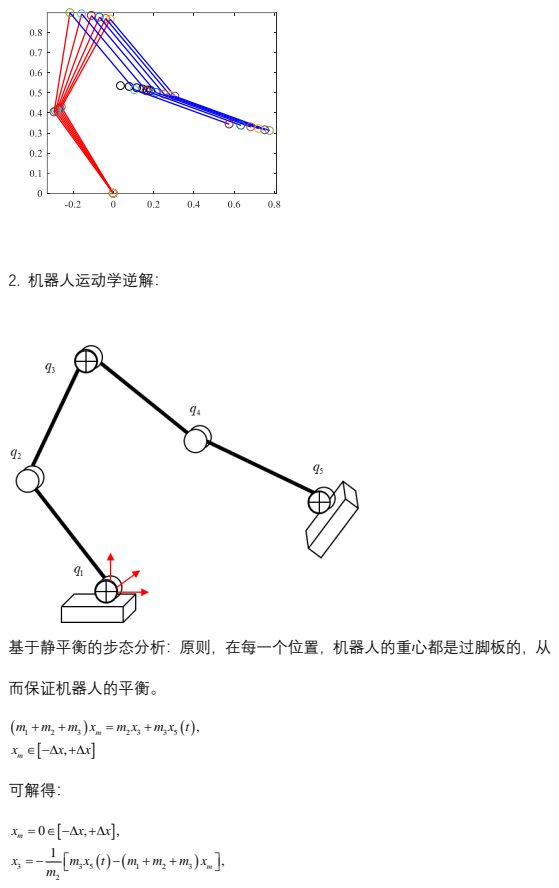
[picture p195: page 2]
2. 机器人运动学逆解：; 而保证机器人的平衡。; 可解得：

基于静平衡的步态分析：原则，在每一个位置，机器人的重心都是过脚板的，从


( | )
( | )
2 | 2 | 2
5 | 3 | 1
2 | 2 | 2
5 | 3 | 2
x | x | x | y | l ,
y | y | y | x | l
− | − Δ | + Δ | =
− | − Δ | + Δ | =

## 给定 y3，即可求解出 Dx 与 Dy 的数值。由此可见，为了保证机器人重心平衡，

## x3 是根据 x5 求解出来的。而 y3 有一定的变化范围，为了简单起见，我们假设

## y3 与上一时刻 y3 不变，但当三角关系不满足时，y3 进行调整，保证三角关系。

## 简单起见，也可以将判断条件写为，

( | ) ( | )
2 | 2 | 2 | 2
5 | 3 | 5 | 3 | 1 | 2 x | x | y | y | l | l − | + | − | ≤ | + ,

## 当上式满足条件时，则 y3 保留原来数值，否则，y3 向 y5 逼近。

## 为了进一步简化计算，我们可以假设 l1=l2,此时有，

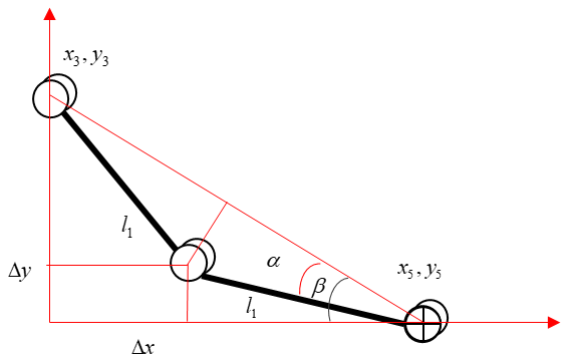
[picture p196: figure]

## 当 x5>x3 时，有

( | ) ( | )
( | ) ( | )

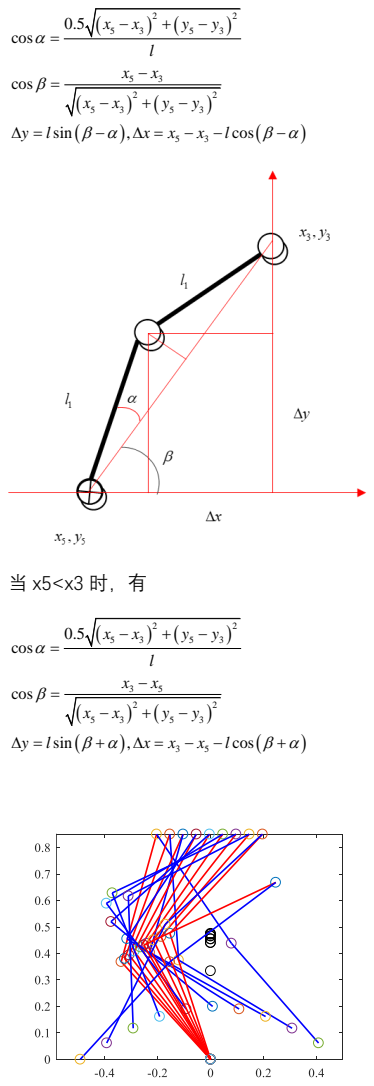
[picture p197: page 4]
cos; sin

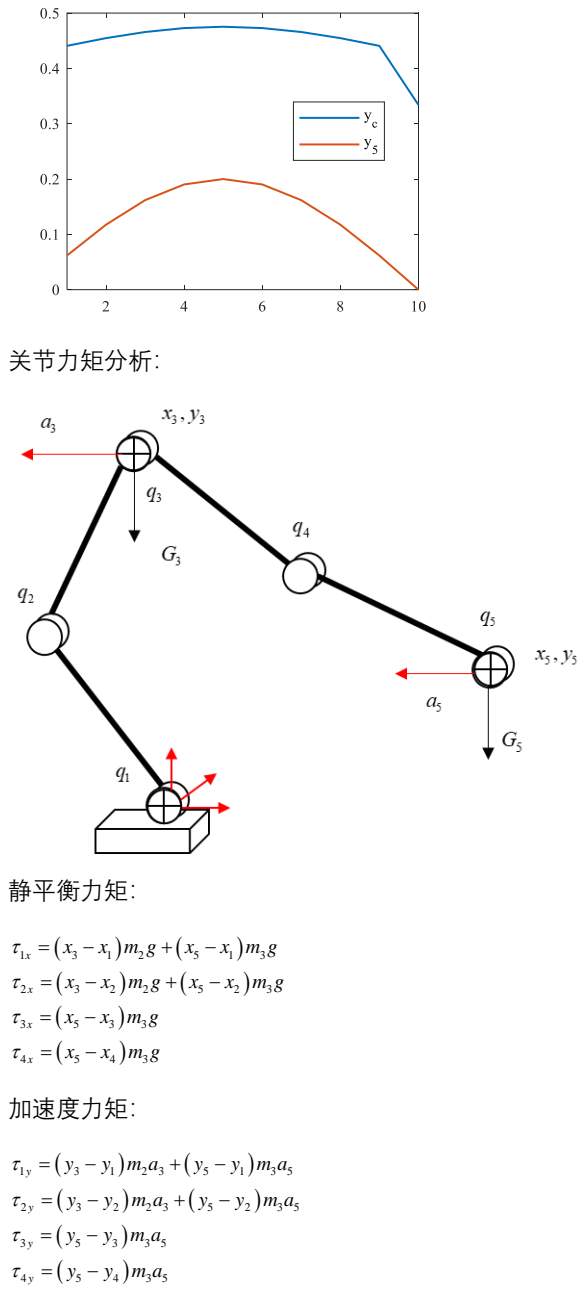
[picture p198: page 5]
关节力矩分析：; 静平衡力矩：; 加速度力矩：

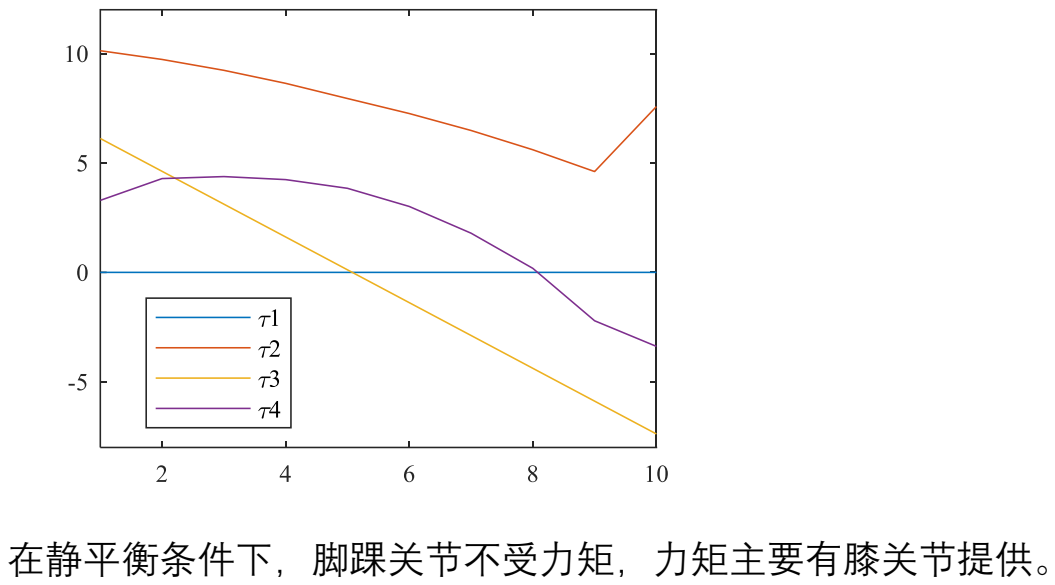
[picture p199: page 6]

在静平衡条件下，脚踝关节不受力矩，力矩主要有膝关节提供。

# 二、上肢运动分析

## 运动学逆解：

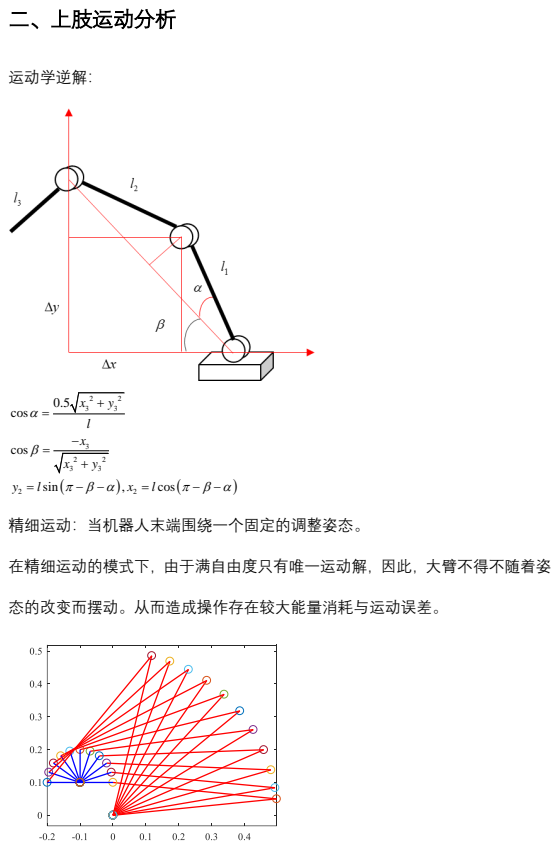
[picture p200: page 7]
cos; sin; 精细运动：当机器人末端围绕一个固定的调整姿态。; 态的改变而摆动。从而造成操作存在较大能量消耗与运动误差。

在精细运动的模式下，由于满自由度只有唯一运动解，因此，大臂不得不随着姿

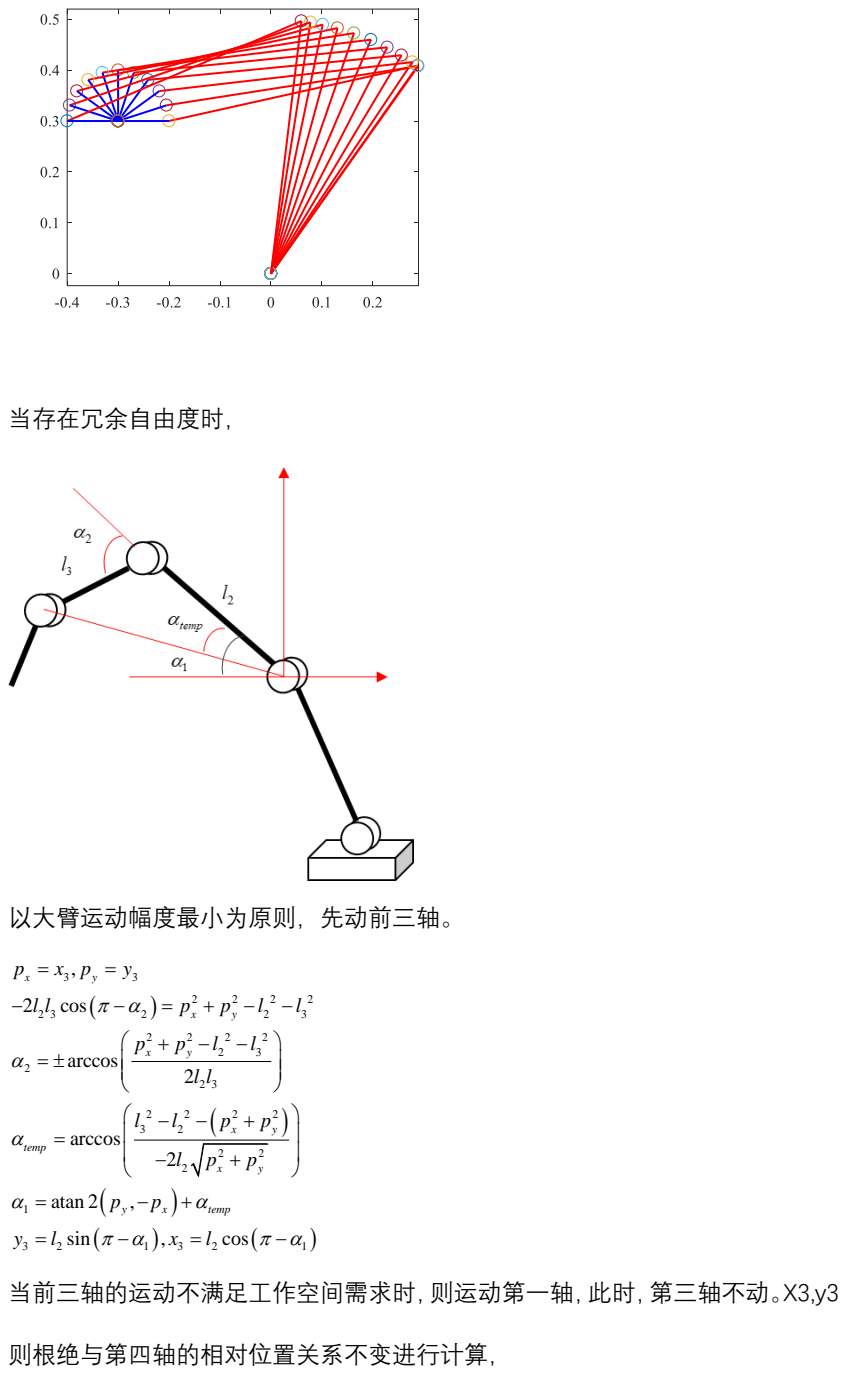
[picture p201: page 8]
当存在冗余自由度时，; 以大臂运动幅度最小为原则，先动前三轴。; cos; arccos; atan 2; sin; temp; 则根绝与第四轴的相对位置关系不变进行计算，

当前三轴的运动不满足工作空间需求时，则运动第一轴，此时，第三轴不动。X3,y3

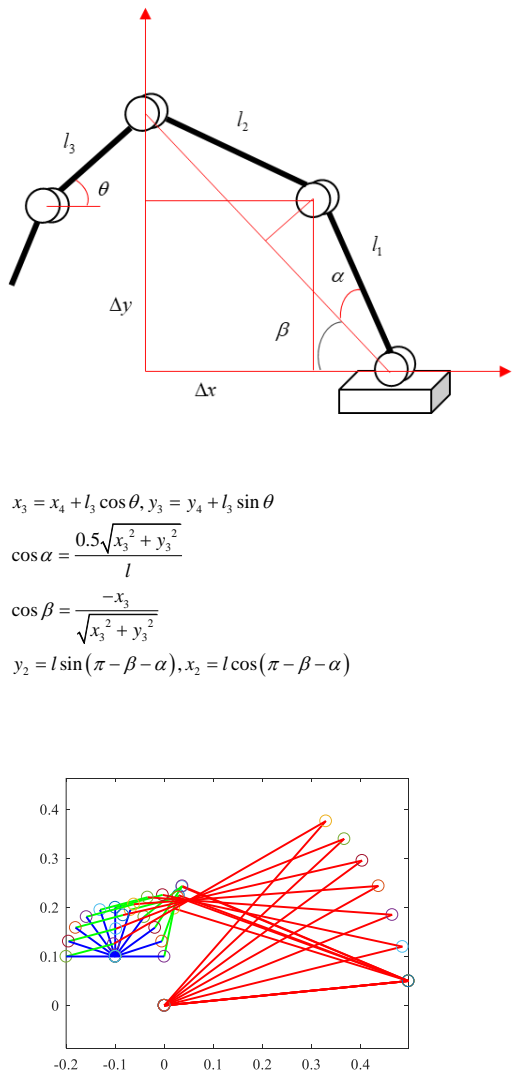
[picture p202: page 9]
cos ,; sin; cos

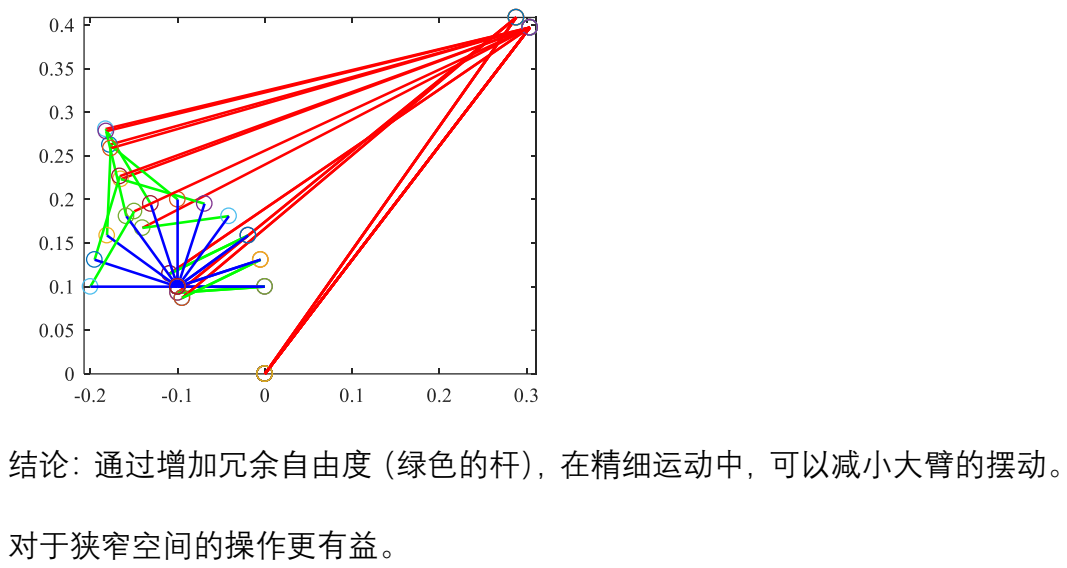
[picture p203: page 10]
对于狭窄空间的操作更有益。

结论：通过增加冗余自由度（绿色的杆），在精细运动中，可以减小大臂的摆动。

# 三、人形机器人运动分析


## 人形机器人操作时需要同时考虑操作精度与平衡性的问题。区别于传统的 AGV

## 移动机器人，重心能够较好的分布在移动平台上。人形机器人的承力点在脚板的

范围。

## 运动学正解：

,1 | ,1
,2 | ,1 | ,1 | ,1 | ,2 | ,1 | ,1 | ,1
,3 | ,2 | ,2 | ,2 | ,3 | ,2 | ,2 | ,2
,1 | ,3 | ,3 | ,3 | ,1 | ,3 | ,3 | ,3
,2 | ,1 | ,1 | ,1 | ,2 | ,1 | ,1 | ,1
,4 | ,3
0, | 0
cos | , | sin
cos | , | sin
cos | , | sin
cos | , | sin

l | l
l | l | l | l | l | l | l | l
l | l | l | l | l | l | l | l
u | l | l | l | u | l | l | l
u | u | u | u | u | u | u | u
u | u | u
x | y
x | x | l | q | y | y | l | q
x | x | l | q | y | y | l | q
x | x | l | q | y | y | l | q
x | x | l | q | y | y | l | q
x | x | l
= | =
= | + | = | +
= | + | = | +
= | + | = | +
= | + | = | +
= | + ,3 | ,3 | ,4 | ,1 | ,3 | ,3 cos | , | sin u | u | u | u | u
q | y | y | l | q = | +

## 运动学逆解：

## 根据末端从前往后计算，在手臂阶段，按照精细操作原则，其运动学逆解为，

( | )
( | )
( | )
( | ) | ( | )
3 | 3
2 | 2 | 2 | 2
2 3 | 2 | 2 | 3
2 | 2 | 2 | 2
2 | 3
2
23
2 | 2 | 2 | 2
3 | 2
2 | 2
2

1

3 | 2 | 1 | 3 | 2 | 1

,

2 cos

arccos
2

arccos
2
atan 2 | ,
sin | , | cos
x | y
x | y
x | y
x | y
temp
x | y
y | x | temp
p | x p | y
l l | p | p | l | l
p | p | l | l
ll
l | l | p | p
l | p | p
p | p
y | l | x | l

πα

α

α

α | α
π α | π α
= | =
− | − | = | + | − | −
æ | ö + | − | −
=± | ç | ÷
| è | | | | ø
æ | ö − | − | +
= | ç | ÷
− | + è | ø
= | − | +
= | − | = | −

## 当前三轴的运动不满足工作空间需求时，则运动第一轴，此时，第三轴不动。

( | ) | ( | )
3 | 4 | 3 | 3 | 4 | 3
2 | 2
3 | 3

3

2 | 2
3 | 3
2 | 2
cos , | sin

0.5
cos

cos

sin | , | cos
x | x | l | y | y | l
x | y
l
x
x | y
y | l | | | x | l
θ | θ

α

β

π β α | π β α
= | + | = | +

+
=

−
=
+
= | − − | = | − −

## 则腿部的运动要求为了保持平衡，需要满足平衡条件：

( ,1 | ,1 | ,3 | ,3 | ,1 | ,1 | ,2 | ,2 | ,4 | ,4 )
,1 | ,3 | ,1 | ,2 | ,4

1
,

0

m | l | l | l | l | u | u | u | u | u | u
l | l | u | u | u

m

x | m x | m x | m x | m x | m x
m | m | m | m | m

x

= | + | + | + | +
+ | + | + | +

=

## 由此可见，为了保证躯体平衡，同时，上半身由于操作需要也不能动，因此，只

## 能同步调节膝关节与髋关节，保持重心的平衡。则有，

,3 | ,1 | ,1 | ,2 | ,2 | ,4 | ,4 ( | )

,3

1

l | u | u | u | u | u | u
l
x | m x | m x | m x
m
= − | + | +

## 由于杆长的约束，可以直接求出 yl3，

2 | 2
l | l ,3 | 3 | ,3 y | l | x = − | −

## 进一步的，求解出 xu2,yu2

( | ) ( | )
( | ) ( | )
( | ) | ( | )
2 | 2
,3 | ,1 | ,3 | ,1
,1 | ,3
2 | 2
,3 | ,1 | ,3 | ,1
3 | 5

0.5
cos

cos

sin | , | cos
u | u | u | u
u | u
u | u | u | u
x | x | y | y

l
x | x
x | x | y | y
y l | x x | x | l

α

β

| β α | | | | β α
| | − | + | −
=
| | −
=
− | + | −
Δ = | + | Δ = | − | − | +

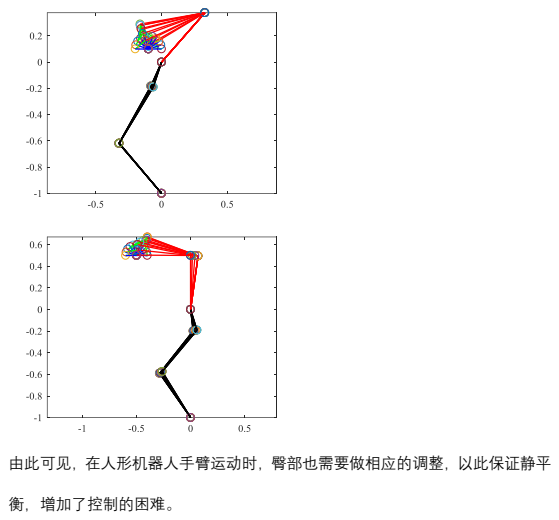
[picture p204: page 13]
衡，增加了控制的困难。

由此可见，在人形机器人手臂运动时，臀部也需要做相应的调整，以此保证静平

# 四、人形机器人下肢控制

1 | 1
2 | 1 | 1 | 1 | 2 | 1 | 1 | 1
3 | 2 | 2 | 2 | 3 | 2 | 2 | 2
5 | 4 | 4 | 4 | 5 | 4 | 4 | 4
0, | 0
| | | cos , | | | sin
cos , | sin
cos , | sin
x | y
x | x | l | q y | y | l | q
x | x | l | q y | y | l | q
x | x | l | q y | y | l | q
= | =
= | + | = | +
= | + | = | +
= | + | = | +

## 则机器人的雅克比矩阵为，

2 | | | | 1 | 1 1
3 | | | 1 | 1 1 | 2 | 2 2
4 | | 1 | 1 1 | 2 | 2 2 | 3 | 3 3
5 | 1 | 1 1 | 2 | 2 2 | 3 | 3 3 | 4 | 4 4

sin
sin | sin
| | sin | | sin | | sin
sin | sin | sin | sin
x | | | | l | q q
x | | | l | q q | l | q q
x | | l | q q | l | q q | l | q q
x | l | q q | l | q q | l | q q | l | q q
é ù é | ù −
ê ú ê | ú
− | − ê ú ê | ú =
ê ú ê | ú − | − | − ê ú ê | ú ë û ë | û ⁻ | − | − | −

，

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

cos
cos | cos
| | cos | | cos | | cos
cos | cos | cos | cos
y | | | | l | q q
y | l | q q | l | q q
y | | l | q q | l | q q | l | q q
y | l | q q | l | q q | l | q q | l | q q
é ù é | ù
ê ú ê | ú +
ê ú ê | ú =
ê ú ê | ú + | + ê ú ê | ú ë û ë | û ⁺ | + | +
[ | ]
[ | ]
[ | ]
2 | 3 | 4 | 5
2 | 3 | 4 | 5
1 | 2 | 3 | 4

,
x | | y

T

T

T

x | x | x | x
y | y | y | y
q | q | q | q
= | =

=

=

=

x J q y J q

x

y

q

## 为了让机器人能行走，其 x5,y5 需要跟随目标轨迹

x | g t y | g t
r | x | r | y ,5 | ,5
= | = ( ), | ( )

## 同时，机器人行走过程中，重心要求平衡，有：

( | )
( | )
1 1 | 2 3 | 3 5
1 | 2 | 3
1 1 | 2 3 | 3 5
1 | 2 | 3

1
,

1

m

m

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

## 当 xm 在 0 位时，

,3 | 3 5 ( ) | ( )

2

1
,
r
x | t | m x t
m

=−

## 则运动位置与目标位置的偏差为，

( ) | ( )
( ) | ( )
( ) | ( )
3 | ,3
5 | ,5
5 | ,5

r

r

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

e

## 为了设计控制器，我们先需要重构输入输出的雅克比矩阵，

3 | | | 1 | 1 1 | 2 | 2 2
5 | 1 | 1 1 | 2 | 2 2 | 3 | 3 3 | 4 | 4 4
5 | 1 | 1 1 | 2 | 2 2 | 3 | 3 3 | 4 | 4 4
sin | sin
sin | sin | sin | sin
cos | cos | cos | cos
x | | | l | q q | l | q q
x | l | q q | l | q q | l | q q | l | q q
y | l | q q | l | q q | l | q q | l | q q
é ù é | ù − | −
ê ú ê | ú
= − | − | − | − ê ú ê | ú
ê ú ê | ú ë û ë | û ⁺ | + | +

1
3 | 1 | 1 | 2 | 2
2
5 | 1 | 1 | 2 | 2 | 3 | 3 | 4 | 4
3
5 | 1 | 1 | 2 | 2 | 3 | 3 | 4 | 4
4
sin | sin | 0 | 0
sin | sin | sin | sin
cos | cos | cos | cos

out

q
x | l | q | l | q
q
x | l | q | l | q | l | q | l | q
q
y | l | q | l | q | l | q | l | q
q
éù é ù é | ù − | − | êú ê ú ê | úêú = − | − | − | − ê ú ê | úêú ê ú ê | ú ë û ë | ûêú ëû
y | Jq =

## 则控制器为，

( ) | ( )
( ) | ( )
( ) | ( )
3 | ,3
†
5 | ,5
5 | ,5

,

r

r

r

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

†
代表违逆。

## 稳定性证明：

## 设计李亚普洛夫函数为，

T V e e =

## 其导数为，

( ) | ( )
( ) | ( )

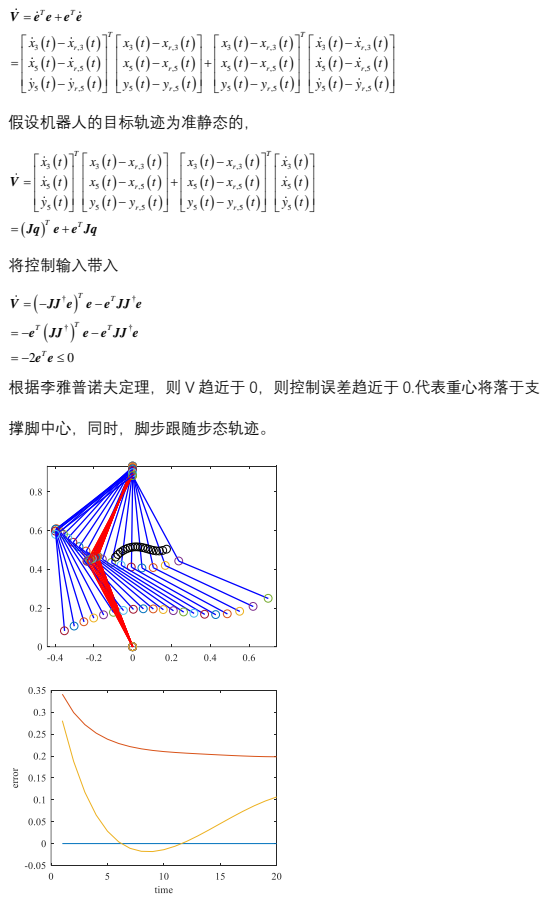
[picture p205: page 16]
假设机器人的目标轨迹为准静态的，; 将控制输入带入

根据李雅普诺夫定理，则 V 趋近于 0，则控制误差趋近于 0.代表重心将落于支

撑脚中心，同时，脚步跟随步态轨迹。

## 结论：采用控制的方法，可以不用求解逆解。其核心原因是，通过雅克比矩阵

## 逼近，求解逆解（此方法即为牛顿欧拉法通过数值解求解逆解）。同时，通过控

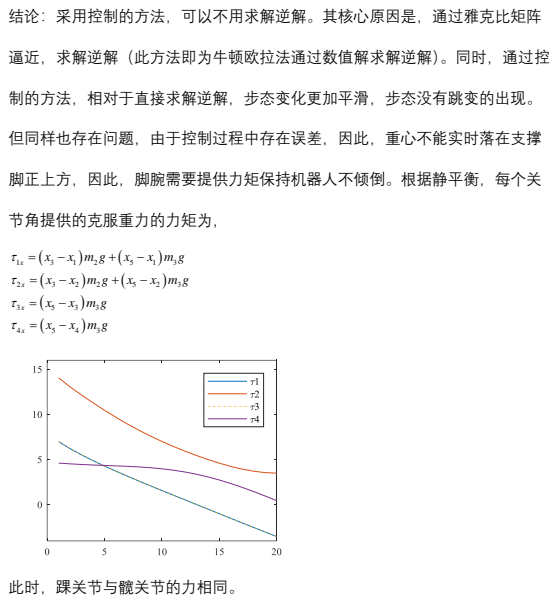
[picture p206: page 17]
节角提供的克服重力的力矩为，; 此时，踝关节与髋关节的力相同。

制的方法，相对于直接求解逆解，步态变化更加平滑，步态没有跳变的出现。

但同样也存在问题，由于控制过程中存在误差，因此，重心不能实时落在支撑

脚正上方，因此，脚腕需要提供力矩保持机器人不倾倒。根据静平衡，每个关

# 五、人形机器人运动控制

## 运动学正解：

,1 | ,1
,2 | ,1 | ,1 | ,1 | ,2 | ,1 | ,1 | ,1
,3 | ,2 | ,2 | ,2 | ,3 | ,2 | ,2 | ,2
,1 | ,3 | ,3 | ,3 | ,1 | ,3 | ,3 | ,3
,2 | ,1 | ,1 | ,1 | ,2 | ,1 | ,1 | ,1
,5 | ,4
0, | 0
sin | , | cos
sin | , | cos
sin | , | cos
sin | , | cos

l | l
l | l | l | l | l | l | l | l
l | l | l | l | l | l | l | l
u | l | l | l | u | l | l | l
u | u | u | u | u | u | u | u
u | u | u
x | y
x | x | l | q | y | y | l | q
x | x | l | q | y | y | l | q
x | x | l | q | y | y | l | q
x | x | l | q | y | y | l | q
x | x | l
= | =
= | + | = | +
= | + | = | +
= | + | = | +
= | + | = | +
= | + ,4 | ,4 | ,5 | ,4 | ,4 | ,4 sin | , | cos u | u | u | u | u
q | y | y | l | q = | +

## 则机器人的雅克比矩阵为，

,2 | | | | ,1 | ,1 | ,1
,3 | ,1 | ,1 | ,1 | ,2 | ,2 | ,2
,1 | ,1 | ,1 | ,1 | ,2 | ,2 | ,2 | ,3 | ,3 | ,3
,2 | ,1 | ,1 | ,1 | ,2 | ,2 | ,2 | ,3

,3

,4

,5

sin
| sin | sin
sin | sin | sin
sin | sin | s
l | l | l | l
l | l | l | l | l | l | l
u | l | l | l | l | l | l | l | l | l
u | l | l | l | l | l | l | l

u

u

u

x | | | l | q q
x | | l | q q | l | q q
x | l | q q | l | q q | l | q q
x | l | q q | l | q q | l
x
x
x
é | ù | −
ê | ú
− | − ê | ú
ê | ú | − | − | − ê | ú
= | − | − | − ê | ú
ê | ú
ê | ú
ê | ú
ê | ú ë | û
,3 | ,3 | ,1 | ,1 | ,1
,1 | ,1 | ,1 | ,2 | ,2 | ,2 | ,3 | ,3 | ,3 | ,1 | ,1 | ,1 | ,2 | ,2 | ,2
,1 | ,1 | ,1 | ,2 | ,2 | ,2 | ,3 | ,3 | ,3 | ,1 | ,1 | ,1 | ,2 | ,2 | ,2
in | sin
sin | sin | sin | sin | sin
sin | sin | sin | sin | sin
l | l | u | u | u
l | l | l | l | l | l | l | l | l | u | u | u | u | u | u
l | l | l | l | l | l | l | l | l | u | u | u | u | u | u
q q | l | q q
l | q q | l | q q | l | q q | l | q q | l | q q
l | q q | l | q q | l | q q | l | q q | l | q q | l

−
− | − | − | − | −
− | − | − | − | − | − ,3 | ,3 | ,3
,1 | ,1 | ,1 | ,2 | ,2 | ,2 | ,3 | ,3 | ,3 | ,1 | ,1 | ,1 | ,2 | ,2 | ,2 | ,3 | ,3 | ,3 | ,4 | ,4 | ,4

sin
sin | sin | sin | sin | sin | sin | sin
u | u | u
l | l | l | l | l | l | l | l | l | u | u | u | u | u | u | u | u | u | u | u | u

qq
l | q q | l | q q | l | q q | l | q q | l | q q | l | q q | l | q q
é | ù
ê | ú
− | − | − | − | − | − | − ë | û

，

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

cos
cos | cos
| | | cos | | | cos | | | cos
cos | cos | cos | cos
l | l | l | l
l | l | l | l | l | l | l
u | l | l | l | l | l | l | l | l | l
u | l | l | l | l | l | l | l | l | l | u | u
y | | | | l | q q
y | l | q q | l | q q
y | | l | q q | l | q q | l | q q
y | l | q q | l | q q | l | q q | l | q
é | ù
ê | ú | +
ê | ú
ê | ú = | + | + ê | ú
+ | + | + ê | ú
ê | ú ë | û
1 | ,1

u

q

é | | ù
ê | | ú
ê | | ú
ê | | ú
ê | | ú
ê | | ú
ê | ú ë | û

## 已知目标位置为 xu5,yu5 以及最后一个轴的姿态，则上肢第 4 轴 qu4 的位置

为，

,4 | ,5 | ,4 | 5 | ,4 | ,5 | ,4 | 5 cos , | sin u | u | u | u | u | u
x | x | l | y | y | l = | + | = | + θ | θ

## 根据机器人末端目标构造的目标函数为，

( ) | ( ) | ( ) | ( ) | ( ) | ( )
( ) | ( )
, ,5 | , ,5 | , ,5 | , ,5 | ,5 | ,5
, ,4 | , ,5 | ,4 | ,5 | , ,4 | , ,5 | ,4 | ,5
, | ,
cos | , | sin
r u | x u | r u | y u | r
r u | r u | u | r | r u | r u | u | r
x | t | g | t y | t | g | t | t | g | t
x | t | x | l | y | t | y | l
θ | θ
| | | | θ | | | | | θ
= | = | =
= | + | = | +

## 根据平衡条件有：

( ,1 | ,1 | ,3 | ,3 | ,1 | ,1 | ,2 | ,2 | ,4 | ,4 )
,1 | ,3 | ,1 | ,2 | ,4

1
,

0

m | l | l | l | l | u | u | u | u | u | u
l | l | u | u | u

m

x | m x | m x | m x | m x | m x
m | m | m | m | m

x

= | + | + | + | +
+ | + | + | +

=

## 上半身的运动由操作需求决定。重心调节主要依靠髋关节调节，有，

, ,3 | ,1 | ,1 | ,2 | ,2 | ,4 | ,4 ( ) | ( | )

,3

1

r l | u | u | u | u | u | u
l
x | t | m x | m x | m x
m
= − | + | +

## 则运动位置与目标位置的偏差为，

( ) | ( )
( ) | ( )
( ) | ( )
( ) | ( )
( ) | ( )
,3 | , ,3
,4 | , ,4
,4 | , ,4
,5 | , ,5
,5 | , ,5
l | r l
u | r u
u | r u
u | r u
u | r u
x | t | x | t
x | t | x | t
y | t | y | t
x | t | x | t
y | t | y | t
é | − | ù
ê | | ú
− ê | ú
= ê | ú −
ê | | ú
ê | ú ⁻
ê | ú − ë | û

e

## 为了设计控制器，我们先需要重构输入输出的雅克比矩阵，

,3 | ,1 | ,1 | ,1 | ,2 | ,2 | ,2
,4 | ,1 | ,1 | ,1 | ,2 | ,2 | ,2 | ,3 | ,3 | ,3 | ,1 | ,1 | ,1 | ,2 | ,2 | ,2 | ,3 | ,3 | ,3
,4 | ,1 | ,1 | ,1 | ,2

,5

,5

sin | sin
sin | sin | sin | sin | sin | sin
| cos | | | c
l | l | l | l | l | l | l
u | l | l | l | l | l | l | l | l | l | u | u | u | u | u | u | u | u | u
u | l | l | l | l

u

u

x | l | q q | l | q q
x | l | q q | l | q q | l | q q | l | q q | l | q q | l | q q
y | l | q q | l
x
y
é | ù | − | −
ê | ú
− | − | − | − | − | − ê | ú
ê | ú = | +
ê | ú
ê | ú
ê | ú ë | û
,2 | ,2 | ,3 | ,3 | ,3 | ,1 | ,1 | ,1 | ,2 | ,2 | ,2 | ,3 | ,3 | ,3
,1 | ,1 | ,1 | ,2 | ,2 | ,2 | ,3 | ,3 | ,3 | ,1 | ,1 | ,1 | ,2 | ,2 | ,2 | ,3 | ,3 | ,3 | ,4 | ,4 | ,4
os | cos | cos | cos | cos
sin | sin | sin | sin | sin | sin | sin
l | l | l | l | l | u | u | u | u | u | u | u | u | u
l | l | l | l | l | l | l | l | l | u | u | u | u | u | u | u | u | u | u | u | u

l

q q | l | q q | l | q q | l | q q | l | q q
l | q q | l | q q | l | q q | l | q q | l | q q | l | q q | l | q q
l
+ | + | + | +
− | − | − | − | − | − | −
,1 | ,1 | ,1 | ,2 | ,2 | ,2 | ,3 | ,3 | ,3 | ,1 | ,1 | ,1 | ,2 | ,2 | ,2 | ,3 | ,3 | ,3 | ,4 | ,4 | ,4 cos | cos | cos | cos | cos | cos | cos l | l | l | l | l | l | l | l | u | u | u | u | u | u | u | u | u | u | u | u q q | l | q q | l | q q | l | q q | l | q q | l | q q | l | q q
é | | | | | | | ù
ê | | | | | | | ú
ê | | | | | | | ú
ê | | | | | | | ú
ê | | | | | | | ú
ê | | | | | | | ú
ê | ú + | + | + | + | + | + ë | û

,3 | ,1 | ,1 | ,2 | ,2
,4 | ,1 | ,1 | ,2 | ,2 | ,3 | ,3 | ,1 | ,1 | ,2 | ,2 | ,3 | ,3
,4 | ,1 | ,1 | ,2 | ,2 | ,3 | ,3 | ,1 | ,1 | ,2 | ,2

,5

,5

sin | sin | 0 | 0 | 0 | 0 | 0
sin | sin | sin | sin | sin | sin | 0
| cos | | cos | | cos | | cos | | cos
l | l | l | l | l
u | l | l | l | l | l | l | u | u | u | u | u | u
u | l | l | l | l | l | l | u | u | u | u

u

u

x | l | q | l | q
x | l | q | l | q | l | q | l | q | l | q | l | q
y | l | q | l | q | l | q | l | q | l | q | l
x
y
é | ù | − | −
ê | ú
− | − | − | − | − | − ê | ú
ê | ú =
ê | ú
ê | ú
ê | ú ë | û

,1

,2

| | | | | | | | | | ,3 | ,3
,1 | ,1 | ,2 | ,2 | ,3 | ,3 | ,1 | ,1 | ,2 | ,2 | ,3 | ,3 | ,4 | ,4
,1 | ,1 | ,2 | ,2 | ,3 | ,3 | ,1 | ,1 | ,2 | ,2 | ,3 | ,3 | ,4 | ,4
cos | 0
sin | sin | sin | sin | sin | sin | sin
cos | | cos | | cos | | cos | | cos | | cos | | cos

l

l

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

q
q
q
q
l | q | l | q | l | q | l | q | l | q | l | q | l | q
l | q | l | q | l | q | l | q | l | q | l | q | l | q
é | ù
ê | ú
− | − | − | − | − | − | −
ë | û

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
é | | ù
ê | | ú
ê | | ú
ê | | ú
ê | | ú
ê | | ú
ê | | ú
ê | | ú
ê | | ú
ê | ú ë | û
y | Jq =

## 则控制器为，

( ) | ( )
( ) | ( )
( ) | ( )
( ) | ( )
( ) | ( )
,3 | , ,3
,4 | , ,4
†
,4 | , ,4
,5 | , ,5
,5 | , ,5

,

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

†
代表违逆。

## 稳定性证明：

## 设计李亚普洛夫函数为，

T V e e =

## 其导数为，

( )

T | T
T | T
= | +
= | +

V e e e e

Jq e e Jq

## 将控制输入带入

( )
( )
† | †
† | †
2 | 0

T
T

T
T | T

T

= − | −
= − | −
= − | ≤

V JJ e e e JJ e

e JJ e e JJ e

ee

## 根据李雅普诺夫定理，则 V 趋近于 0，则控制误差趋近于 0.代表重心将落于支

## 撑脚中心，同时，末端跟随指定轨迹。

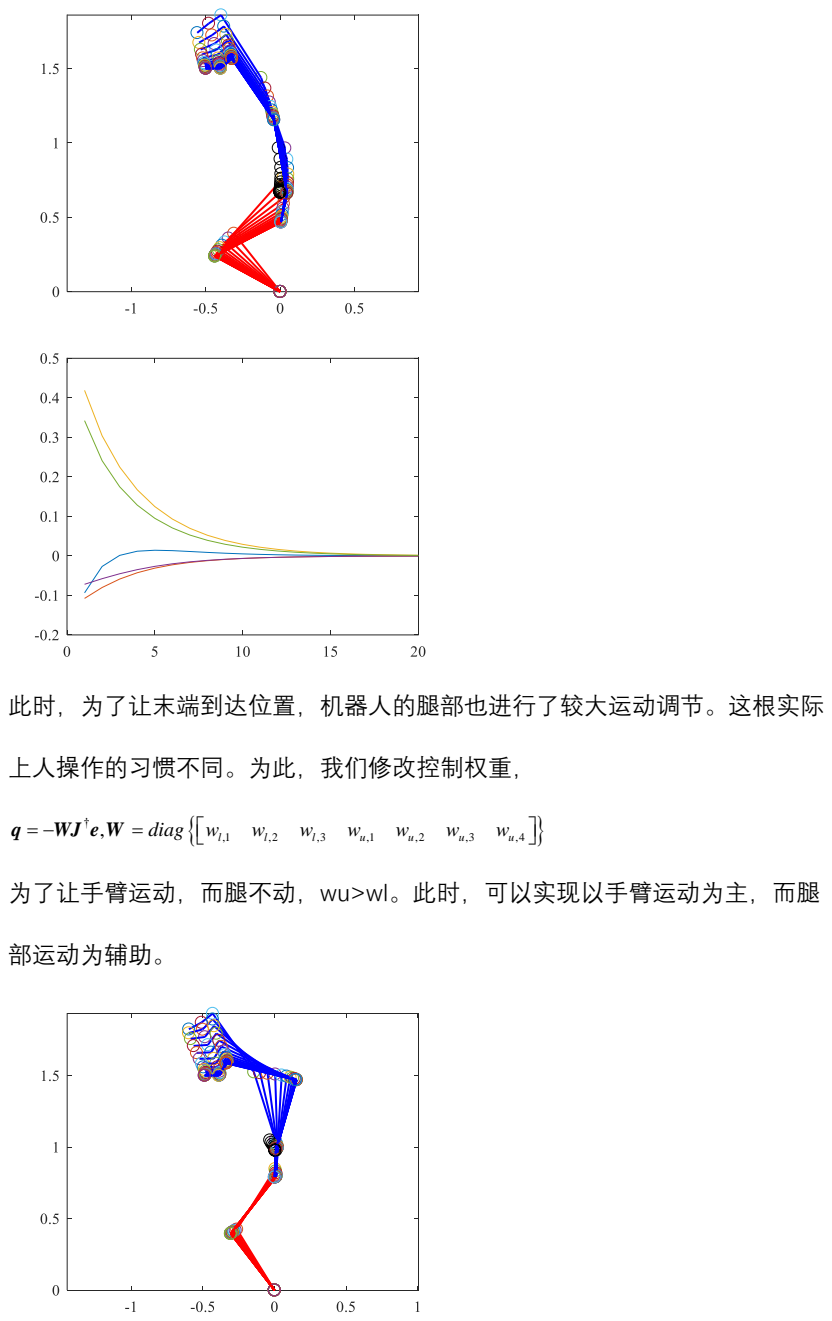
[picture p207: page 21]
= diag w; 部运动为辅助。

此时，为了让末端到达位置，机器人的腿部也进行了较大运动调节。这根实际

上人操作的习惯不同。为此，我们修改控制权重，

为了让手臂运动，而腿不动，wu>wl。此时，可以实现以手臂运动为主，而腿

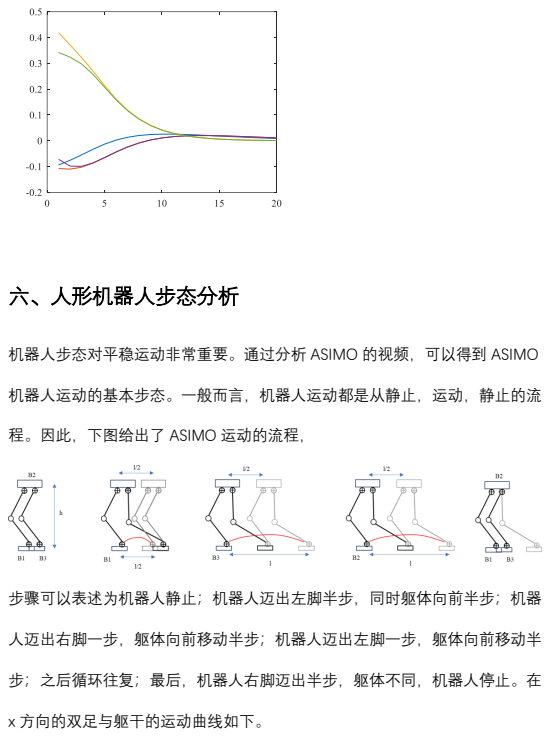
[picture p208: page 22]
六、人形机器人步态分析; x 方向的双足与躯干的运动曲线如下。

机器人步态对平稳运动非常重要。通过分析 ASIMO 的视频，可以得到 ASIMO

机器人运动的基本步态。一般而言，机器人运动都是从静止，运动，静止的流

程。因此，下图给出了 ASIMO 运动的流程，

步骤可以表述为机器人静止；机器人迈出左脚半步，同时躯体向前半步；机器

人迈出右脚一步，躯体向前移动半步；机器人迈出左脚一步，躯体向前移动半

步；之后循环往复；最后，机器人右脚迈出半步，躯体不同，机器人停止。在


## 从上图可以看出，双足交替运动，换支撑脚时，机器人的整体都是静止的。因

## 此，从外部观察，其实机器人运动是一顿一顿的。因此，更加理想的步态是机

## 器人的躯体保持匀速运动。

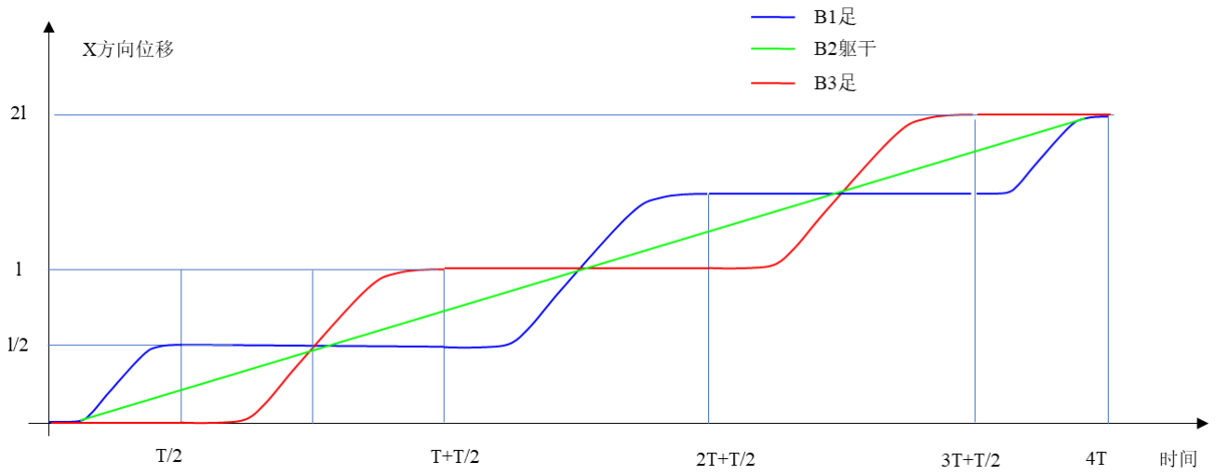
[picture p209: figure]

## 此时，躯体的运动一直位于两足之间，且整个运动过程中保持匀速运动。

## 为了描述双足机器人步态，我们设定足部运动函数与腰部运动函数。其中，腰

## 部运动函数为，

3

3

1
cos
2
| step | step
loop

t
x | L j | L
T

y h

π

| | æ | | | ö
= − | + | ç | ÷ ç | ÷ è | ø

=

足部的运动函数为，

ì | æ | ö ï− | + | ç | ÷
= | ç | ÷ í | è | ø ï

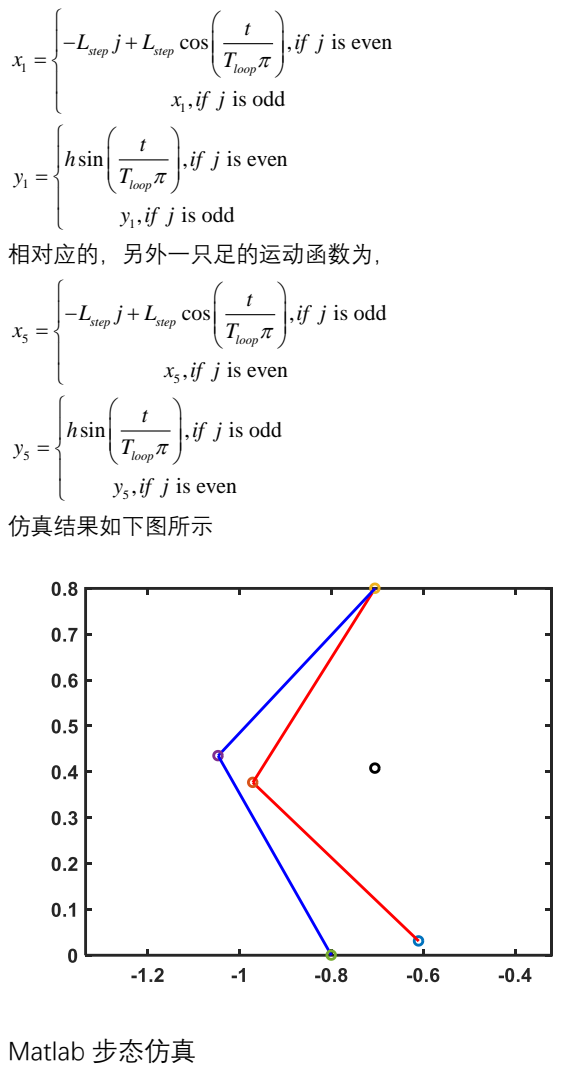
[picture p210: page 24]
cos; is even; is odd; sin; step; loop; 相对应的，另外一只足的运动函数为，; 仿真结果如下图所示; Matlab 步态仿真

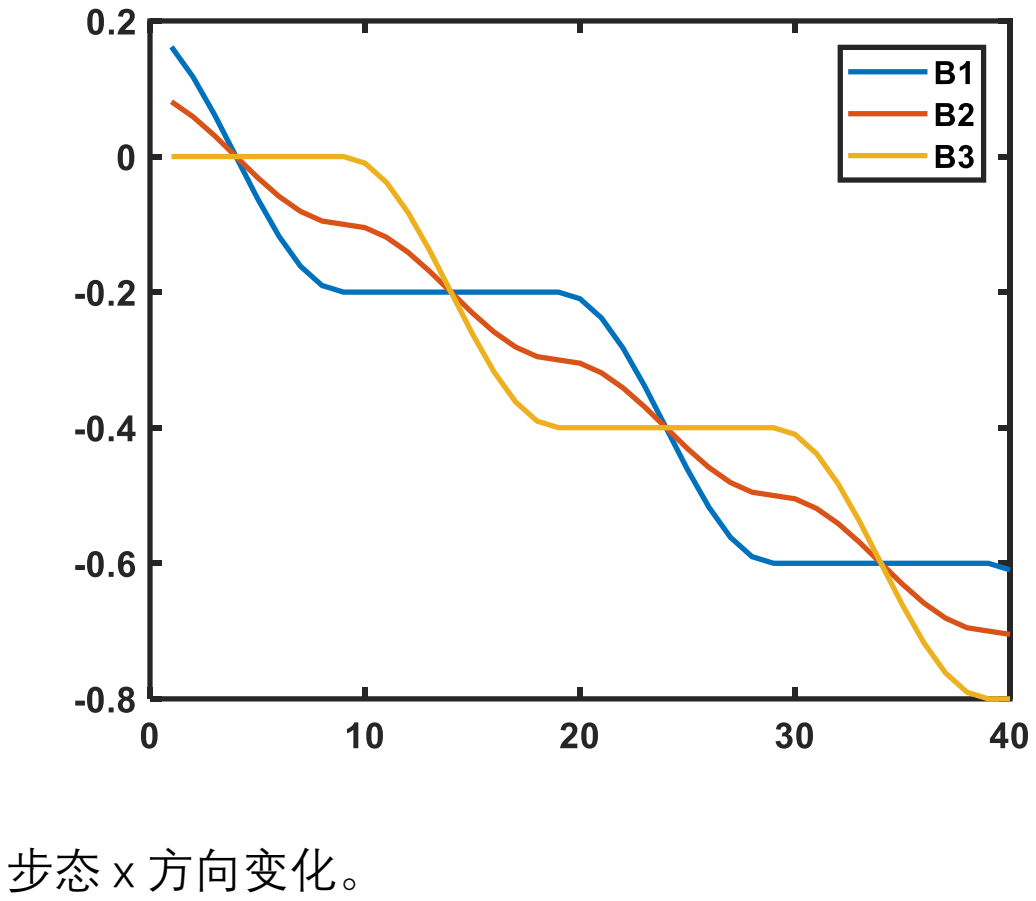
[picture p211: page 25]
步态 x 方向变化。

# 七、倒立摆稳定性分析

## 人形机器人稳定控制的原理与倒立摆控制类似。为此，首先分析倒立摆的稳定

## 控制原理。


## 倒立摆的模型如上图所示，通过线性化，可以得到其状态方程为，

t | t | t 1
x | Ax | bu + = | +

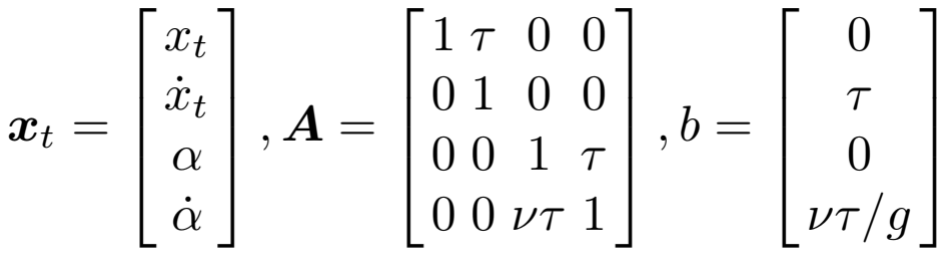
[picture p212: figure]

## 其控制器的真值为，

## 则控制器可以由强化学习进行学习获得。其表达式为，

T

u | KX
X | X
Q | P
u | u

=
é ù | | é ù
= ê ú | ê ú ë û | ë û

## 通过 Actor-critic 学习，可以得到控制器 K。然而，此时机器人的状态需要已

## 知，即小车的位置与速度，倒立摆的角度与角速度都要已知。然而，当我们有

## 限于硬件系统，小车的位置与速度未知时，传统的状态控制则会失效。因此，

## 我们会利用历史数据进行状态的扩充。

## 举例：原系统为

1

1 | 21 | 22
1 | 0
1
k | k
k
k | k
x | x
u
x | x A | A

τ +

+

é | ù | é ù é | ù | éù
= | + ê | ú | ê ú ê | ú | êú ë | û | ë û ë | û | ëû

## 当我们只能测量位置时，系统输出为，

k | k y | x =

## 通过对位移求差我们有，

k | k | k 1
y | y | x τ − | = −

则原系统可以变化为，

1

1 | 22 | 21 | 22
0 | 1 | 0
1 | 1
k | k
k
k | k
y | y
u
y | y A | A | A τ

−

+

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

## 因此，通过对变化后的系统进行强化学习即可。

## 同理，对于倒立摆系统而言，我们如果只关心倒立摆的角度，我们发现倒立摆

## 与小车的运动其实是解耦的，也就是倒立摆是否倾倒，与小车状态无关。则倒

## 立摆公式可以简化为，

1

1

1 | 0
1 | /
t | t
t
t | t

u
v | v | g
α | α τ
α | α τ | τ

+

+

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

## 由此，可以获得倒立摆的运动控制。

# 八、人形机器人稳定性分析

## 当系统变为双足系统后，可以将双足也转化为倒立摆。

## 首先，利用双杆动力学模型：


( ) | ( ) | ( )

( )

( )

( )

( )

( | ) ( | )
( | )
2 | 2 | 2 | 2
2 | 2
2 | 2 | 2
2
2 | 2 | 2
2 2 | 2 1 2
2
| 21
1 | 2 | 1
1 | 2
2 | cos | cos
cos
sin | 2 | sin
| sin
lg cos | | lg cos
| lg cos
M q q C q | G q
l m | llm | q | l m M | l m l m | q
Mq
l m l m | q | l m
ml | q q | ml | q q q
Cq
| ml | | q q
m | q | q | m M | q
Gq
m | q | q
+ | + | = τ
é | ù + | + | + | +
= ê | ú ë | û ⁺
é | ù − | −
= ê | ú ë | û
é | + | + | + | ù
= ê | | | | ú
+ ë | û

## 根据情况进行简化，平衡位置在 q1=90，q2=180.有，d_q1=d_q2=0

( ) | ( ) | ( )

( )

( )

( )

( | ) ( | )
| | ( | )

2

2

1 | 2 | 1
1 | 2

0
0

0
0
cos | cos
cos

M q q C q G q

lM
Mq
| lm

Cq

lmg | q | q | l m M g | q
Gq
lmg | q | q
+ | + | = τ
é | ù
= ê | ú ë | û

éù

### = êú ëû

é | + | + | + | ù
= ê | | | | ú
+ ë | û

## 简化后为

( | ) ( | )
( | )

2
1 | 1 | 2 | 1

2
2 | 1 | 2
cos | cos

cos

l Mq | lmg | q | q | l m M g | q
l mq | lmg | q | q | τ
= | + | + | +
= | + | +

## （详情见协作机器人教材 P41 页）

## 双足机器人可以视为两杆模型的一种特殊状态，如下图所示：

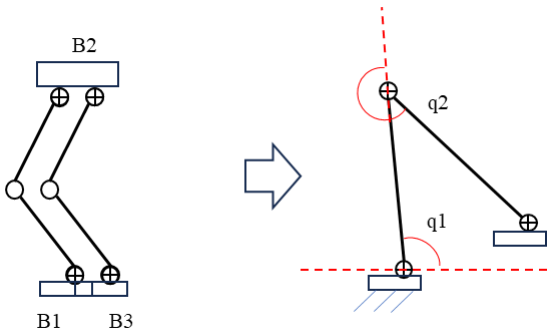
[picture p213: figure]

( | ) ( | )
( | )

2
1 | 1 | 2 | 1

2
2 | 1 | 2
cos | cos

cos

l Mq | lmg | q | q | l m M g | q
l mq | lmg | q | q | τ
= | + | + | +
= | + | +

## 将上式线性化并写成状态方程有，

( | )
( | )
( | )
( | ) | ( | )
2 | 1
1 | 1
2 | 1 | 2
1 | 1
2 | 1 | 2
2 | 2
2 | 2 | 2
2 | 2 1 | 2 | 1 | 2
0 | 1 | 0 | 0
1
sin | 0
1
0 | sin | 0 | 0
1
sin | 0

1
0 | 0 | 0 | 1
1 | 1 sin | 0 | sin | 0
l m M g | q q | q Ml | lmg | q | q
q | q Ml lmg | q | q | u
q | q Ml
q | q
ml
lmg | q | q | lmg | q | q
ml | ml
é | ù
ê | ú
− | + | é | ù é ù | é ù ê | ú ê ú | ê ú − | + | ê | ú
= | + − | + | ê | ú
ê | ú
ê | ú ë û | ë û ê | ú ë | û
− | + | − | + ë | û

## 当位于初始位置时，q1 为 90，q2 都为 180，有，

1 | 1
2 | | 2
1 | 1
2 | 2
2 | 2 | 2
2 | | 2
0 | 1 | 0 | 0 | 0
1 | 1 0 | 0 | 0
| | | | 0
0 | 0 | 0 | 1
| | | | 1
1 | 1 0 | 0
q | q
lMg | lmg
q | q Ml | Ml
u
q | q
q | q lmg | lmg | ml ml | ml
é | ù | é | ù ê | ú é ù | é ù ê | ú ê ú | ê ú ê | ú −
ê | ú ê | ú ê ú | ê ú = | + ê | ú ê | ú ê ú | ê ú ê | ú ê | ú ê ú | ê ú ê | ú ë û | ë û ê | ú
ê | ú | ê | ú ë | û ë | û

## 其离散化的系统为，

( | )
1, | 1 | 1,
1, | 1 | 1,
2, | 1 | 2,
2, | 1 | 2,
k | k
k | k
k
k | k
k | k
q | q
q | q
I | tA | tBu
q | q
q | q

+

+

+

+

é | ù | é | ù
ê | ú | ê | ú
ê | ú | ê | ú = | + Δ | + Δ ê | ú | ê | ú
ê | ú | ê | ú ê | ú | ê | ú ë | û | ë | û

## 其控制目标为α位于平衡位置，即，

## 对于上述控制问题，可以看成一个欠约束的控制问题。

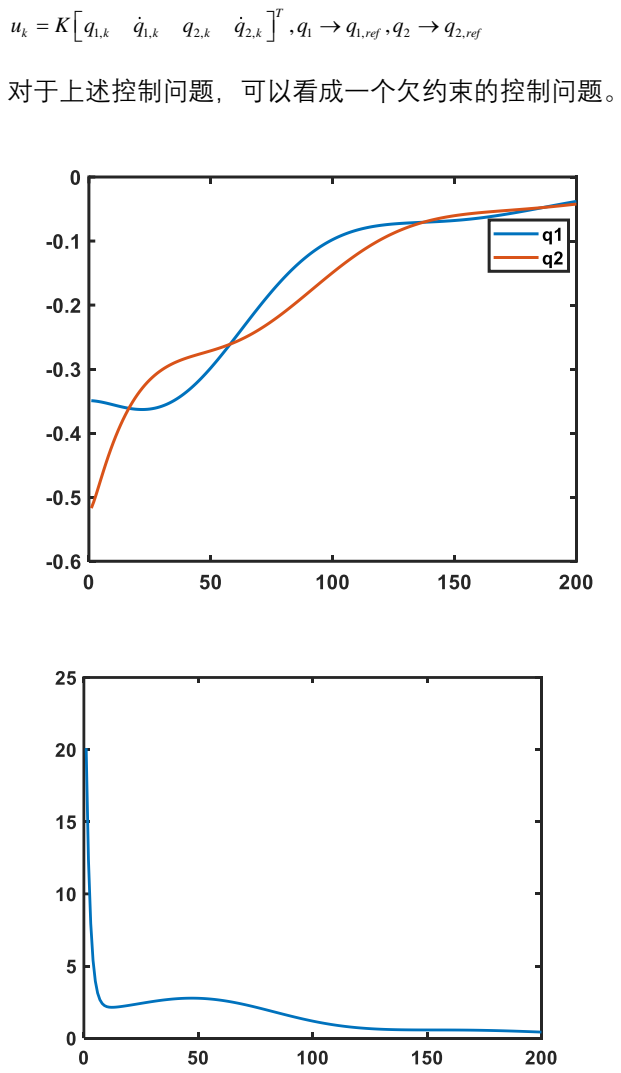
[picture p214: page 31]
ref; ref u

# 九、人形机器人强化学习控制

## 强化学习与经典的控制类似，只是在求解最优控制的时候，通过 critic- actor 的

## 理论进行求解。

## 因此，装填方程采用第八章的系统方程：

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

## 其离散化的系统为，

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

+

+

+

+

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

## 则强化学习的 Critic 构造为，（详情参见 zhao TIE 论文）

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
with | ,

v

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

X X
H
u | u

H H
H
H H

## 则 actor 的构造为，

i | 1
uu | ux
− K | H | H =

其迭代求解的表达式为，
( | )

1

2
+

N
i | i
ux | uu
k

H
N

α

=

Ñ | = K | H | K ∑

## 以下为求解结果：

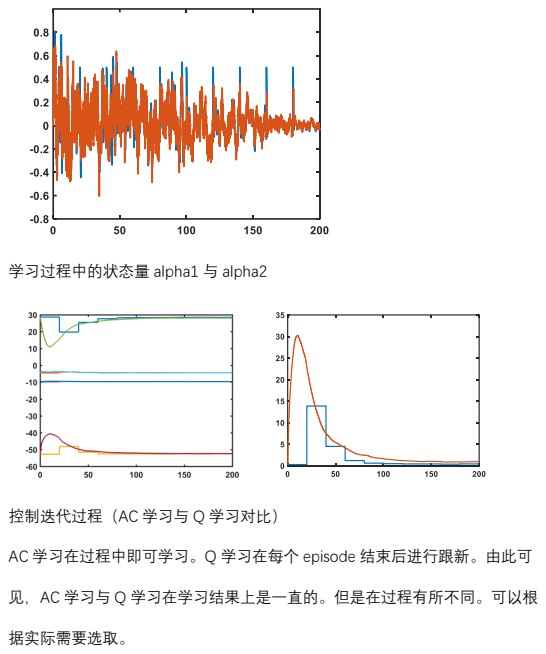
[picture p215: page 33]
学习过程中的状态量 alpha1 与 alpha2; 据实际需要选取。

控制迭代过程（AC 学习与 Q 学习对比）

AC 学习在过程中即可学习。Q 学习在每个 episode 结束后进行跟新。由此可

见，AC 学习与 Q 学习在学习结果上是一直的。但是在过程有所不同。可以根
