Pacificzhong/humanoid_robot/others/GPT/人型机器人下肢在结构设计与控制方面遇到的主要困难.pdf

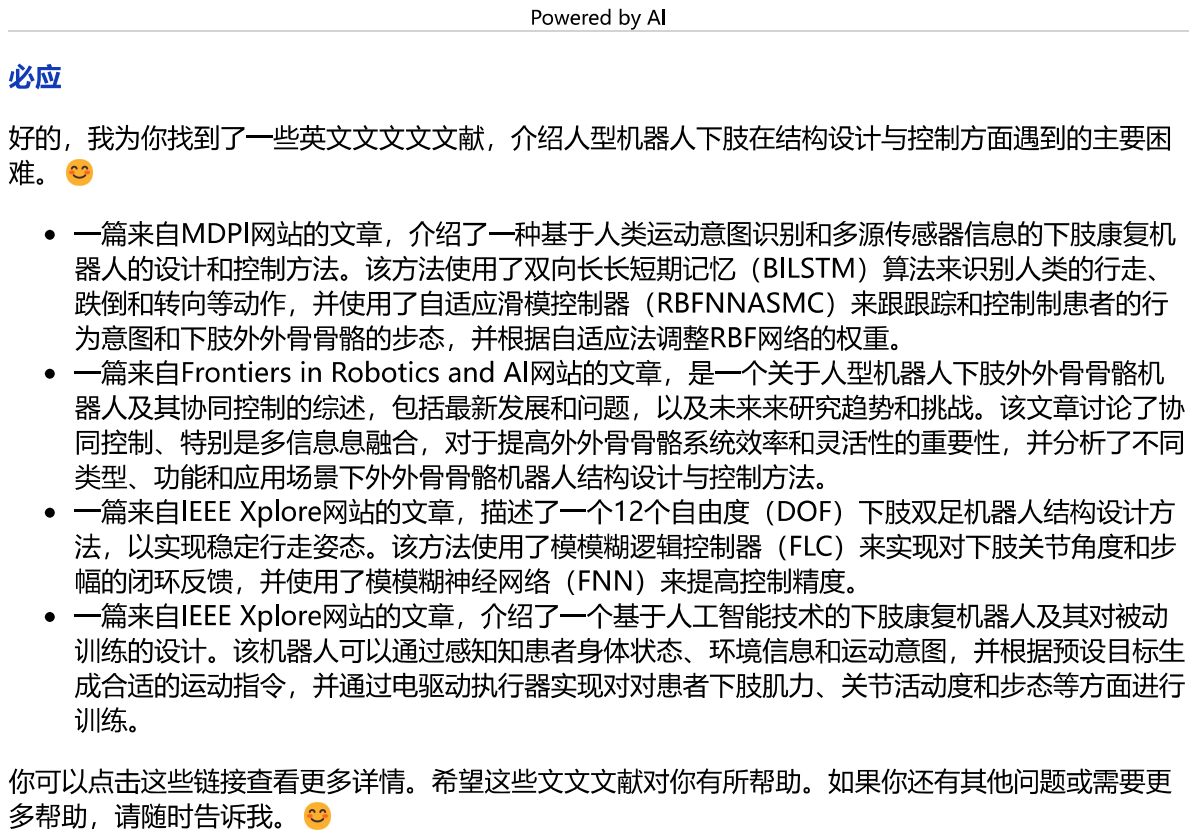
[picture p216: page 1]
