Pacificzhong/humanoid_robot/others/GPT/军事方面的应用.pdf

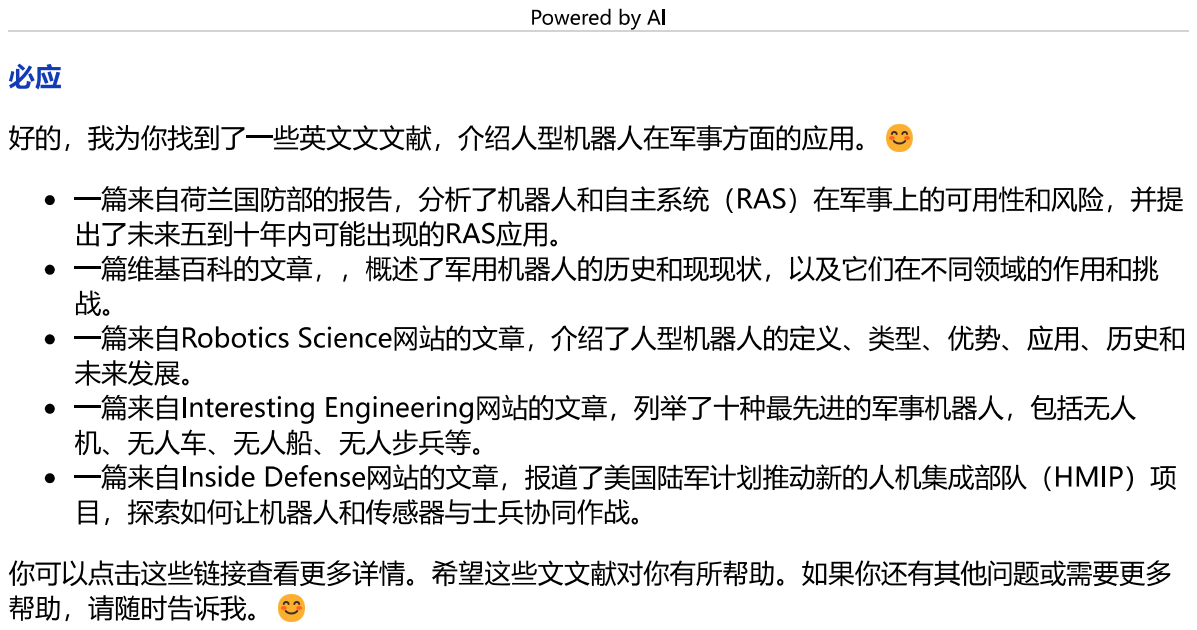
[picture p217: page 1]
