Pacificzhong/humanoid_robot/others/GPT/工业方面的应用.pdf

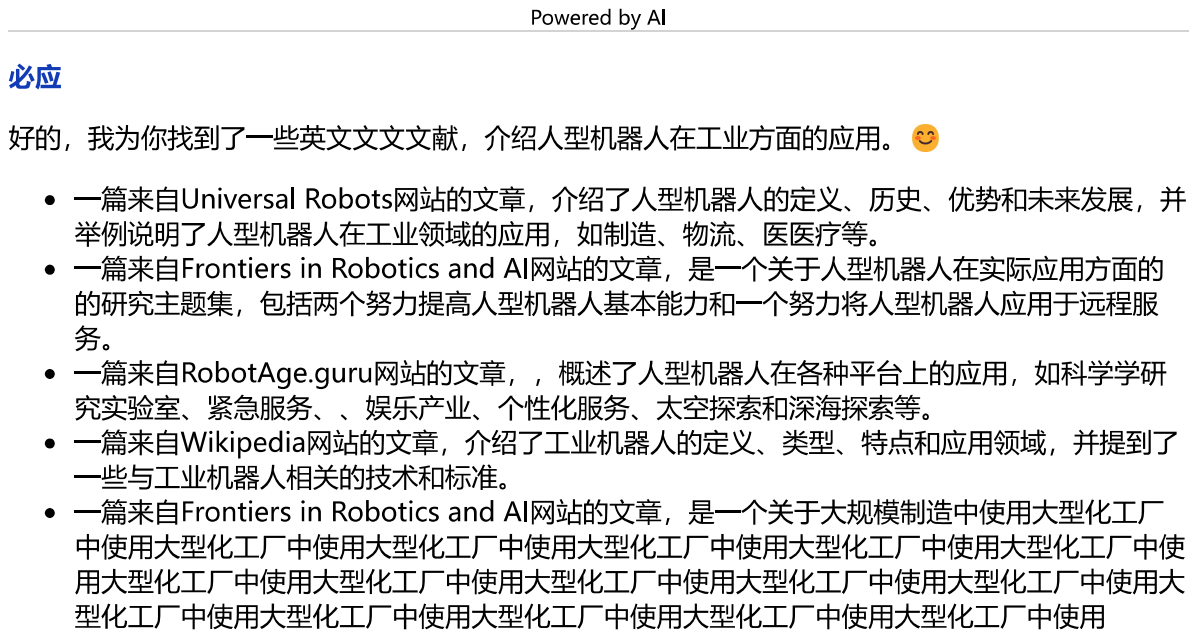
[picture p218: page 1]
