Pacificzhong/humanoid_robot/others/GPT/研究目的与意义copilot.pdf

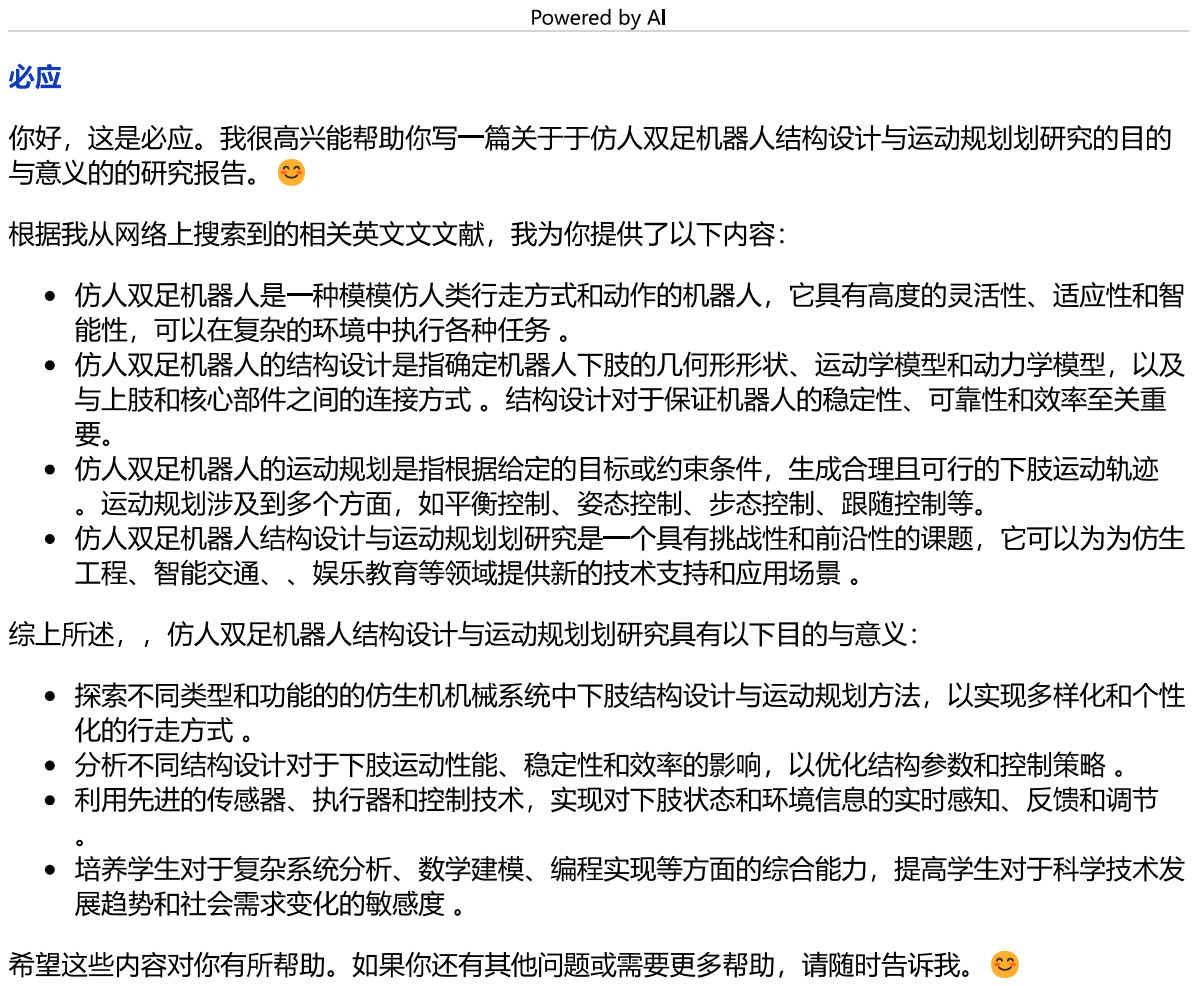
[picture p219: page 1]
