Pacificzhong/humanoid_robot/(commit log)

2024-01-08 24.1.8.11:05
    预览板优化完毕
    [M5防松螺母.SLDPRT, 垫圈_内5外10厚1.SLDPRT, 大腿主干.SLDPRT, 小腿主干.SLDPRT, 小腿后侧挡板.SLDPRT, 小腿外壳固定栓.SLDPRT, 小腿左侧电机安装板.SLDPRT, 小腿电机摇杆.SLDPRT]
2024-01-08 14：31
    [脚底板.SLDPRT, 轴套.SLDPRT]
2024-01-08 14：45
2024-01-10 V1.1
    第一版加工版，单腿7电机，全部使用宇树B1
    [A-79822rev.H 外形图 SEA801-XXX.step.SLDPRT, M5防松螺母.SLDPRT, 垫圈_内5外10厚1.SLDPRT, 大腿主干.SLDPRT, 小腿主干.SLDPRT, 小腿后侧挡板.SLDPRT, 小腿外壳固定栓.SLDPRT, 小腿左侧电机安装板.SLDPRT]
